CynaraKrewe/Cynara/Software/flow_tests/pinmux/summary.csv

Pin# | PORT IO | Function | Directions
33 | PA0 | U0RX
34 | PA1 | U0TX
