CynaraKrewe/Cynara/(threads)

Thread 3 (2016-05-07):

Create and connect all power planes and rails.

CynaraKrewe, 2016-05-07:

m-spiessens, 2016-05-25:
Includes +1.2V plane for FPGA.

m-spiessens, 2016-05-25:
Make the +5V selectable from either USB or the Power Petal.

Closed 2016-06-01.

Thread 6 (2016-05-10):

Shield & mounting holes

CynaraKrewe, 2016-05-10:

m-spiessens, 2016-06-29:
Fixed.

Closed 2016-06-29.

Thread 9 (2016-05-11):

documenting layer stack and trace impedance

CynaraKrewe, 2016-05-11:
documenting PCB propperties in latex

m-spiessens, 2016-05-27:
Updated documentation with the correct trace impedance.

Closed 2016-06-01.

Thread 11 (2016-05-18):

Replace USB type C connector with USB type B connector.

m-spiessens, 2016-05-18:
The first version of the Cynara carrier board shouldn't be too fancypants.

Closed 2016-05-25.

Thread 16 (2016-06-15):

Put jumpers to disconnect power planes for prototype.

m-spiessens, 2016-06-15:

m-spiessens, 2016-06-29:
Fixed.

Closed 2016-06-29.

Thread 20 (2016-10-04):

Fix text on silkscreen.

m-spiessens, 2016-10-04:

Thread 21 (2016-10-04):

Put vias to prevent antennas.

m-spiessens, 2016-10-04:
