CynaraKrewe/Cynara/Hardware/Cynara Viride.brd

## EAGLE design Hardware/Cynara Viride.brd (2016-10-19)

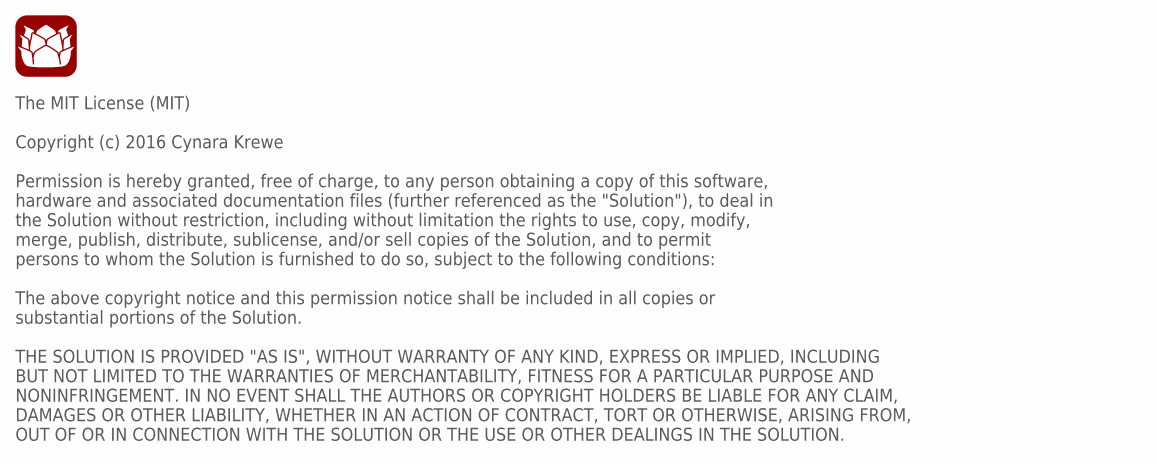
[picture p1: schematic Cynara Viride.sch, sheet 1, License]

Parts:
U$21: CYNARA_FRONT; CYNARA_BELOW_W15MM

Notes on the sheet:
The MIT License (MIT) Copyright (c) 2016 Cynara Krewe Permission is hereby granted, free of charge, to any person obtaining a copy of this software, hardware and associated documentation files (further referenced as the "Solution"), to deal in the Solution without restriction, including without lim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

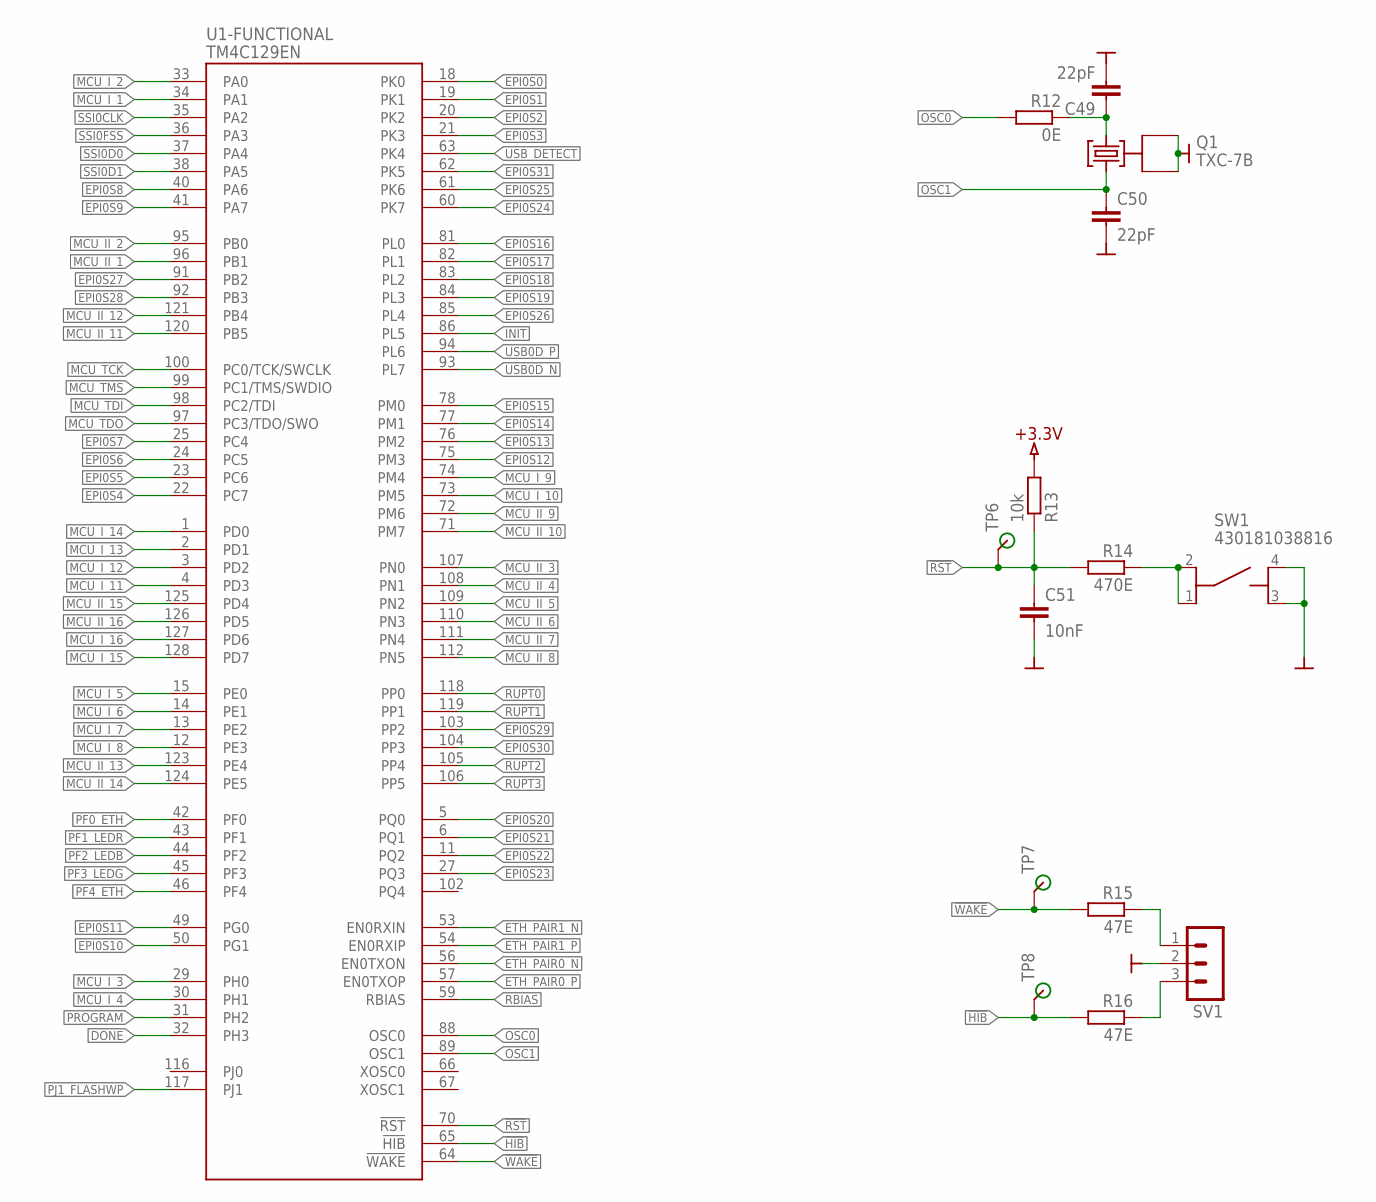
[picture p2: schematic Cynara Viride.sch, sheet 2, MCU: IO pins]

Parts:
C49, C50: 22pF; C0603
C51: 10nF; C0603
Q1: TXC-7B
R12: 0E; R0603
R13: 10k; R0603
R14: 470E; R0603
R15, R16: 47E; R0603
SV1: MA03-1
SW1: 430181038816
TP6, TP7, TP8: TP-SMD
U1: TM4C129EN; S-PQFP-G128

Connections:
!HIB: R16.2, TP8.1, U1.65 (!HIB)
!RST: C51.1, R13.1, R14.2, TP6.1, U1.70 (!RST); also elsewhere on the board
!WAKE: R15.2, TP7.1, U1.64 (!WAKE)
+3.3V: R13.2; also elsewhere on the board
DONE: U1.32 (PH3); also elsewhere on the board
EPI0S0: U1.18 (PK0); also elsewhere on the board
EPI0S1: U1.19 (PK1); also elsewhere on the board
EPI0S2: U1.20 (PK2); also elsewhere on the board
EPI0S3: U1.21 (PK3); also elsewhere on the board
EPI0S4: U1.22 (PC7); also elsewhere on the board
EPI0S5: U1.23 (PC6); also elsewhere on the board
EPI0S6: U1.24 (PC5); also elsewhere on the board
EPI0S7: U1.25 (PC4); also elsewhere on the board
EPI0S8: U1.40 (PA6); also elsewhere on the board
EPI0S9: U1.41 (PA7); also elsewhere on the board
EPI0S10: U1.50 (PG1); also elsewhere on the board
EPI0S11: U1.49 (PG0); also elsewhere on the board
EPI0S12: U1.75 (PM3); also elsewhere on the board
EPI0S13: U1.76 (PM2); also elsewhere on the board
EPI0S14: U1.77 (PM1); also elsewhere on the board
EPI0S15: U1.78 (PM0); also elsewhere on the board
EPI0S16: U1.81 (PL0); also elsewhere on the board
EPI0S17: U1.82 (PL1); also elsewhere on the board
EPI0S18: U1.83 (PL2); also elsewhere on the board
EPI0S19: U1.84 (PL3); also elsewhere on the board
EPI0S20: U1.5 (PQ0); also elsewhere on the board
EPI0S21: U1.6 (PQ1); also elsewhere on the board
EPI0S22: U1.11 (PQ2); also elsewhere on the board
EPI0S23: U1.27 (PQ3); also elsewhere on the board
EPI0S24: U1.60 (PK7); also elsewhere on the board
EPI0S25: U1.61 (PK6); also elsewhere on the board
EPI0S26: U1.85 (PL4); also elsewhere on the board
EPI0S27: U1.91 (PB2); also elsewhere on the board
EPI0S28: U1.92 (PB3); also elsewhere on the board
EPI0S29: U1.103 (PP2); also elsewhere on the board
EPI0S30: U1.104 (PP3); also elsewhere on the board
EPI0S31: U1.62 (PK5); also elsewhere on the board
ETH_PAIR0_N: U1.56 (EN0TXON); also elsewhere on the board
ETH_PAIR0_P: U1.57 (EN0TXOP); also elsewhere on the board
ETH_PAIR1_N: U1.53 (EN0RXIN); also elsewhere on the board
ETH_PAIR1_P: U1.54 (EN0RXIP); also elsewhere on the board
GND: C49.2, C50.2, C51.2, Q1.2 (GND), Q1.4 (GND), SV1.2, SW1.3, SW1.4; also elsewhere on the board
INIT: U1.86 (PL5); also elsewhere on the board
MCU_II_1: U1.96 (PB1); also elsewhere on the board
MCU_II_2: U1.95 (PB0); also elsewhere on the board
MCU_II_3: U1.107 (PN0); also elsewhere on the board
MCU_II_4: U1.108 (PN1); also elsewhere on the board
MCU_II_5: U1.109 (PN2); also elsewhere on the board
MCU_II_6: U1.110 (PN3); also elsewhere on the board
MCU_II_7: U1.111 (PN4); also elsewhere on the board
MCU_II_8: U1.112 (PN5); also elsewhere on the board
MCU_II_9: U1.72 (PM6); also elsewhere on the board
MCU_II_10: U1.71 (PM7); also elsewhere on the board
MCU_II_11: U1.120 (PB5); also elsewhere on the board
MCU_II_12: U1.121 (PB4); also elsewhere on the board
MCU_II_13: U1.123 (PE4); also elsewhere on the board
MCU_II_14: U1.124 (PE5); also elsewhere on the board
MCU_II_15: U1.125 (PD4); also elsewhere on the board
MCU_II_16: U1.126 (PD5); also elsewhere on the board
MCU_I_1: U1.34 (PA1); also elsewhere on the board
MCU_I_2: U1.33 (PA0); also elsewhere on the board
MCU_I_3: U1.29 (PH0); also elsewhere on the board
MCU_I_4: U1.30 (PH1); also elsewhere on the board
MCU_I_5: U1.15 (PE0); also elsewhere on the board
MCU_I_6: U1.14 (PE1); also elsewhere on the board
MCU_I_7: U1.13 (PE2); also elsewhere on the board
MCU_I_8: U1.12 (PE3); also elsewhere on the board
MCU_I_9: U1.74 (PM4); also elsewhere on the board
MCU_I_10: U1.73 (PM5); also elsewhere on the board
MCU_I_11: U1.4 (PD3); also elsewhere on the board
MCU_I_12: U1.3 (PD2); also elsewhere on the board
MCU_I_13: U1.2 (PD1); also elsewhere on the board
MCU_I_14: U1.1 (PD0); also elsewhere on the board
MCU_I_15: U1.128 (PD7); also elsewhere on the board
MCU_I_16: U1.127 (PD6); also elsewhere on the board
MCU_TCK: U1.100 (PC0/TCK/SWCLK); also elsewhere on the board
MCU_TDI: U1.98 (PC2/TDI); also elsewhere on the board
MCU_TDO: U1.97 (PC3/TDO/SWO); also elsewhere on the board
MCU_TMS: U1.99 (PC1/TMS/SWDIO); also elsewhere on the board
unnamed: R15.1, SV1.1
unnamed: C49.1, Q1.1 (XTALA), R12.1
unnamed: R14.1, SW1.1, SW1.2
unnamed: R16.1, SV1.3
OSC0: R12.2, U1.88 (OSC0)
OSC1: C50.1, Q1.3 (XTALB), U1.89 (OSC1)
PF0_ETH: U1.42 (PF0); also elsewhere on the board
PF1_LEDR: U1.43 (PF1); also elsewhere on the board
PF2_LEDB: U1.44 (PF2); also elsewhere on the board
PF3_LEDG: U1.45 (PF3); also elsewhere on the board
PF4_ETH: U1.46 (PF4); also elsewhere on the board
PJ1_FLASHWP: U1.117 (PJ1); also elsewhere on the board
PROGRAM: U1.31 (PH2); also elsewhere on the board
RBIAS: U1.59 (RBIAS); also elsewhere on the board
RUPT0: U1.118 (PP0); also elsewhere on the board
RUPT1: U1.119 (PP1); also elsewhere on the board
RUPT2: U1.105 (PP4); also elsewhere on the board
RUPT3: U1.106 (PP5); also elsewhere on the board
SSI0CLK: U1.35 (PA2); also elsewhere on the board
SSI0D0: U1.37 (PA4); also elsewhere on the board
SSI0D1: U1.38 (PA5); also elsewhere on the board
SSI0FSS: U1.36 (PA3); also elsewhere on the board
USB0D_N: U1.93 (PL7); also elsewhere on the board
USB0D_P: U1.94 (PL6); also elsewhere on the board
USB_DETECT: U1.63 (PK4); also elsewhere on the board

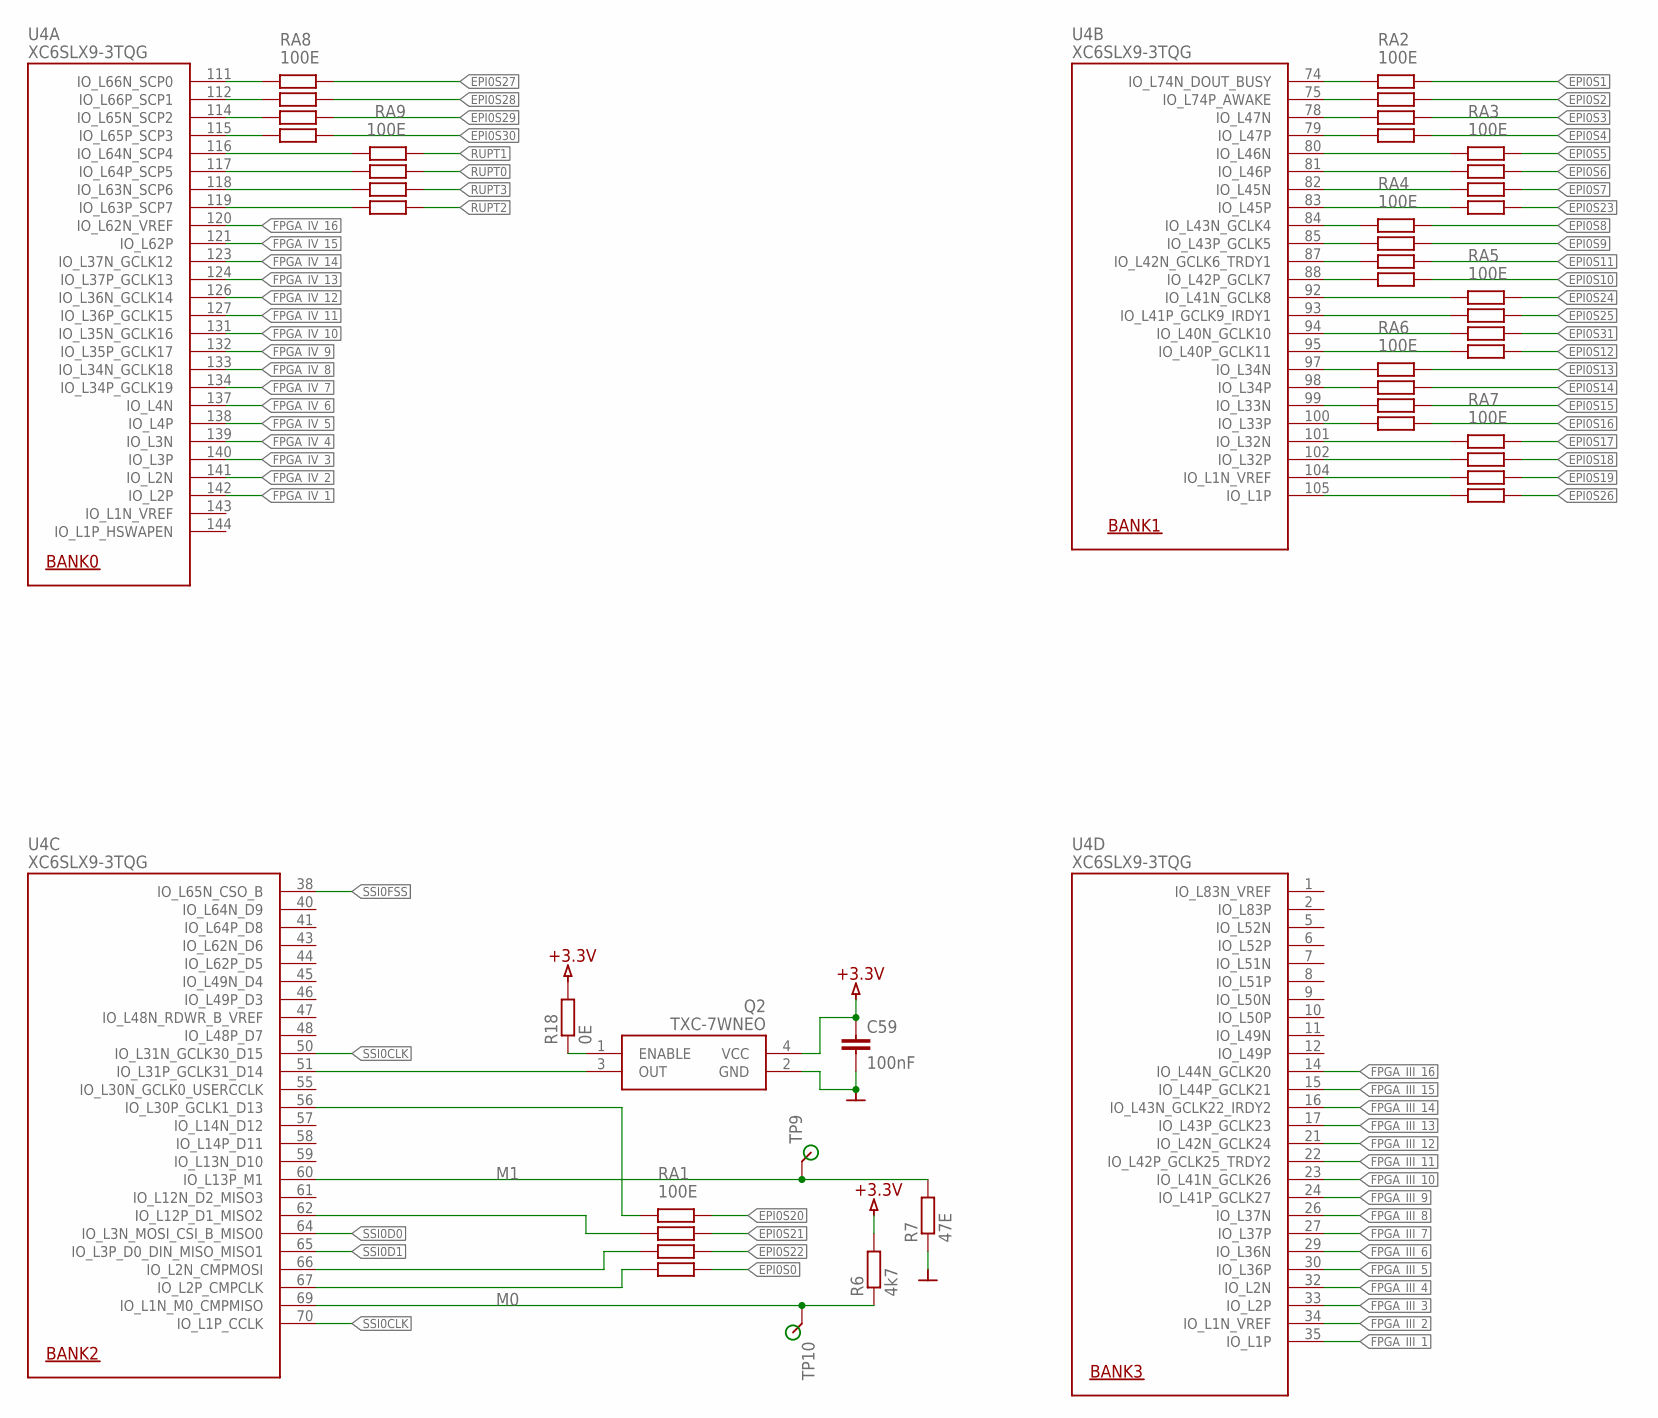
[picture p3: schematic Cynara Viride.sch, sheet 3, FPGA IO pins]

Parts:
C59: 100nF; C0603
Q2: TXC-7WNEO; TXC-7W
R6: 4k7; R0603
R7: 47E; R0603
R18: 0E; R0603
RA1, RA2, RA3, RA4, RA5, RA6, RA7, RA8, RA9: 100E; CRA06S
TP9, TP10: TP-SMD
U4: XC6SLX9-3TQG; TQG144

Connections:
+3.3V: C59.1, Q2.4 (VCC), R6.2, R18.2; also elsewhere on the board
EPI0S0: RA1.4B; also elsewhere on the board
EPI0S1: RA2.1B; also elsewhere on the board
EPI0S2: RA2.2B; also elsewhere on the board
EPI0S3: RA2.3B; also elsewhere on the board
EPI0S4: RA2.4B; also elsewhere on the board
EPI0S5: RA3.1B; also elsewhere on the board
EPI0S6: RA3.2B; also elsewhere on the board
EPI0S7: RA3.3B; also elsewhere on the board
EPI0S8: RA4.1B; also elsewhere on the board
EPI0S9: RA4.2B; also elsewhere on the board
EPI0S10: RA4.4B; also elsewhere on the board
EPI0S11: RA4.3B; also elsewhere on the board
EPI0S12: RA5.4B; also elsewhere on the board
EPI0S13: RA6.1B; also elsewhere on the board
EPI0S14: RA6.2B; also elsewhere on the board
EPI0S15: RA6.3B; also elsewhere on the board
EPI0S16: RA6.4B; also elsewhere on the board
EPI0S17: RA7.1B; also elsewhere on the board
EPI0S18: RA7.2B; also elsewhere on the board
EPI0S19: RA7.3B; also elsewhere on the board
EPI0S20: RA1.1B; also elsewhere on the board
EPI0S21: RA1.2B; also elsewhere on the board
EPI0S22: RA1.3B; also elsewhere on the board
EPI0S23: RA3.4B; also elsewhere on the board
EPI0S24: RA5.1B; also elsewhere on the board
EPI0S25: RA5.2B; also elsewhere on the board
EPI0S26: RA7.4B; also elsewhere on the board
EPI0S27: RA8.1B; also elsewhere on the board
EPI0S28: RA8.2B; also elsewhere on the board
EPI0S29: RA8.3B; also elsewhere on the board
EPI0S30: RA8.4B; also elsewhere on the board
EPI0S31: RA5.3B; also elsewhere on the board
FPGA_EPI0S0: RA1.4A, U4.67 (IO_L2P_CMPCLK)
FPGA_EPI0S1: RA2.1A, U4.74 (IO_L74N_DOUT_BUSY)
FPGA_EPI0S2: RA2.2A, U4.75 (IO_L74P_AWAKE)
FPGA_EPI0S3: RA2.3A, U4.78 (IO_L47N)
FPGA_EPI0S4: RA2.4A, U4.79 (IO_L47P)
FPGA_EPI0S5: RA3.1A, U4.80 (IO_L46N)
FPGA_EPI0S6: RA3.2A, U4.81 (IO_L46P)
FPGA_EPI0S7: RA3.3A, U4.82 (IO_L45N)
FPGA_EPI0S8: RA4.1A, U4.84 (IO_L43N_GCLK4)
FPGA_EPI0S9: RA4.2A, U4.85 (IO_L43P_GCLK5)
FPGA_EPI0S10: RA4.4A, U4.88 (IO_L42P_GCLK7)
FPGA_EPI0S11: RA4.3A, U4.87 (IO_L42N_GCLK6_TRDY1)
FPGA_EPI0S12: RA5.4A, U4.95 (IO_L40P_GCLK11)
FPGA_EPI0S13: RA6.1A, U4.97 (IO_L34N)
FPGA_EPI0S14: RA6.2A, U4.98 (IO_L34P)
FPGA_EPI0S15: RA6.3A, U4.99 (IO_L33N)
FPGA_EPI0S16: RA6.4A, U4.100 (IO_L33P)
FPGA_EPI0S17: RA7.1A, U4.101 (IO_L32N)
FPGA_EPI0S18: RA7.2A, U4.102 (IO_L32P)
FPGA_EPI0S19: RA7.3A, U4.104 (IO_L1N_VREF)
FPGA_EPI0S20: RA1.1A, U4.56 (IO_L30P_GCLK1_D13)
FPGA_EPI0S21: RA1.2A, U4.62 (IO_L12P_D1_MISO2)
FPGA_EPI0S22: RA1.3A, U4.66 (IO_L2N_CMPMOSI)
FPGA_EPI0S23: RA3.4A, U4.83 (IO_L45P)
FPGA_EPI0S24: RA5.1A, U4.92 (IO_L41N_GCLK8)
FPGA_EPI0S25: RA5.2A, U4.93 (IO_L41P_GCLK9_IRDY1)
FPGA_EPI0S26: RA7.4A, U4.105 (IO_L1P)
FPGA_EPI0S27: RA8.1A, U4.111 (IO_L66N_SCP0)
FPGA_EPI0S28: RA8.2A, U4.112 (IO_L66P_SCP1)
FPGA_EPI0S29: RA8.3A, U4.114 (IO_L65N_SCP2)
FPGA_EPI0S30: RA8.4A, U4.115 (IO_L65P_SCP3)
FPGA_EPI0S31: RA5.3A, U4.94 (IO_L40N_GCLK10)
FPGA_III_1: U4.35 (IO_L1P); also elsewhere on the board
FPGA_III_2: U4.34 (IO_L1N_VREF); also elsewhere on the board
FPGA_III_3: U4.33 (IO_L2P); also elsewhere on the board
FPGA_III_4: U4.32 (IO_L2N); also elsewhere on the board
FPGA_III_5: U4.30 (IO_L36P); also elsewhere on the board
FPGA_III_6: U4.29 (IO_L36N); also elsewhere on the board
FPGA_III_7: U4.27 (IO_L37P); also elsewhere on the board
FPGA_III_8: U4.26 (IO_L37N); also elsewhere on the board
FPGA_III_9: U4.24 (IO_L41P_GCLK27); also elsewhere on the board
FPGA_III_10: U4.23 (IO_L41N_GCLK26); also elsewhere on the board
FPGA_III_11: U4.22 (IO_L42P_GCLK25_TRDY2); also elsewhere on the board
FPGA_III_12: U4.21 (IO_L42N_GCLK24); also elsewhere on the board
FPGA_III_13: U4.17 (IO_L43P_GCLK23); also elsewhere on the board
FPGA_III_14: U4.16 (IO_L43N_GCLK22_IRDY2); also elsewhere on the board
FPGA_III_15: U4.15 (IO_L44P_GCLK21); also elsewhere on the board
FPGA_III_16: U4.14 (IO_L44N_GCLK20); also elsewhere on the board
FPGA_IV_1: U4.142 (IO_L2P); also elsewhere on the board
FPGA_IV_2: U4.141 (IO_L2N); also elsewhere on the board
FPGA_IV_3: U4.140 (IO_L3P); also elsewhere on the board
FPGA_IV_4: U4.139 (IO_L3N); also elsewhere on the board
FPGA_IV_5: U4.138 (IO_L4P); also elsewhere on the board
FPGA_IV_6: U4.137 (IO_L4N); also elsewhere on the board
FPGA_IV_7: U4.134 (IO_L34P_GCLK19); also elsewhere on the board
FPGA_IV_8: U4.133 (IO_L34N_GCLK18); also elsewhere on the board
FPGA_IV_9: U4.132 (IO_L35P_GCLK17); also elsewhere on the board
FPGA_IV_10: U4.131 (IO_L35N_GCLK16); also elsewhere on the board
FPGA_IV_11: U4.127 (IO_L36P_GCLK15); also elsewhere on the board
FPGA_IV_12: U4.126 (IO_L36N_GCLK14); also elsewhere on the board
FPGA_IV_13: U4.124 (IO_L37P_GCLK13); also elsewhere on the board
FPGA_IV_14: U4.123 (IO_L37N_GCLK12); also elsewhere on the board
FPGA_IV_15: U4.121 (IO_L62P); also elsewhere on the board
FPGA_IV_16: U4.120 (IO_L62N_VREF); also elsewhere on the board
FPGA_OSC: Q2.3 (OUT), U4.51 (IO_L31P_GCLK31_D14)
FPGA_RUPT0: RA9.2B, U4.117 (IO_L64P_SCP5)
FPGA_RUPT1: RA9.1B, U4.116 (IO_L64N_SCP4)
FPGA_RUPT2: RA9.4B, U4.119 (IO_L63P_SCP7)
FPGA_RUPT3: RA9.3B, U4.118 (IO_L63N_SCP6)
GND: C59.2, Q2.2 (GND), R7.1; also elsewhere on the board
M0: R6.1, TP10.1, U4.69 (IO_L1N_M0_CMPMISO)
M1: R7.2, TP9.1, U4.60 (IO_L13P_M1)
unnamed: Q2.1 (ENABLE), R18.1
RUPT0: RA9.2A; also elsewhere on the board
RUPT1: RA9.1A; also elsewhere on the board
RUPT2: RA9.4A; also elsewhere on the board
RUPT3: RA9.3A; also elsewhere on the board
SSI0CLK: U4.50 (IO_L31N_GCLK30_D15), U4.70 (IO_L1P_CCLK); also elsewhere on the board
SSI0D0: U4.64 (IO_L3N_MOSI_CSI_B_MISO0); also elsewhere on the board
SSI0D1: U4.65 (IO_L3P_D0_DIN_MISO_MISO1); also elsewhere on the board
SSI0FSS: U4.38 (IO_L65N_CSO_B); also elsewhere on the board

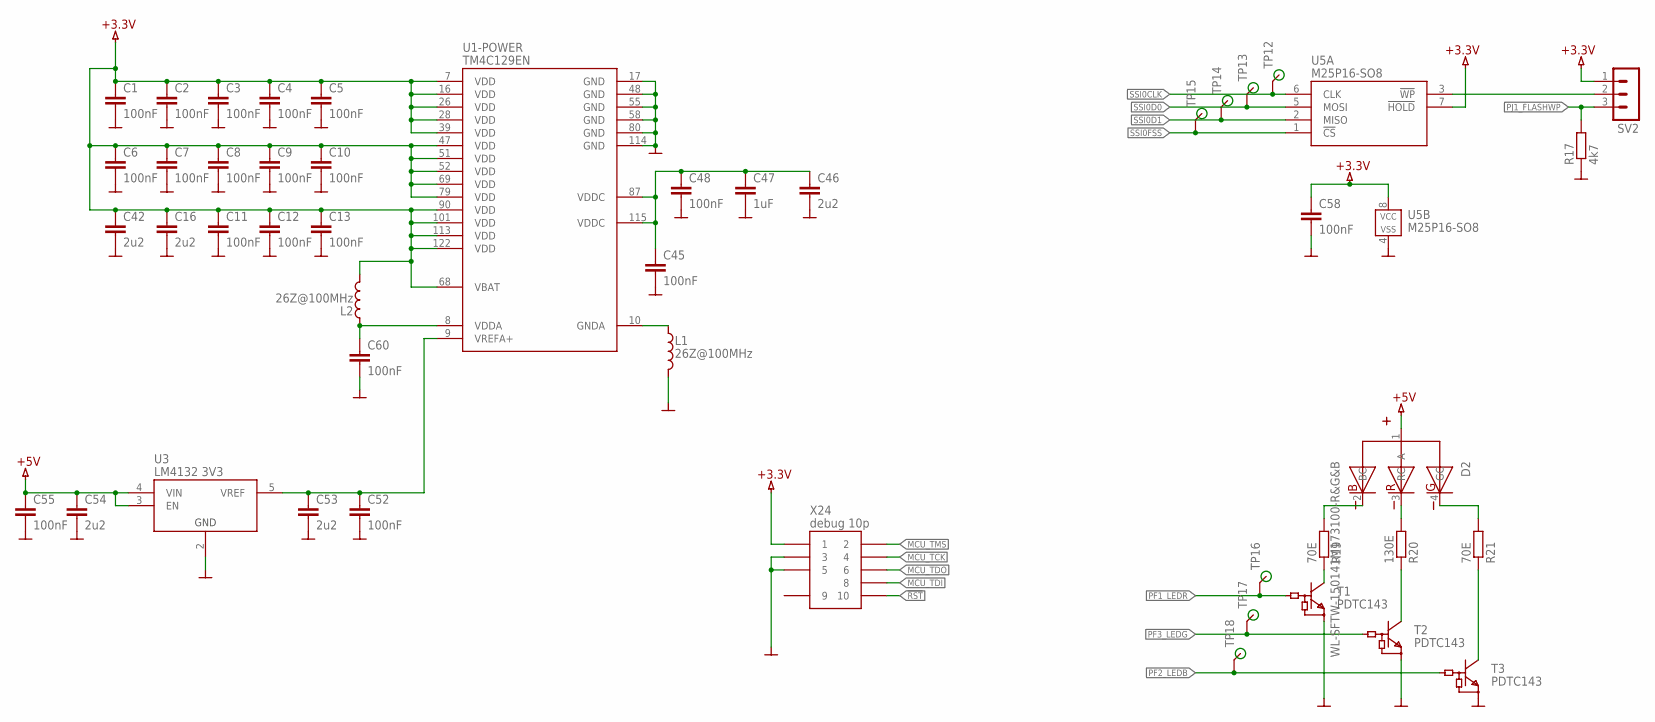
[picture p4: schematic Cynara Viride.sch, sheet 4, MCU: Programming and power]

Parts:
C1, C2, C3, C4, C5, C6, C7, C8, C9, C10, C11, C12, C13, C45, C48, C52, C55, C58, C60: 100nF; C0603
C16, C42, C46, C53, C54: 2u2; C0603
C47: 1uF; C0603
D2: WL-SFTW-150141M173100-R&G&B; 3528-COMMON-ANODE
L1, L2: 26Z@100MHz; L1608
R17: 4k7; R0603
R19, R21: 70E; R0603
R20: 130E; R0603
SV2: MA03-1
T1, T2, T3: PDTC143; SOT23-3
TP12, TP13, TP14, TP15, TP16, TP17, TP18: TP-SMD
U1: TM4C129EN; S-PQFP-G128
U3: LM4132 3V3; DBV(R-PDSO-G5)
U5: M25P16-SO8; SOIC127P600X120-8N
X24: debug 10p; DEBUG-CORTEXM10

Connections:
!RST: X24.10; also elsewhere on the board
+3.3V: C1.1, C2.1, C3.1, C4.1, C5.1, C6.1, C7.1, C8.1, C9.1, C10.1, C11.1, C12.1, C13.1, C16.1, C42.1, C58.1, L2.2 (F), SV2.1, U1.7 (VDD), U1.16 (VDD), U1.26 (VDD), U1.28 (VDD), U1.39 (VDD), U1.47 (VDD), U1.51 (VDD), U1.52 (VDD), U1.68 (VBAT), U1.69 (VDD), U1.79 (VDD), U1.90 (VDD), U1.101 (VDD), U1.113 (VDD), U1.122 (VDD), U5.7 (!HOLD), U5.8 (VCC), X24.1; also elsewhere on the board
+5V: C54.1, C55.1, D2.1 (A), U3.3 (EN), U3.4 (VIN); also elsewhere on the board
GND: C1.2, C2.2, C3.2, C4.2, C5.2, C6.2, C7.2, C8.2, C9.2, C10.2, C11.2, C12.2, C13.2, C16.2, C42.2, C45.2, C46.2, C47.2, C48.2, C52.2, C53.2, C54.2, C55.2, C58.2, C60.2, L1.2 (F), R17.1, T1.2 (E), T2.2 (E), T3.2 (E), U1.17 (GND), U1.48 (GND), U1.55 (GND), U1.58 (GND), U1.80 (GND), U1.114 (GND), U3.2 (GND), U5.4 (VSS), X24.3, X24.5; also elsewhere on the board
GNDA: L1.1 (E), U1.10 (GNDA)
MCU_TCK: X24.4; also elsewhere on the board
MCU_TDI: X24.8; also elsewhere on the board
MCU_TDO: X24.6; also elsewhere on the board
MCU_TMS: X24.2; also elsewhere on the board
unnamed: D2.2 (BC), R19.2
unnamed: D2.3 (RC), R20.2
unnamed: D2.4 (GC), R21.2
unnamed: R19.1, T1.3 (C)
unnamed: R20.1, T2.3 (C)
unnamed: R21.1, T3.3 (C)
PF1_LEDR: T1.1 (B), TP16.1; also elsewhere on the board
PF2_LEDB: T3.1 (B), TP18.1; also elsewhere on the board
PF3_LEDG: T2.1 (B), TP17.1; also elsewhere on the board
PJ1X: SV2.2, U5.3 (!WP)
PJ1_FLASHWP: R17.2, SV2.3; also elsewhere on the board
SSI0CLK: TP12.1, U5.6 (CLK); also elsewhere on the board
SSI0D0: TP13.1, U5.5 (MOSI); also elsewhere on the board
SSI0D1: TP14.1, U5.2 (MISO); also elsewhere on the board
SSI0FSS: TP15.1, U5.1 (!CS); also elsewhere on the board
VDDA: C60.1, L2.1 (E), U1.8 (VDDA)
VDDC: C45.1, C46.1, C47.1, C48.1, U1.87 (VDDC), U1.115 (VDDC)
VREFA+: C52.1, C53.1, U1.9 (VREFA+), U3.5 (VREF)

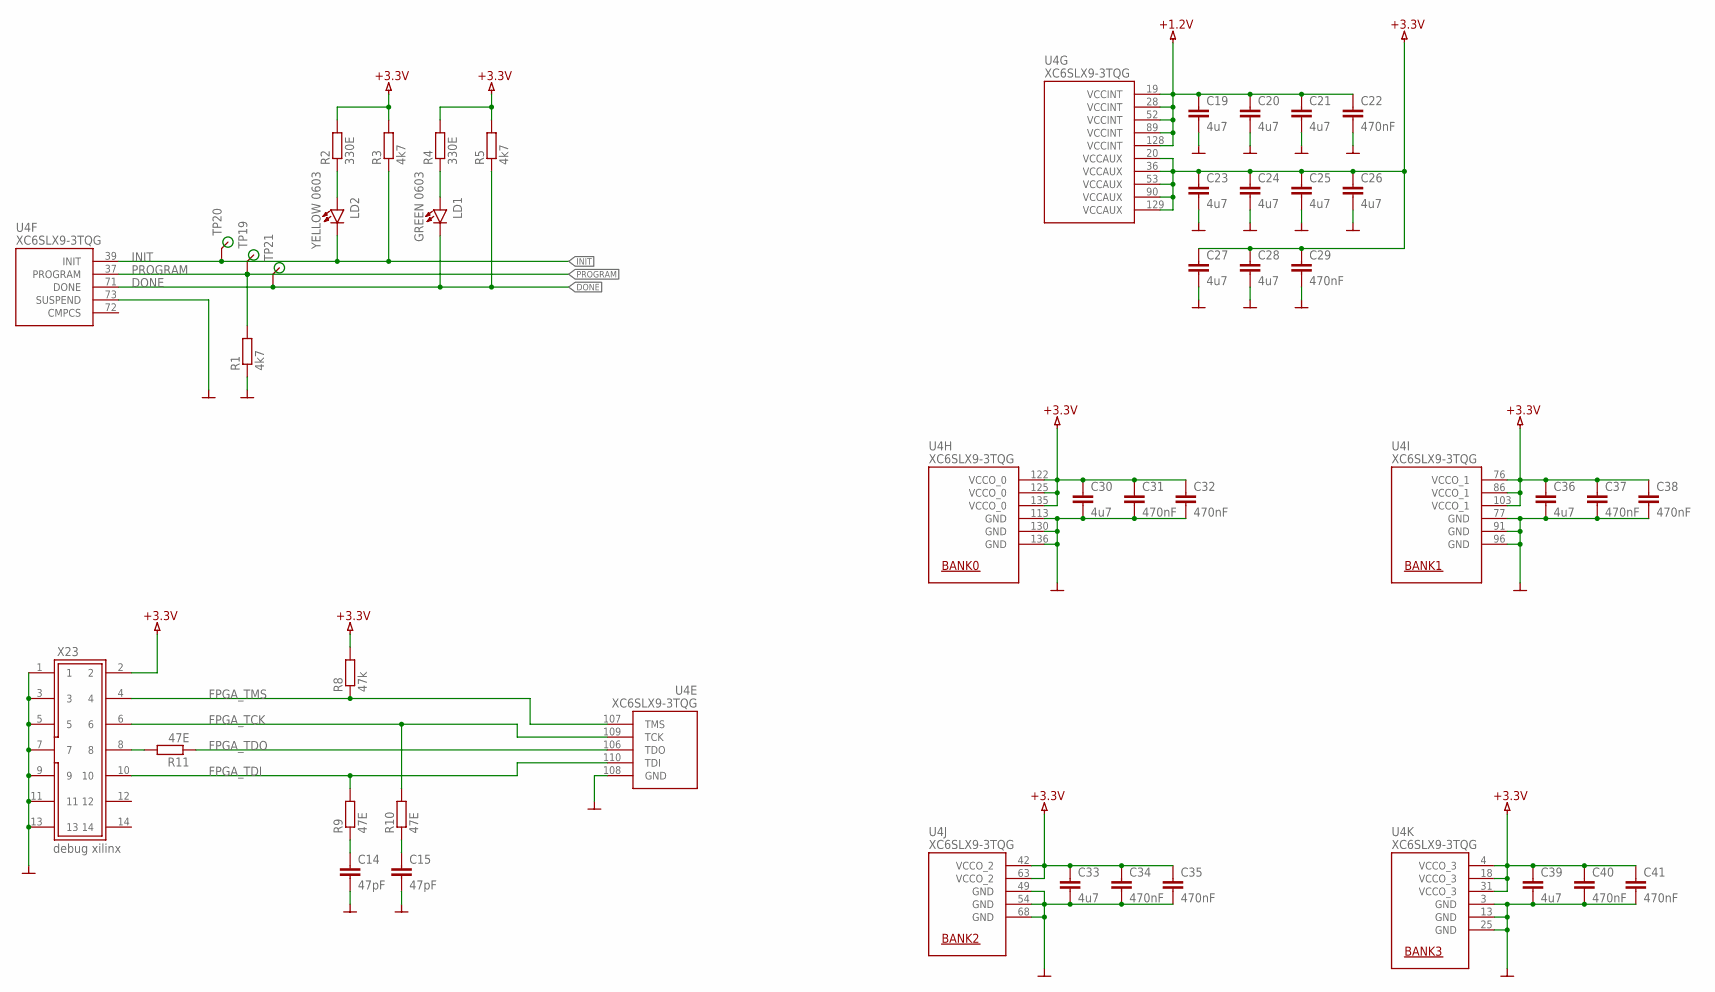
[picture p5: schematic Cynara Viride.sch, sheet 5, FPGA: Programming and power]

Parts:
C14, C15: 47pF; C0603
C19, C20, C21, C23, C24, C25, C26, C27, C28, C30, C33, C36, C39: 4u7; C0603
C22, C29, C31, C32, C34, C35, C37, C38, C40, C41: 470nF; C0603
LD1: GREEN 0603; LED_1608
LD2: YELLOW 0603; LED_1608
R1, R3, R5: 4k7; R0603
R2, R4: 330E; R0603
R8: 47k; R0603
R9, R10, R11: 47E; R0603
TP19, TP20, TP21: TP-SMD
U4: XC6SLX9-3TQG; TQG144
X23: debug xilinx; 87832-1420

Connections:
+1.2V: C19.1, C20.1, C21.1, C22.1, U4.19 (VCCINT), U4.28 (VCCINT), U4.52 (VCCINT), U4.89 (VCCINT), U4.128 (VCCINT); also elsewhere on the board
+3.3V: C23.1, C24.1, C25.1, C26.1, C27.1, C28.1, C29.1, C30.1, C31.1, C32.1, C33.1, C34.1, C35.1, C36.1, C37.1, C38.1, C39.1, C40.1, C41.1, R2.2, R3.2, R4.2, R5.2, R8.2, U4.4 (VCCO_3), U4.18 (VCCO_3), U4.20 (VCCAUX), U4.31 (VCCO_3), U4.36 (VCCAUX), U4.42 (VCCO_2), U4.53 (VCCAUX), U4.63 (VCCO_2), U4.76 (VCCO_1), U4.86 (VCCO_1), U4.90 (VCCAUX), U4.103 (VCCO_1), U4.122 (VCCO_0), U4.125 (VCCO_0), U4.129 (VCCAUX), U4.135 (VCCO_0), X23.2; also elsewhere on the board
DONE: LD1.C (K), R5.1, TP21.1, U4.71 (DONE); also elsewhere on the board
FPGA_TCK: R10.2, U4.109 (TCK), X23.6
FPGA_TDI: R9.2, U4.110 (TDI), X23.10
FPGA_TDO: R11.1, U4.106 (TDO)
FPGA_TMS: R8.1, U4.107 (TMS), X23.4
GND: C14.2, C15.2, C19.2, C20.2, C21.2, C22.2, C23.2, C24.2, C25.2, C26.2, C27.2, C28.2, C29.2, C30.2, C31.2, C32.2, C33.2, C34.2, C35.2, C36.2, C37.2, C38.2, C39.2, C40.2, C41.2, R1.1, U4.3 (GND), U4.13 (GND), U4.25 (GND), U4.49 (GND), U4.54 (GND), U4.68 (GND), U4.73 (SUSPEND), U4.77 (GND), U4.91 (GND), U4.96 (GND), U4.108 (GND), U4.113 (GND), U4.130 (GND), U4.136 (GND), X23.1, X23.3, X23.5, X23.7, X23.9, X23.11, X23.13; also elsewhere on the board
INIT: LD2.C (K), R3.1, TP20.1, U4.39 (INIT); also elsewhere on the board
unnamed: LD2.A, R2.1
unnamed: LD1.A, R4.1
unnamed: C14.1, R9.1
unnamed: C15.1, R10.1
unnamed: R11.2, X23.8
PROGRAM: R1.2, TP19.1, U4.37 (PROGRAM); also elsewhere on the board

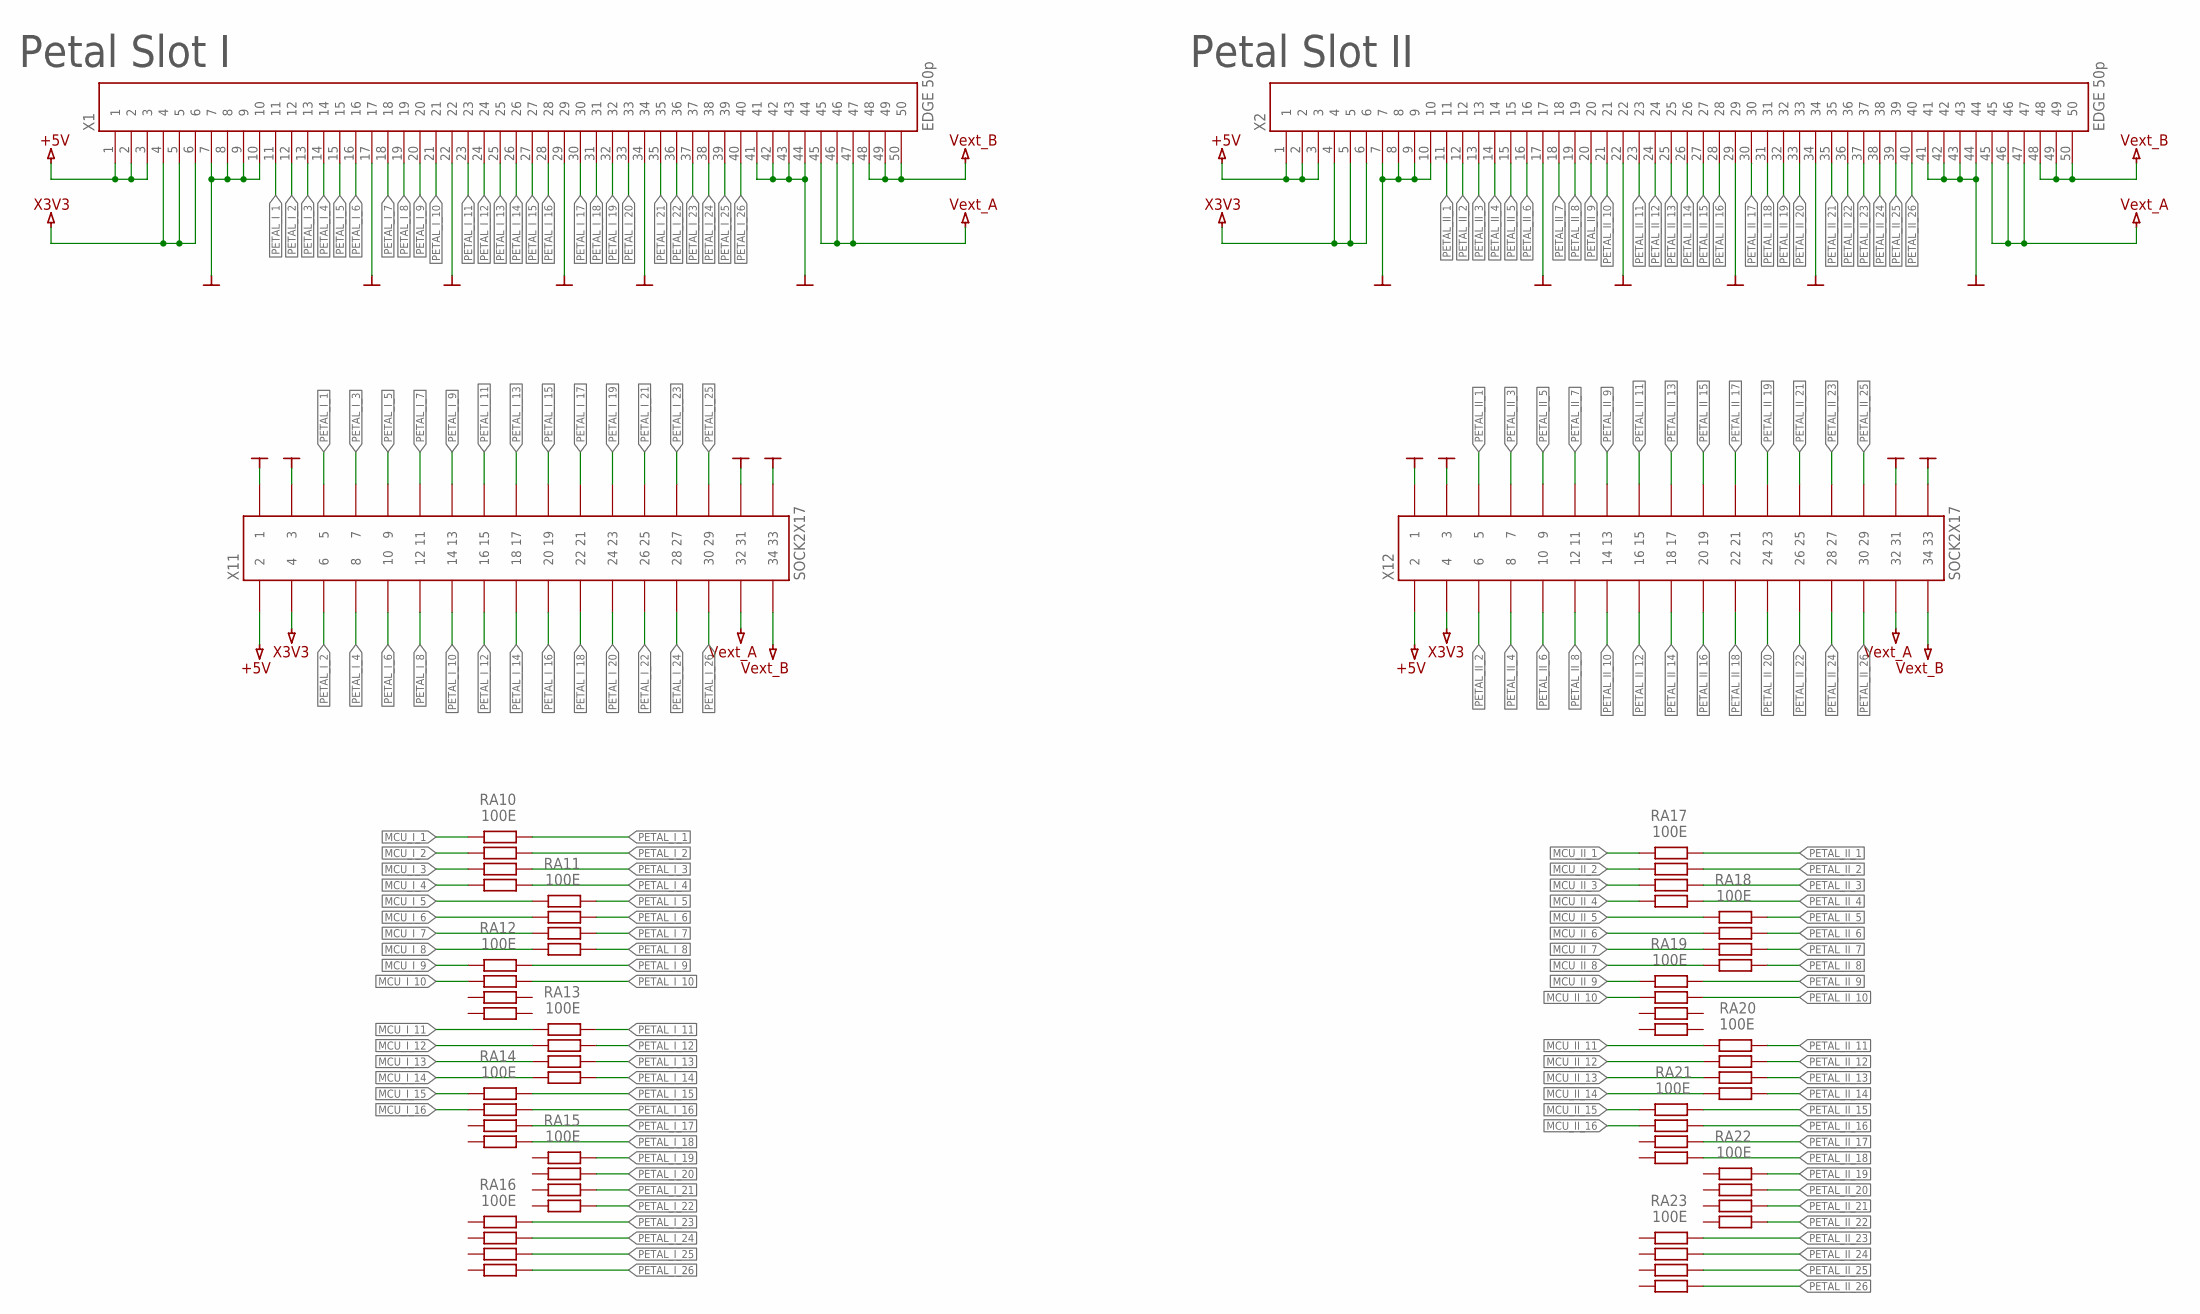
[picture p6: schematic Cynara Viride.sch, sheet 6, Petal I II]

Parts:
RA10, RA11, RA12, RA13, RA14, RA15, RA16, RA17, RA18, RA19, RA20, RA21, RA22, RA23: 100E; CRA06S
X1, X2: EDGE 50p; MB1-150-01-XX-S-XX-SL
X11, X12: SOCK2X17; 2X17P-FEMALE

Connections:
+5V: X1.1, X1.2, X1.3, X2.1, X2.2, X2.3, X11.2, X12.2; also elsewhere on the board
GND: X1.7, X1.8, X1.9, X1.10, X1.17, X1.22, X1.29, X1.34, X1.41, X1.42, X1.43, X1.44, X2.7, X2.8, X2.9, X2.10, X2.17, X2.22, X2.29, X2.34, X2.41, X2.42, X2.43, X2.44, X11.1, X11.3, X11.31, X11.33, X12.1, X12.3, X12.31, X12.33; also elsewhere on the board
MCU_II_1: RA17.1B; also elsewhere on the board
MCU_II_2: RA17.2B; also elsewhere on the board
MCU_II_3: RA17.3B; also elsewhere on the board
MCU_II_4: RA17.4B; also elsewhere on the board
MCU_II_5: RA18.1B; also elsewhere on the board
MCU_II_6: RA18.2B; also elsewhere on the board
MCU_II_7: RA18.3B; also elsewhere on the board
MCU_II_8: RA18.4B; also elsewhere on the board
MCU_II_9: RA19.1B; also elsewhere on the board
MCU_II_10: RA19.2B; also elsewhere on the board
MCU_II_11: RA20.1A; also elsewhere on the board
MCU_II_12: RA20.2A; also elsewhere on the board
MCU_II_13: RA20.3A; also elsewhere on the board
MCU_II_14: RA20.4A; also elsewhere on the board
MCU_II_15: RA21.1A; also elsewhere on the board
MCU_II_16: RA21.2A; also elsewhere on the board
MCU_I_1: RA10.1B; also elsewhere on the board
MCU_I_2: RA10.2B; also elsewhere on the board
MCU_I_3: RA10.3B; also elsewhere on the board
MCU_I_4: RA10.4B; also elsewhere on the board
MCU_I_5: RA11.1B; also elsewhere on the board
MCU_I_6: RA11.2B; also elsewhere on the board
MCU_I_7: RA11.3B; also elsewhere on the board
MCU_I_8: RA11.4B; also elsewhere on the board
MCU_I_9: RA12.1B; also elsewhere on the board
MCU_I_10: RA12.2B; also elsewhere on the board
MCU_I_11: RA13.1B; also elsewhere on the board
MCU_I_12: RA13.2B; also elsewhere on the board
MCU_I_13: RA13.3B; also elsewhere on the board
MCU_I_14: RA13.4B; also elsewhere on the board
MCU_I_15: RA14.1B; also elsewhere on the board
MCU_I_16: RA14.2B; also elsewhere on the board
PETAL_II_1: RA17.1A, X2.11, X12.5
PETAL_II_2: RA17.2A, X2.12, X12.6
PETAL_II_3: RA17.3A, X2.13, X12.7
PETAL_II_4: RA17.4A, X2.14, X12.8
PETAL_II_5: RA18.1A, X2.15, X12.9
PETAL_II_6: RA18.2A, X2.16, X12.10
PETAL_II_7: RA18.3A, X2.18, X12.11
PETAL_II_8: RA18.4A, X2.19, X12.12
PETAL_II_9: RA19.1A, X2.20, X12.13
PETAL_II_10: RA19.2A, X2.21, X12.14
PETAL_II_11: RA20.1B, X2.23, X12.15
PETAL_II_12: RA20.2B, X2.24, X12.16
PETAL_II_13: RA20.3B, X2.25, X12.17
PETAL_II_14: RA20.4B, X2.26, X12.18
PETAL_II_15: RA21.1B, X2.27, X12.19
PETAL_II_16: RA21.2B, X2.28, X12.20
PETAL_II_17: RA21.3B, X2.30, X12.21
PETAL_II_18: RA21.4B, X2.31, X12.22
PETAL_II_19: RA22.1A, X2.32, X12.23
PETAL_II_20: RA22.2A, X2.33, X12.24
PETAL_II_21: RA22.3A, X2.35, X12.25
PETAL_II_22: RA22.4A, X2.36, X12.26
PETAL_II_23: RA23.1A, X2.37, X12.27
PETAL_II_24: RA23.2A, X2.38, X12.28
PETAL_II_25: RA23.3A, X2.39, X12.29
PETAL_II_26: RA23.4A, X2.40, X12.30
PETAL_I_1: RA10.1A, X1.11, X11.5
PETAL_I_2: RA10.2A, X1.12, X11.6
PETAL_I_3: RA10.3A, X1.13, X11.7
PETAL_I_4: RA10.4A, X1.14, X11.8
PETAL_I_5: RA11.1A, X1.15, X11.9
PETAL_I_6: RA11.2A, X1.16, X11.10
PETAL_I_7: RA11.3A, X1.18, X11.11
PETAL_I_8: RA11.4A, X1.19, X11.12
PETAL_I_9: RA12.1A, X1.20, X11.13
PETAL_I_10: RA12.2A, X1.21, X11.14
PETAL_I_11: RA13.1A, X1.23, X11.15
PETAL_I_12: RA13.2A, X1.24, X11.16
PETAL_I_13: RA13.3A, X1.25, X11.17
PETAL_I_14: RA13.4A, X1.26, X11.18
PETAL_I_15: RA14.1A, X1.27, X11.19
PETAL_I_16: RA14.2A, X1.28, X11.20
PETAL_I_17: RA14.3A, X1.30, X11.21
PETAL_I_18: RA14.4A, X1.31, X11.22
PETAL_I_19: RA15.1A, X1.32, X11.23
PETAL_I_20: RA15.2A, X1.33, X11.24
PETAL_I_21: RA15.3A, X1.35, X11.25
PETAL_I_22: RA15.4A, X1.36, X11.26
PETAL_I_23: RA16.1A, X1.37, X11.27
PETAL_I_24: RA16.2A, X1.38, X11.28
PETAL_I_25: RA16.3A, X1.39, X11.29
PETAL_I_26: RA16.4A, X1.40, X11.30
VEXT_A: X1.45, X1.46, X1.47, X2.45, X2.46, X2.47, X11.32, X12.32; also elsewhere on the board
VEXT_B: X1.48, X1.49, X1.50, X2.48, X2.49, X2.50, X11.34, X12.34; also elsewhere on the board
X3V3: X1.4, X1.5, X1.6, X2.4, X2.5, X2.6, X11.4, X12.4; also elsewhere on the board

Notes on the sheet:
Petal Slot I
Petal Slot II
