CynaraKrewe/Cynara/Hardware/Cynara Viride.brd

## EAGLE design Hardware/Cynara Viride.brd (continued)

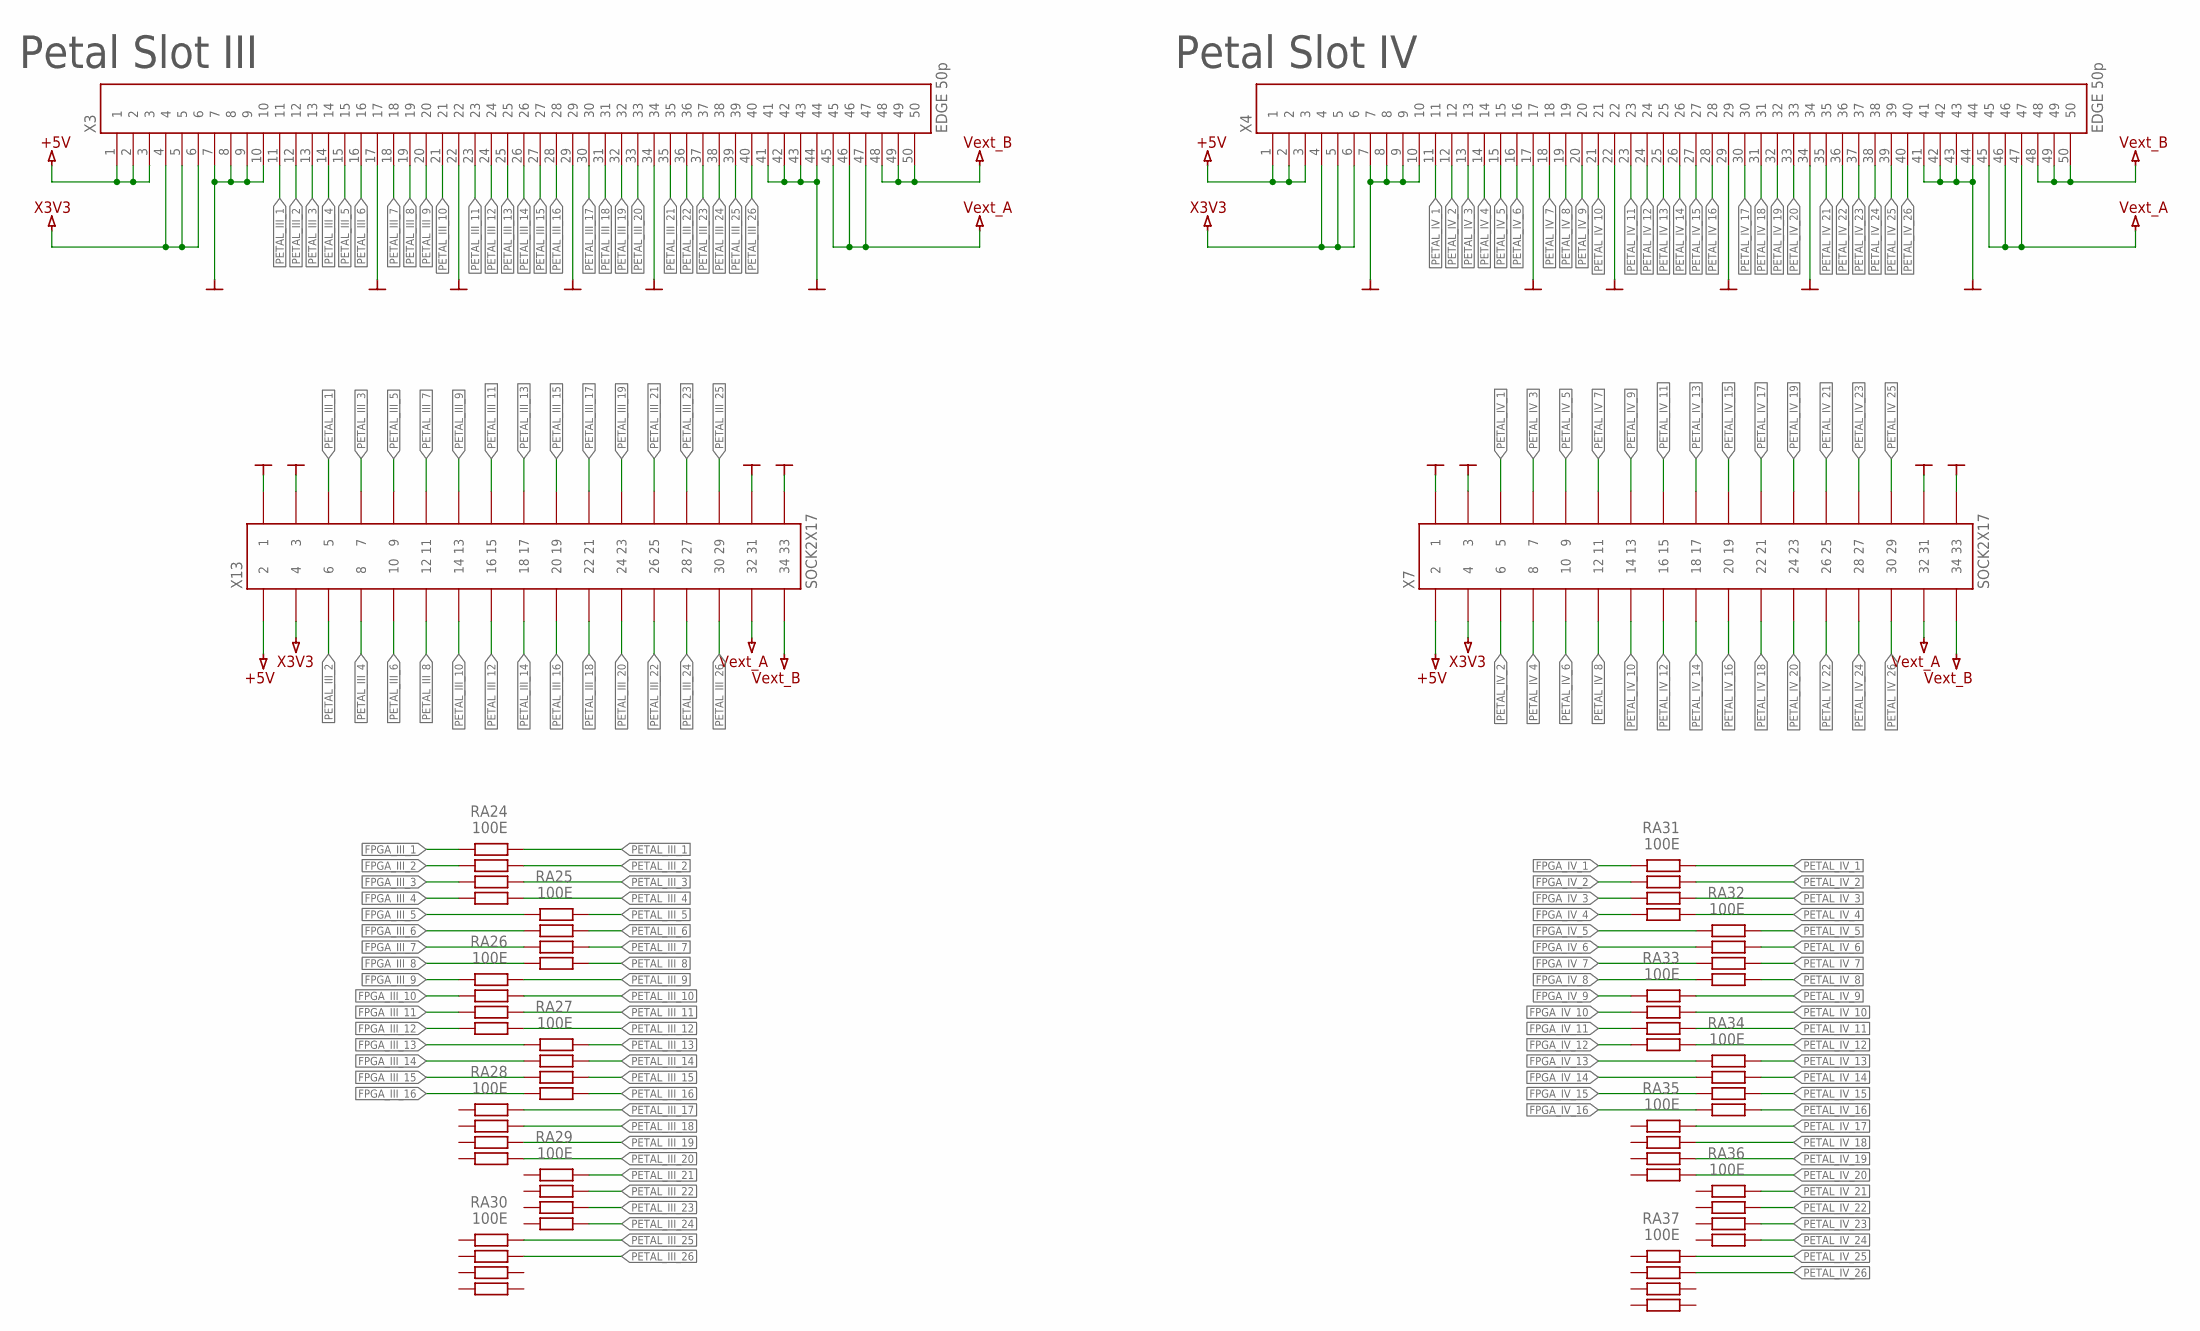
[picture p7: schematic Cynara Viride.sch, sheet 7, Petal III IV]

Parts:
RA24, RA25, RA26, RA27, RA28, RA29, RA30, RA31, RA32, RA33, RA34, RA35, RA36, RA37: 100E; CRA06S
X3, X4: EDGE 50p; MB1-150-01-XX-S-XX-SL
X7, X13: SOCK2X17; 2X17P-FEMALE

Connections:
+5V: X3.1, X3.2, X3.3, X4.1, X4.2, X4.3, X7.2, X13.2; also elsewhere on the board
FPGA_III_1: RA24.1B; also elsewhere on the board
FPGA_III_2: RA24.2B; also elsewhere on the board
FPGA_III_3: RA24.3B; also elsewhere on the board
FPGA_III_4: RA24.4B; also elsewhere on the board
FPGA_III_5: RA25.1B; also elsewhere on the board
FPGA_III_6: RA25.2B; also elsewhere on the board
FPGA_III_7: RA25.3B; also elsewhere on the board
FPGA_III_8: RA25.4B; also elsewhere on the board
FPGA_III_9: RA26.1B; also elsewhere on the board
FPGA_III_10: RA26.2B; also elsewhere on the board
FPGA_III_11: RA26.3B; also elsewhere on the board
FPGA_III_12: RA26.4B; also elsewhere on the board
FPGA_III_13: RA27.1B; also elsewhere on the board
FPGA_III_14: RA27.2B; also elsewhere on the board
FPGA_III_15: RA27.3B; also elsewhere on the board
FPGA_III_16: RA27.4B; also elsewhere on the board
FPGA_IV_1: RA31.1B; also elsewhere on the board
FPGA_IV_2: RA31.2B; also elsewhere on the board
FPGA_IV_3: RA31.3B; also elsewhere on the board
FPGA_IV_4: RA31.4B; also elsewhere on the board
FPGA_IV_5: RA32.1B; also elsewhere on the board
FPGA_IV_6: RA32.2B; also elsewhere on the board
FPGA_IV_7: RA32.3B; also elsewhere on the board
FPGA_IV_8: RA32.4B; also elsewhere on the board
FPGA_IV_9: RA33.1B; also elsewhere on the board
FPGA_IV_10: RA33.2B; also elsewhere on the board
FPGA_IV_11: RA33.3B; also elsewhere on the board
FPGA_IV_12: RA33.4B; also elsewhere on the board
FPGA_IV_13: RA34.1B; also elsewhere on the board
FPGA_IV_14: RA34.2B; also elsewhere on the board
FPGA_IV_15: RA34.3B; also elsewhere on the board
FPGA_IV_16: RA34.4B; also elsewhere on the board
GND: X3.7, X3.8, X3.9, X3.10, X3.17, X3.22, X3.29, X3.34, X3.41, X3.42, X3.43, X3.44, X4.7, X4.8, X4.9, X4.10, X4.17, X4.22, X4.29, X4.34, X4.41, X4.42, X4.43, X4.44, X7.1, X7.3, X7.31, X7.33, X13.1, X13.3, X13.31, X13.33; also elsewhere on the board
PETAL_III_1: RA24.1A, X3.11, X13.5
PETAL_III_2: RA24.2A, X3.12, X13.6
PETAL_III_3: RA24.3A, X3.13, X13.7
PETAL_III_4: RA24.4A, X3.14, X13.8
PETAL_III_5: RA25.1A, X3.15, X13.9
PETAL_III_6: RA25.2A, X3.16, X13.10
PETAL_III_7: RA25.3A, X3.18, X13.11
PETAL_III_8: RA25.4A, X3.19, X13.12
PETAL_III_9: RA26.1A, X3.20, X13.13
PETAL_III_10: RA26.2A, X3.21, X13.14
PETAL_III_11: RA26.3A, X3.23, X13.15
PETAL_III_12: RA26.4A, X3.24, X13.16
PETAL_III_13: RA27.1A, X3.25, X13.17
PETAL_III_14: RA27.2A, X3.26, X13.18
PETAL_III_15: RA27.3A, X3.27, X13.19
PETAL_III_16: RA27.4A, X3.28, X13.20
PETAL_III_17: RA28.1A, X3.30, X13.21
PETAL_III_18: RA28.2A, X3.31, X13.22
PETAL_III_19: RA28.3A, X3.32, X13.23
PETAL_III_20: RA28.4A, X3.33, X13.24
PETAL_III_21: RA29.1A, X3.35, X13.25
PETAL_III_22: RA29.2A, X3.36, X13.26
PETAL_III_23: RA29.3A, X3.37, X13.27
PETAL_III_24: RA29.4A, X3.38, X13.28
PETAL_III_25: RA30.1A, X3.39, X13.29
PETAL_III_26: RA30.2A, X3.40, X13.30
PETAL_IV_1: RA31.1A, X4.11, X7.5
PETAL_IV_2: RA31.2A, X4.12, X7.6
PETAL_IV_3: RA31.3A, X4.13, X7.7
PETAL_IV_4: RA31.4A, X4.14, X7.8
PETAL_IV_5: RA32.1A, X4.15, X7.9
PETAL_IV_6: RA32.2A, X4.16, X7.10
PETAL_IV_7: RA32.3A, X4.18, X7.11
PETAL_IV_8: RA32.4A, X4.19, X7.12
PETAL_IV_9: RA33.1A, X4.20, X7.13
PETAL_IV_10: RA33.2A, X4.21, X7.14
PETAL_IV_11: RA33.3A, X4.23, X7.15
PETAL_IV_12: RA33.4A, X4.24, X7.16
PETAL_IV_13: RA34.1A, X4.25, X7.17
PETAL_IV_14: RA34.2A, X4.26, X7.18
PETAL_IV_15: RA34.3A, X4.27, X7.19
PETAL_IV_16: RA34.4A, X4.28, X7.20
PETAL_IV_17: RA35.1A, X4.30, X7.21
PETAL_IV_18: RA35.2A, X4.31, X7.22
PETAL_IV_19: RA35.3A, X4.32, X7.23
PETAL_IV_20: RA35.4A, X4.33, X7.24
PETAL_IV_21: RA36.1A, X4.35, X7.25
PETAL_IV_22: RA36.2A, X4.36, X7.26
PETAL_IV_23: RA36.3A, X4.37, X7.27
PETAL_IV_24: RA36.4A, X4.38, X7.28
PETAL_IV_25: RA37.1A, X4.39, X7.29
PETAL_IV_26: RA37.2A, X4.40, X7.30
VEXT_A: X3.45, X3.46, X3.47, X4.45, X4.46, X4.47, X7.32, X13.32; also elsewhere on the board
VEXT_B: X3.48, X3.49, X3.50, X4.48, X4.49, X4.50, X7.34, X13.34; also elsewhere on the board
X3V3: X3.4, X3.5, X3.6, X4.4, X4.5, X4.6, X7.4, X13.4; also elsewhere on the board

Notes on the sheet:
Petal Slot IV
Petal Slot III

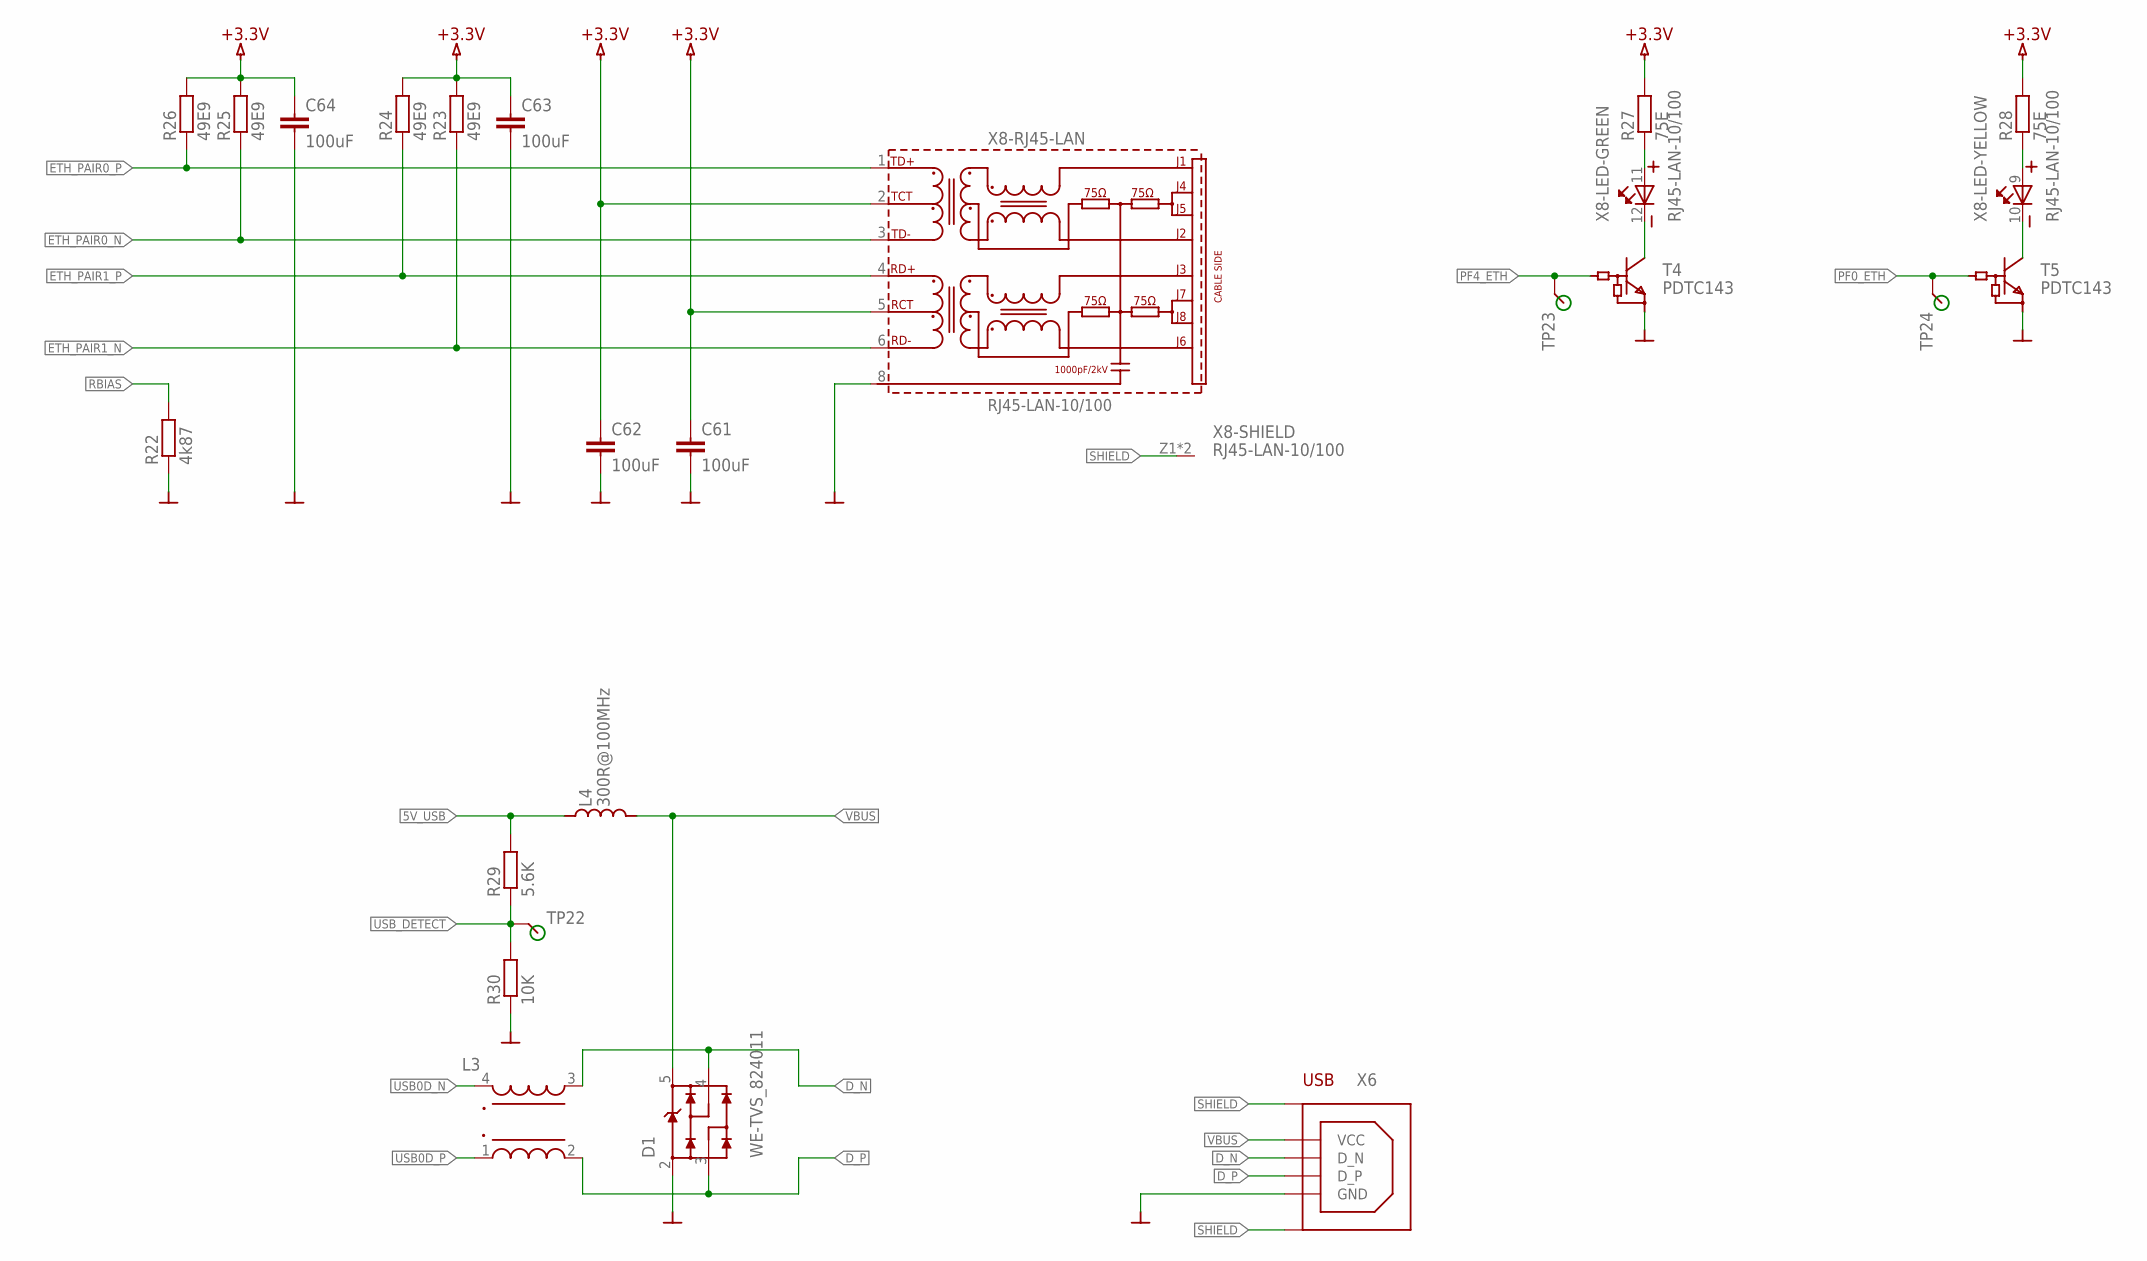
[picture p8: schematic Cynara Viride.sch, sheet 8, Communications]

Parts:
C61, C62, C63, C64: 100uF; C0603
D1: WE-TVS_824011; WE-TVS_SOT23-5L
L3: WE-CNSW_1206
L4: 300R@100MHz; L1608
R22: 4k87; R0603
R23, R24, R25, R26: 49E9; R0603
R27, R28: 75E; R0603
R29: 5.6K; R0603
R30: 10K; R0603
T4, T5: PDTC143; SOT23-3
TP22, TP23, TP24: TP-SMD
X6: 61400416121
X8: RJ45-LAN-10/100; 74990-WITH-LED-TYPE1

Connections:
5V_USB: L4.1 (E), R29.2; also elsewhere on the board
+3.3V: C61.1, C62.1, C63.1, C64.1, R23.2, R24.2, R25.2, R26.2, R27.2, R28.2, X8.2 (TCT), X8.5 (RCT); also elsewhere on the board
D_N: D1.4 (2), L3.3 (2), X6.2 (D_N)
D_P: D1.3 (1), L3.2 (3), X6.3 (D_P)
ETH_PAIR0_N: R25.1, X8.3 (TD-); also elsewhere on the board
ETH_PAIR0_P: R26.1, X8.1 (TD+); also elsewhere on the board
ETH_PAIR1_N: R23.1, X8.6 (RD-); also elsewhere on the board
ETH_PAIR1_P: R24.1, X8.4 (RD+); also elsewhere on the board
GND: C61.2, C62.2, C63.2, C64.2, D1.2 (GND), R22.1, R30.1, T4.2 (E), T5.2 (E), X6.4 (GND), X8.8 (SH); also elsewhere on the board
unnamed: R27.1, X8.11 (A)
unnamed: T4.3 (C), X8.12 (K)
unnamed: R28.1, X8.9 (A)
unnamed: T5.3 (C), X8.10 (K)
PF0_ETH: T5.1 (B), TP24.1; also elsewhere on the board
PF4_ETH: T4.1 (B), TP23.1; also elsewhere on the board
RBIAS: R22.2; also elsewhere on the board
SHIELD: X6.Z1 (GND), X6.Z2 (GND), X8.Z1, X8.Z2; also elsewhere on the board
USB0D_N: L3.4 (1); also elsewhere on the board
USB0D_P: L3.1 (4); also elsewhere on the board
USB_DETECT: R29.1, R30.2, TP22.1; also elsewhere on the board
VBUS: D1.5 (VDD), L4.2 (F), X6.1 (VCC)

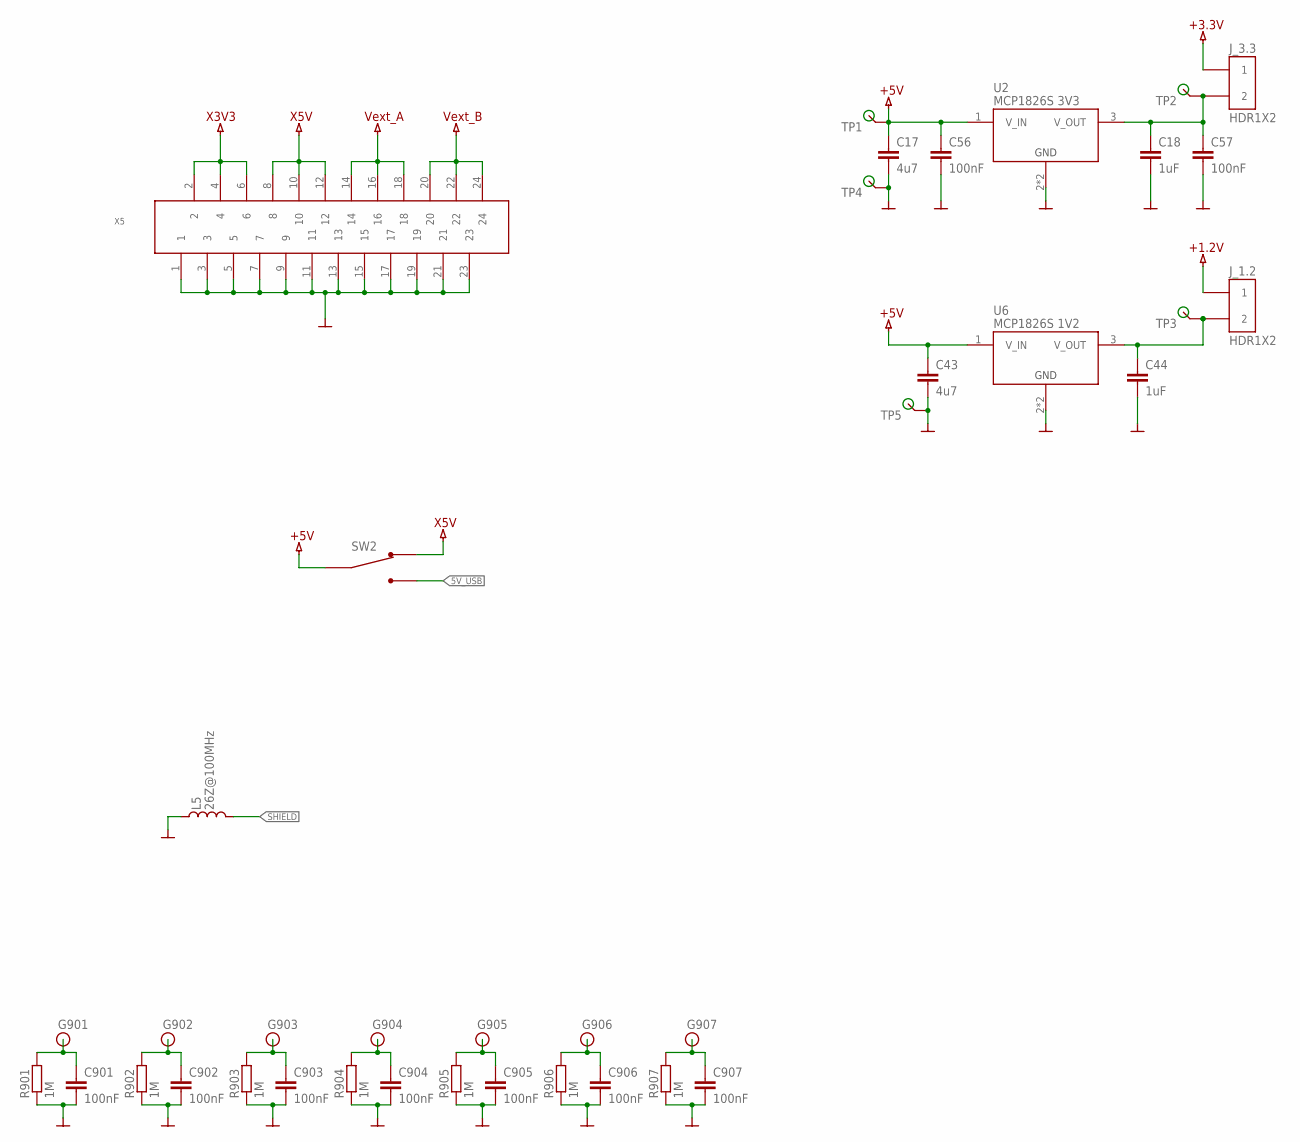
[picture p9: schematic Cynara Viride.sch, sheet 9, Power]

Parts:
C17, C43: 4u7; C0603
C18, C44: 1uF; C0603
C56, C57, C901, C902, C903, C904, C905, C906, C907: 100nF; C0603
G901, G902, G903, G904, G905, G906, G907: HOLE-3,5/6,6
J_1.2, J_3.3: HDR1X2; 1X2
L5: 26Z@100MHz; L1608
R901, R902, R903, R904, R905, R906, R907: 1M; R0603
SW2: 1XXX-MX-XX-C
TP1, TP2, TP3, TP4, TP5: TP-SMD
U2: MCP1826S 3V3; SOT-223
U6: MCP1826S 1V2; SOT-223
X5: MicroMatch 24; MICROMATCH-24-MALE

Connections:
5V_USB: SW2.1; also elsewhere on the board
+1.2V: J_1.2.1; also elsewhere on the board
+3.3V: J_3.3.1; also elsewhere on the board
+5V: C17.1, C43.1, C56.1, SW2.2, TP1.1, U2.1 (V_IN), U6.1 (V_IN); also elsewhere on the board
G901: C901.1, G901.1, R901.2
G902: C902.1, G902.1, R902.2
G903: C903.1, G903.1, R903.2
G904: C904.1, G904.1, R904.2
G905: C905.1, G905.1, R905.2
G906: C906.1, G906.1, R906.2
G907: C907.1, G907.1, R907.2
GND: C17.2, C18.2, C43.2, C44.2, C56.2, C57.2, C901.2, C902.2, C903.2, C904.2, C905.2, C906.2, C907.2, L5.1 (E), R901.1, R902.1, R903.1, R904.1, R905.1, R906.1, R907.1, TP4.1, TP5.1, U2.2 (GND), U2.4 (GND), U6.2 (GND), U6.4 (GND), X5.1, X5.3, X5.5, X5.7, X5.9, X5.11, X5.13, X5.15, X5.17, X5.19, X5.21, X5.23; also elsewhere on the board
unnamed: C18.1, C57.1, J_3.3.2, TP2.1, U2.3 (V_OUT)
unnamed: C44.1, J_1.2.2, TP3.1, U6.3 (V_OUT)
SHIELD: L5.2 (F); also elsewhere on the board
VEXT_A: X5.14, X5.16, X5.18; also elsewhere on the board
VEXT_B: X5.20, X5.22, X5.24; also elsewhere on the board
X3V3: X5.2, X5.4, X5.6; also elsewhere on the board
X5V: SW2.3, X5.8, X5.10, X5.12

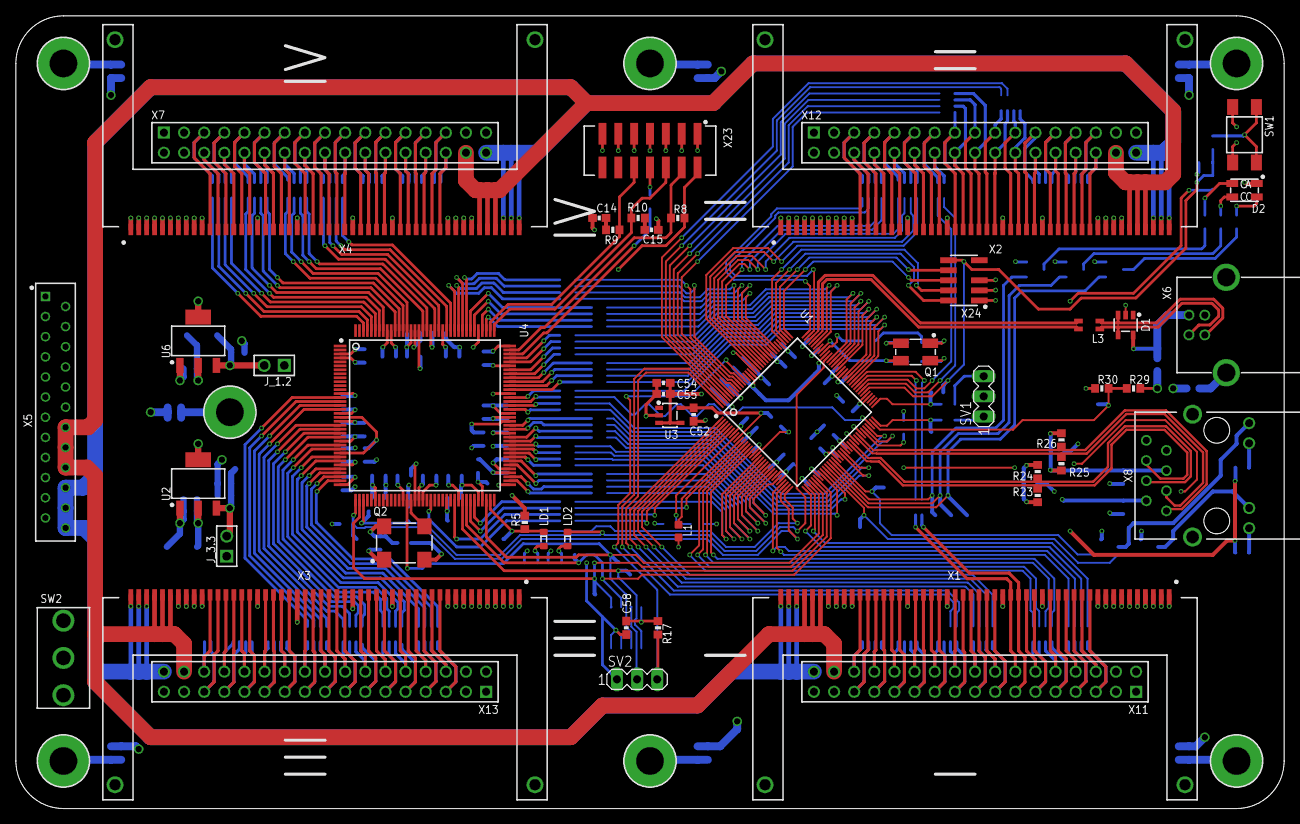
[picture p10: board Cynara Viride.brd from above]

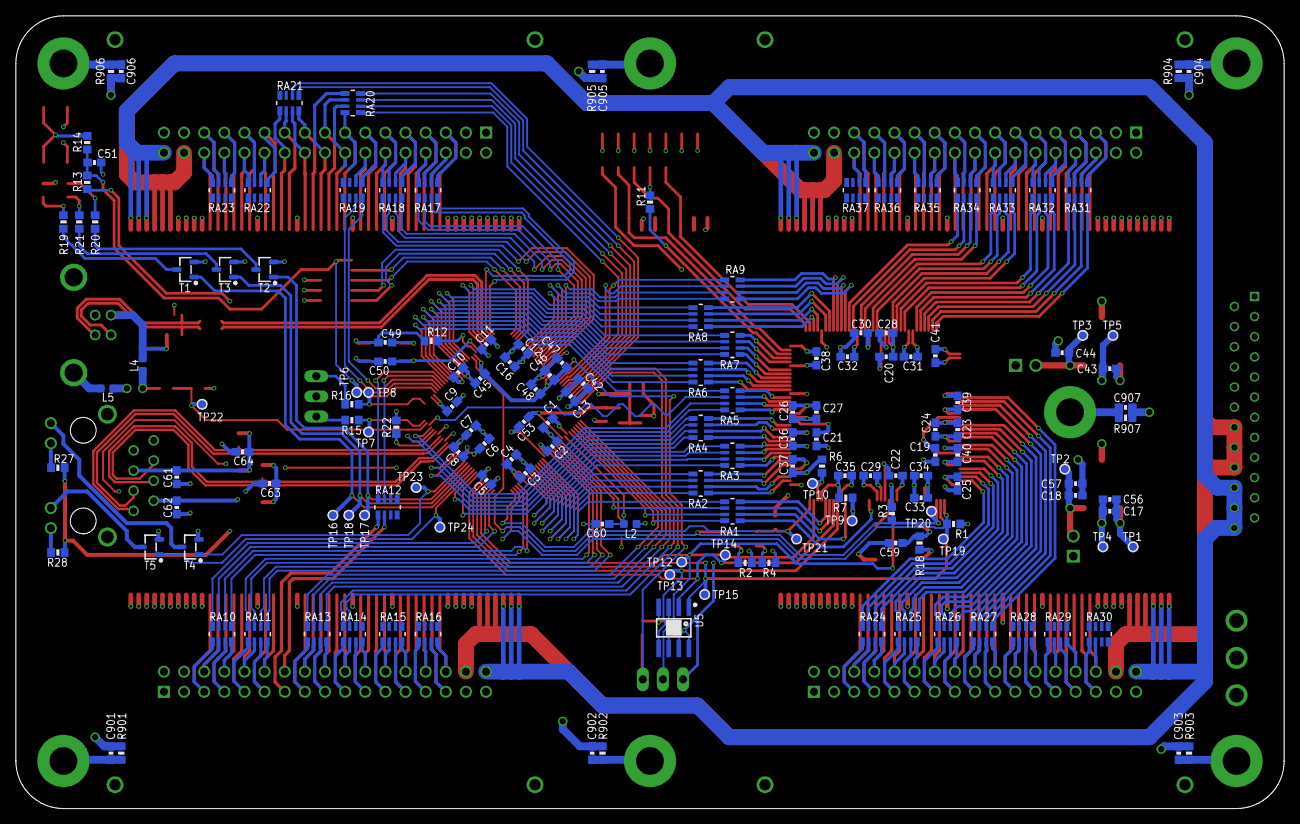
[picture p11: board Cynara Viride.brd from below]

Board: 4 copper layers, 160.0 x 100.0 mm, 217 parts (160 on the bottom side), 324 nets.
