CynaraKrewe/Cynara/Software/tivaware/usblib/host/usbhostenum.c

//*****************************************************************************
//
// usbhostenum.c - Device enumeration code for the USB host library.
//
// Copyright (c) 2008-2015 Texas Instruments Incorporated.  All rights reserved.
// Software License Agreement
// 
// Texas Instruments (TI) is supplying this software for use solely and
// exclusively on TI's microcontroller products. The software is owned by
// TI and/or its suppliers, and is protected under applicable copyright
// laws. You may not combine this software with "viral" open-source
// software in order to form a larger program.
// 
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
// This is part of revision 2.1.2.111 of the Tiva USB Library.
//
//*****************************************************************************

#include <stdbool.h>
#include <stdint.h>
#include "inc/hw_ints.h"
#include "inc/hw_memmap.h"
#include "inc/hw_sysctl.h"
#include "inc/hw_types.h"
#include "driverlib/rom.h"
#include "driverlib/rom_map.h"
#include "driverlib/debug.h"
#include "driverlib/interrupt.h"
#include "driverlib/sysctl.h"
#include "driverlib/usb.h"
#include "driverlib/rtos_bindings.h"
#include "usblib/usblib.h"
#include "usblib/usblibpriv.h"
#include "usblib/usbulpi.h"
#include "usblib/host/usbhost.h"
#include "usblib/host/usbhostpriv.h"
#include "usblib/host/usbhhub.h"

#ifdef INCLUDE_DEBUG_OUTPUT
#include "utils/uartstdio.h"
#define DEBUG_OUTPUT UARTprintf
#else
#define DEBUG_OUTPUT while(0)((int32_t (*)(char *, ...))0)
#endif

//*****************************************************************************
//
//! \addtogroup usblib_hcd
//! @{
//
//*****************************************************************************

//*****************************************************************************
//
// External prototypes.
//
//*****************************************************************************
extern tUSBMode g_iUSBMode;

extern void OTGDeviceDisconnect(uint32_t ui32Index);

//*****************************************************************************
//
// Internal function prototypes.
//
//*****************************************************************************
static void USBHCDEP0StateTx(void);
static void USBHCDEnumHandler(void);
static void USBHCDClearFeature(uint32_t ui32DevAddress, uint32_t ui32Endpoint,
                               uint32_t ui32Feature);

//*****************************************************************************
//
// Automatic power enable.
//
//*****************************************************************************
#define USB_HOST_PWREN_AUTO     0x00000002

//*****************************************************************************
//
// Flags used to signal between the interrupt handler and USBHCDMain().
//
//*****************************************************************************
#define INT_EVENT_VBUS_ERR      0x01
#define INT_EVENT_CONNECT       0x02
#define INT_EVENT_DISCONNECT    0x04
#define INT_EVENT_POWER_FAULT   0x08
#define INT_EVENT_SOF           0x10
#define INT_EVENT_ENUM          0x20
#define INT_EVENT_LPM_PEND      0x40
#define INT_EVENT_LPM           0x80

//*****************************************************************************
//
// Flags used with the tUSBHostDevice.ui32Flags structure member.
//
//*****************************************************************************
#define USBHDEV_FLAG_NOTIFYINT  0x00000001
#define USBHDEV_FLAG_LPMPEND    0x00000002
#define USBHDEV_FLAG_LPMERROR   0x00000004
#define USBHDEV_FLAG_ALLOCATED  0x80000000

//*****************************************************************************
//
// This holds the current power configuration that is used when USBHCDInit()
// is called.
//
//*****************************************************************************
static uint32_t g_ui32PowerConfig = USBHCD_VBUS_AUTO_HIGH;

//*****************************************************************************
//
// The states for endpoint 0 during enumeration.
//
//*****************************************************************************
typedef enum
{
    //
    // The USB device is waiting on a request from the host controller on
    // endpoint 0.
    //
    eEP0StateIdle,

    //
    // Setup packet is expecting data IN.
    //
    eEP0StateSetupIN,

    //
    // Setup packet is sending data OUT.
    //
    eEP0StateSetupOUT,

    //
    // The USB device is receiving data from the device due to an SETUP IN
    // request.
    //
    eEP0StateRx,

    //
    // The USB device has completed the IN or OUT request and is now waiting
    // for the host to acknowledge the end of the IN/OUT transaction.  This
    // is the status phase for a USB control transaction.
    //
    eEP0StateStatus,

    //
    // This state is for when a response only has a status phase and no
    // data phase.
    //
    eEP0StateStatusIN,

    //
    // This endpoint has signaled a stall condition and is waiting for the
    // stall to be acknowledged by the host controller.
    //
    eEP0StateStall,

    //
    // An error has occurred on endpoint 0.
    //
    eEP0StateError
}
tEP0State;

//*****************************************************************************
//
// This structure holds the full state for the device enumeration.
//
//*****************************************************************************
typedef struct
{
    //
    // This is the pointer to the current data being sent out or received
    // on endpoint 0.
    //
    uint8_t *pui8Data;

    //
    // This is the number of bytes that remain to be sent from or received
    // into the g_DeviceState.pEP0Data data buffer.
    //
    volatile uint32_t ui32BytesRemaining;

    //
    // The amount of data being sent/received due to a request.
    //
    uint32_t ui32DataSize;

    //
    // This is the current device address in use by endpoint 0.
    //
    uint32_t ui32DevAddress;

    //
    // The maximum packet size for the device responding to the setup packet.
    //
    uint32_t ui32MaxPacketSize;

    //
    // The host controller's state.
    //
    tEP0State iState;
}
tHostState;

//*****************************************************************************
//
// This variable holds the current state of endpoint 0.
//
//*****************************************************************************
static volatile tHostState g_sUSBHEP0State =
{
    0,                          // pui8Data
    0,                          // ui32BytesRemaining
    0,                          // ui32DataSize
    0,                          // ui32DevAddress
    0,                          // ui32MaxPacketSize
    eEP0StateIdle               // iState
};

//*****************************************************************************
//
// The global delay time for use by SysCtlDelay() function.  This is
// initialized to an appropriate value for a 50MHz clock.  The correct value
// will be set in USBHCDInit().
//
//*****************************************************************************
static uint32_t g_ui32Tickms = 0;
static volatile uint32_t g_ui32CurrentTick = 0;

//*****************************************************************************
//
// This is 480000000/60000000 or a PLL Divide of 8.
//
//*****************************************************************************
static uint32_t g_ui32PLLDiv = 8;

//*****************************************************************************
//
// Holds the ULPI configuration.
//
//*****************************************************************************
static uint32_t g_ui32ULPISupport;

//*****************************************************************************
//
// The current active drivers.
//
//*****************************************************************************
static int32_t g_pi32USBHActiveDriver[MAX_USB_DEVICES + 1];
static void *g_ppvDriverInstance[MAX_USB_DEVICES + 1];

//*****************************************************************************
//
// This is the structure used to hold the information for a given USB pipe
// that is attached to a device.
//
//*****************************************************************************
typedef struct
{
    //
    // The current address for this pipe.
    //
    tUSBHostDevice *psDevice;

    //
    // The current address for this pipe.
    //
    uint8_t ui8EPNumber;

    //
    // The DMA channel assigned to this endpoint.
    //
    uint8_t ui8DMAChannel;

    //
    // The current type for this pipe.
    //
    uint32_t ui32Type;

    //
    // The millisecond interval for this pipe.
    //
    uint32_t ui32Interval;

    //
    // The next tick value to trigger and event on this pipe.
    //
    uint32_t ui32NextEventTick;

    //
    // The current call back for this pipe.
    //
    tHCDPipeCallback pfnCallback;

    //
    // The pointer to which IN data must be copied.
    //
    uint8_t *pui8ReadPtr;

    //
    // The size of the buffer pointed to by pui8ReadPtr.
    //
    uint32_t ui32ReadSize;

    //
    // The number of bytes read, which can be less than ui32ReadSize.
    //
    uint32_t ui32DataRead;

    //
    // The state of a given USB pipe.
    //
    volatile enum
    {
        ePipeReading,
        ePipeReadDMA,
        ePipeReadDMAWait,
        ePipeReadSingle,
        ePipeDataReady,
        ePipeDataSent,
        ePipeWriting,
        ePipeWriteDMA,
        ePipeWriteDMASend,
        ePipeWriteDMAWait,
        ePipeWriteSingle,
        ePipeStalled,
        ePipeError,
        ePipeIdle,
        ePipeDisabled
    }
    iState;

    //
    // The actual FIFO offset allocated to this endpoint.
    //
    uint16_t ui16FIFOAddr;

    //
    // The size of the FIFO entry based on the size parameter.  These are
    // equivalent to the USB_FIFO_SZ_* values in usb.h.
    //
    uint8_t ui8FIFOSize;

    //
    // The bit offset in the allocation structure.
    //
    uint8_t ui8FIFOBitOffset;
}
tUSBHCDPipe;

//*****************************************************************************
//
// The internal state of the device.
//
//*****************************************************************************
typedef enum
{
    eHCDDevDisconnected,
    eHCDDevConnected,
    eHCDDevConnectedHub,
    eHCDDevRequest,
    eHCDDevReset,
    eHCDDevAddressed,
    eHCDDevConfigured,
    eHCDDevGetStrings,
    eHCDDevError,
    eHCDVBUSError,
    eHCDPowerFault,
    eHCDIdle
}
tUSBHDeviceState;

static void ProcessUSBDeviceStateMachine(tUSBHDeviceState iOldState,
                                         uint32_t ui32DevIndex);

//*****************************************************************************
//
// This is a fixed number as it relates to the maximum number of USB pipes
// available on any USB controller.  The actual number on a given device may
// be less than this number.
//
//*****************************************************************************
#define MAX_NUM_PIPES           15

//*****************************************************************************
//
// This is a fixed number as it relates to the number of USB pipes available
// in the USB controller.
//
//*****************************************************************************
#define MAX_NUM_DMA_CHANNELS    6

//*****************************************************************************
//
// Marker for an unused DMA channel slot.
//
//*****************************************************************************
#define USBHCD_DMA_UNUSED       0xff

//*****************************************************************************
//
// These definitions are used to manipulate the values returned as allocated
// USB pipes.
//
//*****************************************************************************
#define EP_PIPE_TYPE_LOW_SPEED  0x02000000
#define EP_PIPE_USE_UDMA        0x01000000
#define EP_PIPE_TYPE_ISOC       0x00800000
#define EP_PIPE_TYPE_INTR       0x00400000
#define EP_PIPE_TYPE_BULK       0x00200000
#define EP_PIPE_TYPE_CONTROL    0x00100000
#define EP_PIPE_TYPE_IN         0x00020000
#define EP_PIPE_TYPE_OUT        0x00010000
#define EP_PIPE_IDX_M           0x0000ffff

//*****************************************************************************
//
// This creates a USB pipe handle from an index.
//
//*****************************************************************************
#define OUT_PIPE_HANDLE(ui32Idx)                                              \
                                (g_sUSBHCD.psUSBOUTPipes[ui32Idx].ui32Type |  \
                                 ui32Idx)
#define IN_PIPE_HANDLE(ui32Idx) (g_sUSBHCD.psUSBINPipes[ui32Idx].ui32Type |   \
                                 ui32Idx)

//*****************************************************************************
//
// Converts from an endpoint specifier to the offset of the endpoint's
// control/status registers.
//
//*****************************************************************************
#define EP_OFFSET(Endpoint)     (Endpoint - 0x10)

//*****************************************************************************
//
// This structure holds the state information for a given host controller.
//
//*****************************************************************************
typedef struct
{
    uint32_t ui32USBBase;

    tUSBHCDPipe sUSBControlPipe;
    tUSBHCDPipe psUSBOUTPipes[MAX_NUM_PIPES];
    tUSBHCDPipe psUSBINPipes[MAX_NUM_PIPES];

    //
    // Each devices state.  We support a total of (MAX_USB_DEVICES + 1) devices
    // to allow for the use if MAX_USB_DEVICES through a single hub (which is
    // itself a device).
    //
    tUSBHostDevice psUSBDevice[MAX_USB_DEVICES + 1];

    //
    // Holds the current state of the device.
    //
    volatile tUSBHDeviceState piDeviceState[MAX_USB_DEVICES + 1];

    //
    // Pointer to the memory pool for this controller.
    //
    void *pvPool;

    //
    // The pool size for this controller.
    //
    uint32_t ui32PoolSize;

    //
    // The number of endpoint pairs supported by the controller.
    //
    uint32_t ui32NumEndpoints;

    //
    // The class drivers for this controller.
    //
    const tUSBHostClassDriver * const *ppsClassDrivers;

    //
    // The number of class drivers.
    //
    uint32_t ui32NumClassDrivers;

    //
    // This is the index in the driver list of the event driver.
    //
    int32_t i32EventDriver;

    //
    // These are the generic event information used by the event driver.
    //
    uint32_t ui32EventEnables;

    uint32_t ui32Class;

    //
    // The DMA instance information for this class.
    //
    tUSBDMAInstance *psDMAInstance;

    //
    // The interrupt number for this instance.
    //
    uint32_t ui32IntNum;

    //
    // The pending interrupt events that are processed in USBHCDMain().
    //
    uint32_t ui32IntEvents;

    //
    // Features.
    //
    uint32_t ui32Features;

    //
    // The host initiated resume duration in us.
    //
    uint32_t ui32LPMHIRD;
}
tUSBHCD;

//*****************************************************************************
//
// The global to hold all of the state information for a given host controller.
//
//*****************************************************************************
static tUSBHCD g_sUSBHCD;

//*****************************************************************************
//
// Allocates the memory needed to support configuration descriptors for
// devices.
//
//*****************************************************************************
uint32_t
ConfigDescAlloc(tUSBHostDevice *psDevice, uint32_t ui32Size)
{
    uint32_t ui32Idx, ui32BlockSize, ui32PoolSize;
    uint8_t *pui8Pool;

    if(g_sUSBHCD.psUSBDevice[0].psConfigDescriptor == 0)
    {
        //
        // 32 bit align the allocation.
        //
        ui32Size = (ui32Size + 3) & ~3;

        if(g_sUSBHCD.ui32PoolSize < ui32Size)
        {
            return(0);
        }

        //
        // Allocate the root connection to the device.
        //
        g_sUSBHCD.psUSBDevice[0].psConfigDescriptor = g_sUSBHCD.pvPool;
        g_sUSBHCD.psUSBDevice[0].ui32ConfigDescriptorSize = ui32Size;

        //
        // Allocate the hub memory pools (these can end up null).
        //
        pui8Pool = (uint8_t *)g_sUSBHCD.pvPool + ui32Size;
        ui32PoolSize = g_sUSBHCD.ui32PoolSize - ui32Size;

        //
        // Divide the pool up into blocks, one for each supported port.  We make
        // sure that each block is a multiple of 4 bytes.
        //
        ui32BlockSize = (ui32PoolSize / MAX_USB_DEVICES) & ~3;
        for(ui32Idx = 1; ui32Idx < MAX_USB_DEVICES; ui32Idx++)
        {
            g_sUSBHCD.psUSBDevice[ui32Idx].psConfigDescriptor =
                        (tConfigDescriptor *)(pui8Pool +
                                              (ui32Idx * ui32BlockSize));
            g_sUSBHCD.psUSBDevice[ui32Idx].ui32ConfigDescriptorSize =
                            ui32BlockSize;
        }
    }
    return(ui32Size);
}

//*****************************************************************************
//
// Frees the memory needed to support configuration descriptors for
// devices.
//
//*****************************************************************************
void
ConfigDescFree(tUSBHostDevice *psDevice)
{
    uint32_t ui32Idx;

    //
    // If this is the root device then deallocate.
    //
    if(&g_sUSBHCD.psUSBDevice[0] == psDevice)
    {
        for(ui32Idx = 0; ui32Idx < MAX_USB_DEVICES; ui32Idx++)
        {
            g_sUSBHCD.psUSBDevice[ui32Idx].ui32Flags &=
                                                    ~USBHDEV_FLAG_ALLOCATED;
            g_sUSBHCD.psUSBDevice[ui32Idx].psConfigDescriptor = 0;
            g_sUSBHCD.psUSBDevice[ui32Idx].ui32ConfigDescriptorSize = 0;
        }
    }
}

//*****************************************************************************
//
// Return the device index from a ui32Instance value passed from an external
// source.
//
//*****************************************************************************
static uint8_t
HCDInstanceToDevIndex(uint32_t ui32Instance)
{
    uint32_t ui32DevIndex;

    //
    // Get the device instance from the instance value.
    //
    ui32DevIndex = (ui32Instance & 0xff);

    //
    // If the above math went negative or is too large just return 0xff.
    //
    if(ui32DevIndex > MAX_USB_DEVICES)
    {
        ui32DevIndex = 0xff;
    }

    return(ui32DevIndex);
}

//=============================================================================
//
// This is the internal function that will map an event to a valid event flag.
//
// \param ui32Event specifies which event flag to retrieve.
//
// \return The event flag or 0 if there is no support event flag for the
// event specified by the \e ui32Event parameter.
//
//=============================================================================
static uint32_t
GetEventFlag(uint32_t ui32Event)
{
    uint32_t ui32EventFlag;

    ui32EventFlag = 0;

    //
    // Search for a valid event flag for the requested event.
    //
    switch(ui32Event)
    {
        case USB_EVENT_SOF:
        {
            ui32EventFlag |= USBHCD_EVFLAG_SOF;
            break;
        }
        case USB_EVENT_CONNECTED:
        {
            ui32EventFlag |= USBHCD_EVFLAG_CONNECT;
            break;
        }
        case USB_EVENT_DISCONNECTED:
        {
            ui32EventFlag |= USBHCD_EVFLAG_DISCNCT;
            break;
        }
        case USB_EVENT_UNKNOWN_CONNECTED:
        {
            ui32EventFlag |= USBHCD_EVFLAG_UNKCNCT;
            break;
        }
        case USB_EVENT_POWER_FAULT:
        {
            ui32EventFlag |= USBHCD_EVFLAG_PWRFAULT;
            break;
        }
        case USB_EVENT_POWER_DISABLE:
        {
            ui32EventFlag |= USBHCD_EVFLAG_PWRDIS;
            break;
        }
        case USB_EVENT_POWER_ENABLE:
        {
            ui32EventFlag |= USBHCD_EVFLAG_PWREN;
            break;
        }
        default:
        {
            break;
        }
    }
    return(ui32EventFlag);
}

//=============================================================================
//
//! This function is called to enable a specific USB HCD event notification.
//!
//! \param ui32Index specifies which USB controller to use.
//! \param pvEventDriver is the event driver structure that was passed into
//! the USBHCDRegisterDrivers() function as part of the array of
//! tUSBHostClassDriver structures.
//! \param ui32Event is the event to enable.
//!
//! This function is called to enable event callbacks for a specific USB HCD
//! event.  The requested event is passed in the \e ui32Event parameter.  Not
//! all events can be enables so the function will return zero if the event
//! provided cannot be enabled.  The \e pvEventDriver is a pointer to the
//! event driver structure that the caller passed into the
//! USBHCDRegisterDrivers() function.  This structure is typically declared
//! with the DECLARE_EVENT_DRIVER() macro and included as part of the array
//! of pointers to tUSBHostClassDriver structures that is passed to the
//! USBHCDRegisterDrivers() function.
//!
//! \return This function returns a non-zero number if the event was
//! successfully enabled and returns zero if the event cannot be enabled.
//
//=============================================================================
int32_t
USBHCDEventEnable(uint32_t ui32Index, void *pvEventDriver, uint32_t ui32Event)
{
    int32_t i32Ret;
    uint32_t ui32EventFlag;

    ASSERT(ui32Index == 0);

    //
    // Default the return to fail the call unless a valid event is found.
    //
    i32Ret = 0;

    //
    // Get the event flag for this event.
    //
    ui32EventFlag = GetEventFlag(ui32Event);

    //
    // Check if there was an event flag for the corresponding event.
    //
    if(ui32EventFlag)
    {
        //
        // Set the enable for this event.
        //
        g_sUSBHCD.ui32EventEnables |= ui32EventFlag;

        //
        // Indicate that the event was valid and is now enabled.
        //
        i32Ret = 1;
    }

    return(i32Ret);
}

//=============================================================================
//
//! This function is called to disable a specific USB HCD event notification.
//!
//! \param ui32Index specifies which USB controller to use.
//! \param pvEventDriver is the event driver structure that was passed into
//! the USBHCDRegisterDrivers() function as part of the array of
//! tUSBHostClassDriver structures.
//! \param ui32Event is the event to disable.
//!
//! This function is called to disable event callbacks for a specific USB HCD
//! event.  The requested event is passed in the \e ui32Event parameter.  Not
//! all events can be enables so the function will return zero if the event
//! provided cannot be enabled.  The \e pvEventDriver is a pointer to the
//! event driver structure that the caller passed into the
//! USBHCDRegisterDrivers() function.  This structure is typically declared
//! with the DECLARE_EVENT_DRIVER() macro and included as part of the array
//! of pointers to tUSBHostClassDriver structures that is passed to the
//! USBHCDRegisterDrivers() function.
//!
//! \return This function returns a non-zero number if the event was
//! successfully disabled and returns zero if the event cannot be disabled.
//
//=============================================================================
int32_t
USBHCDEventDisable(uint32_t ui32Index, void *pvEventDriver, uint32_t ui32Event)
{
    int32_t i32Ret;
    uint32_t ui32EventFlag;

    ASSERT(ui32Index == 0);

    //
    // Default the return to fail the call unless a valid event is found.
    //
    i32Ret = 0;

    //
    // Get the event flag for this event.
    //
    ui32EventFlag = GetEventFlag(ui32Event);

    //
    // Check if there was an event flag for the corresponding event.
    //
    if(ui32EventFlag)
    {
        //
        // Clear the enable for this event.
        //
        g_sUSBHCD.ui32EventEnables &= ~ui32EventFlag;

        //
        // Indicate that the event was valid and is now disabled.
        //
        i32Ret = 1;
    }

    return(i32Ret);
}

//*****************************************************************************
//
// If there is an event driver this function will send out a generic connection
// event USB_EVENT_UNKNOWN_CONNECTED indicating that an unknown connection
// event has occurred.
//
//*****************************************************************************
static void
SendUnknownConnect(uint32_t ui32Index, uint32_t ui32Class)
{
    tEventInfo sEvent;

    //
    // If there is an event driver registered and it has a event handler and
    // the USBHCD_EVFLAG_UNKCNCT is enabled then call the function.
    //
    sEvent.ui32Event = USB_EVENT_UNKNOWN_CONNECTED;
    sEvent.ui32Instance = ui32Class;
    InternalUSBHCDSendEvent(0, &sEvent, USBHCD_EVFLAG_UNKCNCT);
}

//*****************************************************************************
//
// Internal memory allocation space is two 32-bit values where each
// bit represents a 64 byte block in the FIFO.  This requires 64 bits for
// the 4096 bytes of FIFO available.
//
//*****************************************************************************
static uint32_t g_pui32Alloc[2];

//*****************************************************************************
//
// This function handles freeing FIFO memory that has been allocated using the
// FIFOAlloc() function.
//
//*****************************************************************************
static void
FIFOFree(tUSBHCDPipe *psUSBPipe)
{
    uint32_t ui32Mask;

    //
    // Calculate the mask value to use to clear off the allocated blocks used
    // by the USB pipe specified by psUSBPipe.
    //
    ui32Mask = (1 << (psUSBPipe->ui8FIFOSize - 2)) - 1;
    ui32Mask = ui32Mask << psUSBPipe->ui8FIFOBitOffset;

    //
    // Determine which 32 bit word to access based on the size.
    //
    if(psUSBPipe->ui8FIFOSize > USB_FIFO_SZ_64)
    {
        //
        // If the FIFO size is greater than 64 then use the upper 32 bits.
        //
        g_pui32Alloc[1] &= ~ui32Mask;
    }
    else
    {
        //
        // If the FIFO size is less than or equal to 64 then use the lower
        // 32 bits.
        //
        g_pui32Alloc[0] &= ~ui32Mask;
    }
}

//*****************************************************************************
//
// This function is used to allocate FIFO memory to a given USB pipe.
//
// \param psUSBPipe is the USB pipe that needs FIFO memory allocated.
// \param ui32Size is the minimum size in bytes of the FIFO to allocate.
//
// This function will allocate \e ui32Size bytes to the USB pipe in the
// \e psUSBPipe parameter.  The function will fill the psUSBPipe structure
// members ui8FIFOSize and ui8FIFOAddr with values that can be used with the
// USBFIFOConfigSet() API.  This allocation uses a first fit algorithm.
//
// \return This function returns the size of the block allocated.
//
//*****************************************************************************
static uint32_t
FIFOAlloc(tUSBHCDPipe *psUSBPipe, uint32_t ui32Size)
{
    uint32_t ui32Blocks, ui32Start, ui32BlockSize, ui32Temp, ui32Index;
    uint16_t ui16FIFOAddr;

    //
    // Save which 32 bit value to access, the upper is for blocks greater
    // than 64 and the lower is for block 64 or less.
    //
    if(ui32Size > 64)
    {
        ui32Index = 1;
    }
    else
    {
        ui32Index = 0;
    }

    //
    // Initial FIFO address is 0.
    //
    ui16FIFOAddr = 0;

    //
    // Initialize the bit pattern and bit location.
    //
    ui32Blocks = 1;
    ui32Start = 0;

    //
    // The initial block size is always the minimum size of 64 bytes.
    //
    ui32BlockSize = 64;

    //
    // The initial size and offset are 64 and 0.
    //
    psUSBPipe->ui8FIFOBitOffset = 0;
    psUSBPipe->ui8FIFOSize = 3;

    //
    // Scan through 32 bits looking for a memory block large enough to fill
    // the request.
    //
    while(ui16FIFOAddr <= 32)
    {
        //
        // If the pattern is zero then it is a possible match.
        //
        if((g_pui32Alloc[ui32Index] & ui32Blocks) == 0)
        {
            //
            // If the size is large enough then save it and break out of the
            // loop.
            //
            if(ui32BlockSize >= ui32Size)
            {
                //
                // Mark the memory as allocated.
                //
                g_pui32Alloc[ui32Index] |= ui32Blocks;

                break;
            }

            //
            // Increment the size of the FIFO block.
            //
            psUSBPipe->ui8FIFOSize++;

            //
            // Add in a new bit to the size of the allocation.
            //
            ui32Blocks = ui32Blocks | (ui32Blocks << 1) ;

            //
            // Double the current size.
            //
            ui32BlockSize <<= 1;

        }
        else
        {
            //
            // Need to start over looking because the last allocation match
            // failed, so reset the bit offset to the current location and the
            // size to 64 bytes.
            //
            psUSBPipe->ui8FIFOBitOffset = ui16FIFOAddr;
            psUSBPipe->ui8FIFOSize = 3;

            //
            // Reset the block size to the minimum (64 bytes).
            //
            ui32BlockSize = 64;

            //
            // Store the current starting bit location and set the block mask
            // to this value.
            //
            ui32Start = 1 << ui16FIFOAddr;
            ui32Blocks = ui32Start;
        }

        //
        // Increase the address of the FIFO offset.
        //
        ui16FIFOAddr++;
    }

    //
    // If there was no block large enough then fail this call.
    //
    if(ui16FIFOAddr > 32)
    {
        ui32BlockSize = 0;
        psUSBPipe->ui16FIFOAddr = 0;
        psUSBPipe->ui8FIFOBitOffset = 0;
        psUSBPipe->ui8FIFOSize = 0;
    }
    else
    {
        //
        // Calculate the offset in the FIFO.
        //
        ui32Temp = psUSBPipe->ui8FIFOBitOffset * 64;

        //
        // Sizes greater than 64 are allocated in the second half of the FIFO
        // memory space.
        //
        if(ui32Size > 64)
        {
            ui32Temp += 2048;
        }

        //
        // Convert this to the value that can be set in the USB controller.
        //
        psUSBPipe->ui16FIFOAddr = (uint16_t)ui32Temp;
    }
    return(ui32BlockSize);
}

//*****************************************************************************
//
//! This function returns the current byte count of a USB HCD pipe.
//!
//! \param ui32Pipe is the allocated endpoint to modify.
//!
//! This call returns the current or last byte count for a transfer using the
//! pipe specified by the \e ui32Pipe parameter.  This is typically used to
//! determine the actual byte count received when a \b USB_EVENT_RX_AVAILABLE
//! occurs.
//!
//! \return If the call was successful, this function returns the number of
//! bytes transfered by the USB pipe.
//
//*****************************************************************************
uint32_t
USBHCDPipeTransferSizeGet(uint32_t ui32Pipe)
{
    uint32_t ui32Index;

    //
    // Get the index number from the allocated pipe.
    //
    ui32Index = (ui32Pipe & EP_PIPE_IDX_M);

    return(g_sUSBHCD.psUSBINPipes[ui32Index].ui32DataRead);
}

//*****************************************************************************
//
//! This function is used to allocate a USB HCD pipe.
//!
//! \param ui32Index specifies which USB controller to use.
//! \param ui32EndpointType is the type of endpoint that this pipe will be
//! communicating with.
//! \param psDevice is the device instance associated with this endpoint.
//! \param ui32Size is the size of the FIFO in bytes.
//! \param pfnCallback is the function that will be called when events occur on
//! this USB Pipe.
//!
//! Since there are a limited number of USB HCD pipes that can be used in the
//! host controller, this function is used to temporarily or permanently
//! acquire one of the endpoints.  Unlike the USBHCDPipeAlloc() function this
//! function allows the caller to specify the size of the FIFO allocated to
//! this endpoint in the \e ui32Size parameter.  This function also provides a
//! method to register a callback for status changes on this endpoint.  If no
//! callbacks are desired then the \e pfnCallback function should be set to 0.
//! The callback should be used when using the USBHCDPipeSchedule() function
//! so that the caller is notified when the action is complete.
//!
//! \return This function returns a value indicating which pipe was reserved.
//! If the value is 0 then there were no pipes currently available.  This value
//! should be passed to any USBHCDPipe APIs to indicate which pipe is being
//! accessed.
//
//*****************************************************************************
uint32_t
USBHCDPipeAllocSize(uint32_t ui32Index, uint32_t ui32EndpointType,
                    tUSBHostDevice *psDevice, uint32_t ui32Size,
                    tHCDPipeCallback pfnCallback)
{
    int32_t i32Idx;

    uint32_t ui32HubAddr;

    ASSERT(ui32Index == 0);

    //
    // Find a USB pipe that is free.
    //
    for(i32Idx = 0; i32Idx < MAX_NUM_PIPES; i32Idx++)
    {
        //
        // Handle OUT Pipes.
        //
        if(ui32EndpointType & EP_PIPE_TYPE_OUT)
        {
            //
            // A zero address indicates free.
            //
            if(g_sUSBHCD.psUSBOUTPipes[i32Idx].psDevice == 0)
            {
                //
                // Set up uDMA for the pipe.
                //
                if(ui32EndpointType & EP_PIPE_USE_UDMA)
                {
                    //
                    // Allocate a DMA channel to the endpoint.
                    //
                    g_sUSBHCD.psUSBOUTPipes[i32Idx].ui8DMAChannel =
                        USBLibDMAChannelAllocate(g_sUSBHCD.psDMAInstance,
                                                 IndexToUSBEP(i32Idx + 1),
                                                 ui32Size,
                                                 USB_DMA_EP_TX |
                                                 USB_DMA_EP_HOST);

                    //
                    // If no DMA channel was available then just disable DMA
                    // on this pipe.
                    //
                    if(g_sUSBHCD.psUSBOUTPipes[i32Idx].ui8DMAChannel == 0)
                    {
                        ui32EndpointType &= ~EP_PIPE_USE_UDMA;
                    }
                }

                //
                // Save the endpoint type and device address and callback
                // function.
                //
                g_sUSBHCD.psUSBOUTPipes[i32Idx].ui32Type = ui32EndpointType;
                g_sUSBHCD.psUSBOUTPipes[i32Idx].psDevice = psDevice;
                g_sUSBHCD.psUSBOUTPipes[i32Idx].pfnCallback = pfnCallback;

                //
                // Clear out any pending status on this endpoint in case it
                // was in use before a allowing a new device class to use it.
                //
                MAP_USBHostEndpointStatusClear(USB0_BASE,
                                               IndexToUSBEP(i32Idx + 1),
                                               USB_HOST_OUT_STATUS);

                //
                // Make sure to reset the data toggle.
                //
                USBEndpointDataToggleClear(USB0_BASE, IndexToUSBEP(i32Idx + 1),
                                           USB_EP_HOST_OUT);

                //
                // Initialize the endpoint as idle.
                //
                g_sUSBHCD.psUSBOUTPipes[i32Idx].iState = ePipeIdle;

                //
                // Allocate space in the FIFO for this endpoint.
                //
                if(FIFOAlloc(&g_sUSBHCD.psUSBOUTPipes[i32Idx], ui32Size) != 0)
                {
                    //
                    // Configure the FIFO.
                    //
                    MAP_USBFIFOConfigSet(USB0_BASE,
                                IndexToUSBEP(i32Idx + 1),
                                g_sUSBHCD.psUSBOUTPipes[i32Idx].ui16FIFOAddr,
                                g_sUSBHCD.psUSBOUTPipes[i32Idx].ui8FIFOSize,
                                USB_EP_HOST_OUT);
                }

                //
                // Set the function address for this endpoint.
                //
                MAP_USBHostAddrSet(USB0_BASE, IndexToUSBEP(i32Idx + 1),
                                   psDevice->ui32Address, USB_EP_HOST_OUT);

                //
                // Set the hub and port address for the endpoint.
                //
                ui32HubAddr = psDevice->ui8Hub | (psDevice->ui8HubPort << 8);
                USBHostHubAddrSet(USB0_BASE, IndexToUSBEP(i32Idx + 1),
                                  ui32HubAddr, (USB_EP_HOST_OUT |
                                                psDevice->ui32Speed));
                break;
            }
        }
        //
        // Handle IN Pipes.
        //
        else if(ui32EndpointType & EP_PIPE_TYPE_IN)
        {
            //
            // A zero address indicates free.
            //
            if(g_sUSBHCD.psUSBINPipes[i32Idx].psDevice == 0)
            {
                //
                // Set up uDMA for the pipe.
                //
                if(ui32EndpointType & EP_PIPE_USE_UDMA)
                {
                    //
                    // Allocate a DMA channel to the endpoint.
                    //
                    g_sUSBHCD.psUSBINPipes[i32Idx].ui8DMAChannel =
                            USBLibDMAChannelAllocate(g_sUSBHCD.psDMAInstance,
                                                     IndexToUSBEP(i32Idx + 1),
                                                     ui32Size,
                                                     USB_DMA_EP_RX |
                                                     USB_DMA_EP_HOST);

                    //
                    // If no DMA channel was available then just disable DMA
                    // on this pipe.
                    //
                    if(g_sUSBHCD.psUSBINPipes[i32Idx].ui8DMAChannel == 0)
                    {
                        ui32EndpointType &= ~EP_PIPE_USE_UDMA;
                    }
                }

                //
                // Save the endpoint type and device address and callback
                // function.
                //
                g_sUSBHCD.psUSBINPipes[i32Idx].ui32Type = ui32EndpointType;
                g_sUSBHCD.psUSBINPipes[i32Idx].psDevice = psDevice;
                g_sUSBHCD.psUSBINPipes[i32Idx].pfnCallback = pfnCallback;

                //
                // Clear out any pending status on this endpoint in case it
                // was in use before a allowing a new device class to use it.
                //
                MAP_USBHostEndpointStatusClear(USB0_BASE,
                                               IndexToUSBEP(i32Idx + 1),
                                               USB_HOST_IN_STATUS);

                //
                // Make sure to reset the data toggle.
                //
                USBEndpointDataToggleClear(USB0_BASE, IndexToUSBEP(i32Idx + 1),
                                           USB_EP_HOST_IN);

                //
                // Allocate space in the FIFO for this endpoint.
                //
                if(FIFOAlloc(&g_sUSBHCD.psUSBINPipes[i32Idx], ui32Size) != 0)
                {
                    //
                    // Configure the FIFO.
                    //
                    MAP_USBFIFOConfigSet(USB0_BASE,
                                IndexToUSBEP(i32Idx + 1),
                                g_sUSBHCD.psUSBINPipes[i32Idx].ui16FIFOAddr,
                                g_sUSBHCD.psUSBINPipes[i32Idx].ui8FIFOSize,
                                USB_EP_HOST_IN);
                }

                //
                // Set the function address for this endpoint.
                //
                MAP_USBHostAddrSet(USB0_BASE, IndexToUSBEP(i32Idx + 1),
                                   psDevice->ui32Address, USB_EP_HOST_IN);

                //
                // Set the hub and port address for the endpoint.
                //
                ui32HubAddr = psDevice->ui8Hub | (psDevice->ui8HubPort << 8);
                USBHostHubAddrSet(USB0_BASE, IndexToUSBEP(i32Idx + 1),
                                  ui32HubAddr, (USB_EP_HOST_IN |
                                                psDevice->ui32Speed));

                //
                // Reset the state of the pipe to idle.
                //
                g_sUSBHCD.psUSBINPipes[i32Idx].iState = ePipeIdle;

                break;
            }
        }
    }

    //
    // Did not find a free pipe.
    //
    if(i32Idx == MAX_NUM_PIPES)
    {
        return(0);
    }

    //
    // Return the pipe index and type that was allocated.
    //
    return(ui32EndpointType | i32Idx);
}

//*****************************************************************************
//
//! This function is used to allocate a USB HCD pipe.
//!
//! \param ui32Index specifies which USB controller to use.
//! \param ui32EndpointType is the type of endpoint that this pipe will be
//! communicating with.
//! \param psDevice is the device instance associated with this endpoint.
//! \param pfnCallback is the function that will be called when events occur on
//! this USB Pipe.
//!
//! Since there are a limited number of USB HCD pipes that can be used in the
//! host controller, this function is used to temporarily or permanently
//! acquire one of the endpoints.  It also provides a method to register a
//! callback for status changes on this endpoint.  If no callbacks are desired
//! then the \e pfnCallback function should be set to 0.  The callback should
//! be used when using the USBHCDPipeSchedule() function so that the caller is
//! notified when the action is complete.
//!
//! \return This function returns a value indicating which pipe was reserved.
//! If the value is 0 then there were no pipes currently available.  This value
//! should be passed to any USBHCDPipe APIs to indicate which pipe is being
//! accessed.
//
//*****************************************************************************
uint32_t
USBHCDPipeAlloc(uint32_t ui32Index, uint32_t ui32EndpointType,
                tUSBHostDevice *psDevice, tHCDPipeCallback pfnCallback)
{
    //
    // The old API allocated only 64 bytes to each endpoint.
    //
    return(USBHCDPipeAllocSize(ui32Index, ui32EndpointType, psDevice, 64,
                               pfnCallback));
}

//*****************************************************************************
//
//! This function is used to configure a USB HCD pipe.
//!
//! This should be called after allocating a USB pipe with a call to
//! USBHCDPipeAlloc().  It is used to set the configuration associated with an
//! endpoint like the max payload and target endpoint.  The \e ui32MaxPayload
//! parameter is typically read directly from the devices endpoint descriptor
//! and is expressed in bytes.
//!
//! Setting the \e ui32Interval parameter depends on the type of endpoint being
//! configured.  For endpoints that do not need to use the \e ui32Interval
//! parameter \e ui32Interval should be set to 0.  For Bulk \e ui32Interval is
//! a value from 2-16 and will set the NAK timeout value as
//! 2^(\e ui32Interval-1) frames.  For interrupt endpoints \e ui32Interval is a
//! value from 1-255 and is the count in frames between polling the endpoint.
//! For isochronous endpoints \e ui32Interval ranges from 1-16 and is the
//! polling interval in frames represented as 2^(\e ui32Interval-1) frames.
//!
//! \param ui32Pipe is the allocated endpoint to modify.
//! \param ui32MaxPayload is maximum data that can be handled per transaction.
//! \param ui32Interval is the polling interval for data transfers expressed in
//! frames.
//! \param ui32TargetEndpoint is the target endpoint on the device to
//! communicate with.
//!
//! \return If the call was successful, this function returns zero any other
//! value indicates an error.
//
//*****************************************************************************
uint32_t
USBHCDPipeConfig(uint32_t ui32Pipe, uint32_t ui32MaxPayload,
                 uint32_t ui32Interval, uint32_t ui32TargetEndpoint)
{
    uint32_t ui32Flags;
    uint32_t ui32Index;

    //
    // Get the index number from the allocated pipe.
    //
    ui32Index = (ui32Pipe & EP_PIPE_IDX_M);

    //
    // Set the direction.
    //
    if(ui32Pipe & EP_PIPE_TYPE_OUT)
    {
        //
        // Set the mode for this endpoint.
        //
        if(g_sUSBHCD.psUSBOUTPipes[ui32Index].ui32Type & EP_PIPE_TYPE_BULK)
        {
            ui32Flags = USB_EP_MODE_BULK;
        }
        else if(g_sUSBHCD.psUSBOUTPipes[ui32Index].ui32Type &
                EP_PIPE_TYPE_INTR)
        {
            ui32Flags = USB_EP_MODE_INT;
        }
        else if(g_sUSBHCD.psUSBOUTPipes[ui32Index].ui32Type &
                EP_PIPE_TYPE_ISOC)
        {
            ui32Flags = USB_EP_MODE_ISOC;
        }
        else
        {
            ui32Flags = USB_EP_MODE_CTRL;
        }

        ui32Flags |= USB_EP_HOST_OUT;

        g_sUSBHCD.psUSBOUTPipes[ui32Index].ui8EPNumber =
                                                (uint8_t)ui32TargetEndpoint;

        //
        // Save the interval and the next tick to trigger a scheduler event.
        //
        g_sUSBHCD.psUSBOUTPipes[ui32Index].ui32Interval = ui32Interval;
        g_sUSBHCD.psUSBOUTPipes[ui32Index].ui32NextEventTick =
                                            ui32Interval + g_ui32CurrentTick;

        //
        // Set the device speed.
        //
        ui32Flags |= (g_sUSBHCD.psUSBOUTPipes[ui32Index].psDevice->ui32Speed);

        //
        // Set up the appropriate flags if uDMA is used.
        //
        if(ui32Pipe & EP_PIPE_USE_UDMA)
        {
            ui32Flags |= USB_EP_DMA_MODE_0 | USB_EP_AUTO_SET;
        }
    }
    else
    {
        //
        // Set the mode for this endpoint.
        //
        if(g_sUSBHCD.psUSBINPipes[ui32Index].ui32Type & EP_PIPE_TYPE_BULK)
        {
            ui32Flags = USB_EP_MODE_BULK;
        }
        else if(g_sUSBHCD.psUSBINPipes[ui32Index].ui32Type & EP_PIPE_TYPE_INTR)
        {
            ui32Flags = USB_EP_MODE_INT;
        }
        else if(g_sUSBHCD.psUSBINPipes[ui32Index].ui32Type & EP_PIPE_TYPE_ISOC)
        {
            ui32Flags = USB_EP_MODE_ISOC;
        }
        else
        {
            ui32Flags = USB_EP_MODE_CTRL;
        }
        ui32Flags |= USB_EP_HOST_IN;

        g_sUSBHCD.psUSBINPipes[ui32Index].ui8EPNumber =
                                                (uint8_t)ui32TargetEndpoint;

        //
        // Save the interval and the next tick to trigger a scheduler event.
        //
        g_sUSBHCD.psUSBINPipes[ui32Index].ui32Interval = ui32Interval;
        g_sUSBHCD.psUSBINPipes[ui32Index].ui32NextEventTick =
                                            ui32Interval + g_ui32CurrentTick;

        //
        // Set the device speed.
        //
        ui32Flags |= g_sUSBHCD.psUSBINPipes[ui32Index].psDevice->ui32Speed;
        //
        // Set up the appropriate flags if uDMA is used.
        //
        if(ui32Pipe & EP_PIPE_USE_UDMA)
        {
            ui32Flags |= USB_EP_DMA_MODE_1 | USB_EP_AUTO_CLEAR |
                         USB_EP_AUTO_REQUEST;
        }
    }


    //
    // Configure the endpoint according to the flags determined above.
    //
    USBHostEndpointConfig(USB0_BASE,
                          IndexToUSBEP((ui32Pipe & EP_PIPE_IDX_M) + 1),
                          ui32MaxPayload, ui32Interval, ui32TargetEndpoint,
                          ui32Flags);

    return(0);
}

//*****************************************************************************
//
//! This function is used to return the current status of a USB HCD pipe.
//!
//! This function will return the current status for a given USB pipe.  If
//! there is no status to report this call will simply return
//! \b USBHCD_PIPE_NO_CHANGE.
//!
//! \param ui32Pipe is the USB pipe for this status request.
//!
//! \return This function returns the current status for the given endpoint.
//! This will be one of the \b USBHCD_PIPE_* values.
//
//*****************************************************************************
uint32_t
USBHCDPipeStatus(uint32_t ui32Pipe)
{
    return(0);
}

//*****************************************************************************
//
//! This function is used to write data to a USB HCD pipe.
//!
//! \param ui32Pipe is the USB pipe to put data into.
//! \param pui8Data is a pointer to the data to send.
//! \param ui32Size is the amount of data to send.
//!
//! This function will block until it has sent as much data as was
//! requested using the USB pipe's FIFO.  The caller should have registered a
//! callback with the USBHCDPipeAlloc() call in order to be informed when the
//! data has been transmitted.  The value returned by this function can be less
//! than the \e ui32Size requested if the USB pipe has less space available
//! than this request is making.
//!
//! \return This function returns the number of bytes that were scheduled to
//! be sent on the given USB pipe.
//
//*****************************************************************************
uint32_t
USBHCDPipeWrite(uint32_t ui32Pipe, uint8_t *pui8Data, uint32_t ui32Size)
{
    uint32_t ui32Endpoint, ui32RemainingBytes, ui32ByteToSend, ui32PipeIdx;
    bool bUseDMA;

    //
    // Determine which endpoint interface that this pipe is using.
    //
    ui32Endpoint = IndexToUSBEP((EP_PIPE_IDX_M & ui32Pipe) + 1);

    //
    // Get index used for looking up pipe data
    //
    ui32PipeIdx = ui32Pipe & EP_PIPE_IDX_M;

    //
    // Set the total number of bytes to send out.
    //
    ui32RemainingBytes = ui32Size;

    //
    // Default to using DMA.
    //
    bUseDMA = false;

    //
    // Initialize the bytes to send to all of the remaining bytes.
    //
    ui32ByteToSend = ui32RemainingBytes;

    //
    // Send all of the requested data.
    //
    while(ui32RemainingBytes != 0)
    {
        //
        // If uDMA is not enabled for this pipe, or if the uDMA workaround
        // is applied, then don't use uDMA for this transfer.
        //
        if(ui32Pipe & EP_PIPE_USE_UDMA)
        {
            //
            // Disable the USB interrupt.
            //
            OS_INT_DISABLE(g_sUSBHCD.ui32IntNum);

            //
            // Start the DMA transfer.
            //
            if(USBLibDMATransfer(g_sUSBHCD.psDMAInstance,
                            g_sUSBHCD.psUSBOUTPipes[ui32PipeIdx].ui8DMAChannel,
                            pui8Data, ui32RemainingBytes) != 0)
            {
                if(ui32RemainingBytes < 64)
                {
                    g_sUSBHCD.psUSBOUTPipes[ui32PipeIdx].iState =
                                                            ePipeWriteDMASend;
                }
                else if((ui32RemainingBytes % 64) == 0)
                {
                    g_sUSBHCD.psUSBOUTPipes[ui32PipeIdx].iState =
                                                                ePipeWriteDMA;
                }
                else
                {
                    g_sUSBHCD.psUSBOUTPipes[ui32PipeIdx].iState =
                                                        ePipeWriteDMASend;
                }

                bUseDMA = true;
            }

            //
            // Enable the USB interrupt.
            //
            OS_INT_ENABLE(g_sUSBHCD.ui32IntNum);
        }

        if(bUseDMA == false)
        {
            //
            // Only send 64 bytes at a time if not using DMA.
            //
            if(ui32ByteToSend > 64)
            {
                ui32ByteToSend = 64;
            }
            else
            {
                //
                // Send the requested number of bytes.
                //
                ui32ByteToSend = ui32RemainingBytes;
            }

            //
            // Start a write request.
            //
            g_sUSBHCD.psUSBOUTPipes[ui32PipeIdx].iState = ePipeWriting;

            //
            // Disable uDMA on the USB endpoint
            //
            MAP_USBEndpointDMADisable(USB0_BASE, ui32Endpoint,
                                      USB_EP_HOST_OUT);

            //
            // Put the data in the buffer.
            //
            MAP_USBEndpointDataPut(USB0_BASE, ui32Endpoint, pui8Data,
                                   ui32ByteToSend);

            //
            // Schedule the data to be sent.
            //
            MAP_USBEndpointDataSend(USB0_BASE, ui32Endpoint, USB_TRANS_OUT);
        }

        //
        // Wait for a status change.
        //
        while(1)
        {
            //
            // If an error event occurs then exit out of the loop.
            //
            if(g_sUSBHCD.ui32IntEvents & (INT_EVENT_DISCONNECT |
                                          INT_EVENT_VBUS_ERR |
                                          INT_EVENT_POWER_FAULT))
            {
                //
                // Set the pipe state to error.
                //
                g_sUSBHCD.psUSBOUTPipes[ui32PipeIdx].iState = ePipeError;

                //
                // Needs to be set to exit out of large while loop.
                //
                ui32RemainingBytes = 0;

                break;
            }
            //
            // If the data was successfully sent then decrement the count and
            // continue.
            //
            else if(g_sUSBHCD.psUSBOUTPipes[ui32PipeIdx].iState ==
                    ePipeDataSent)
            {
                //
                // Decrement the remaining data and advance the pointer.
                //
                ui32RemainingBytes -= ui32ByteToSend;
                pui8Data += ui32ByteToSend;

                //
                // If there are less than 64 bytes to send then this is the
                // last of the data to go out.
                //
                if(ui32RemainingBytes < 64)
                {
                    ui32ByteToSend = ui32RemainingBytes;
                }
                break;
            }
            else if(g_sUSBHCD.psUSBOUTPipes[ui32PipeIdx].iState ==
                    ePipeStalled)
            {
                //
                // Zero out the size so that the caller knows that no data was
                // written.
                //
                ui32Size = 0;

                //
                // Needs to be set to exit out of large while loop.
                //
                ui32RemainingBytes = 0;

                //
                // If DMA is being used, then disable the channel.
                //
                if(bUseDMA == true)
                {
                    //
                    // Disable the DMA channel.
                    //
                    USBLibDMAChannelDisable(g_sUSBHCD.psDMAInstance,
                        g_sUSBHCD.psUSBOUTPipes[ui32PipeIdx].ui8DMAChannel);
                }

                //
                // This is the actual endpoint number.
                //
                USBHCDClearFeature(
                    g_sUSBHCD.psUSBOUTPipes[ui32PipeIdx].psDevice->ui32Address,
                    ui32Pipe, USB_FEATURE_EP_HALT);

                //
                // If there was a stall, then no more data is coming so break
                // out.
                //
                break;
            }
            else if(g_sUSBHCD.psUSBOUTPipes[ui32PipeIdx].iState == ePipeError)
            {
                //
                // An error occurred so stop this transaction and set the
                // number of bytes to zero.
                //
                ui32Size = 0;

                //
                // Needs to be set to exit out of large while loop.
                //
                ui32RemainingBytes = 0;

                break;
            }
        }
    }

    //
    // Go Idle once this state has been reached.
    //
    g_sUSBHCD.psUSBOUTPipes[ui32PipeIdx].iState = ePipeIdle;

    return(ui32Size);
}

//*****************************************************************************
//
//! This function is used to schedule and IN transaction on a USB HCD pipe.
//!
//! \param ui32Pipe is the USB pipe to read data from.
//! \param pui8Data is a pointer to store the data that is received.
//! \param ui32Size is the size in bytes of the buffer pointed to by
//! \e pui8Data.
//!
//! This function will not block depending on the type of pipe passed in will
//! schedule either a send of data to the device or a read of data from the
//! device.  In either case the amount of data will be limited to what will
//! fit in the FIFO for a given endpoint.
//!
//! \return This function returns the number of bytes that were sent in the
//! case of a transfer of data or it will return 0 for a request on a USB IN
//! pipe.
//
//*****************************************************************************
uint32_t
USBHCDPipeSchedule(uint32_t ui32Pipe, uint8_t *pui8Data, uint32_t ui32Size)
{
    uint32_t ui32Endpoint, ui32PipeIdx;

    //
    // Get index used for looking up pipe data
    //
    ui32PipeIdx = ui32Pipe & EP_PIPE_IDX_M;

    //
    // Determine which endpoint interface that this pipe is using.
    //
    ui32Endpoint = IndexToUSBEP((EP_PIPE_IDX_M & ui32Pipe) + 1);

    if(ui32Pipe & EP_PIPE_TYPE_OUT)
    {
        //
        // Check if uDMA is enabled on this pipe.
        //
        if(ui32Pipe & EP_PIPE_USE_UDMA)
        {
            //
            // Start a write request.
            //
            g_sUSBHCD.psUSBOUTPipes[EP_PIPE_IDX_M & ui32Pipe].iState =
                                                            ePipeWriteDMASend;

            USBLibDMATransfer(g_sUSBHCD.psDMAInstance,
                            g_sUSBHCD.psUSBOUTPipes[ui32PipeIdx].ui8DMAChannel,
                            pui8Data, ui32Size);
        }
        else
        {
            //
            // Start a write request.
            //
            g_sUSBHCD.psUSBOUTPipes[EP_PIPE_IDX_M & ui32Pipe].iState =
                                                                ePipeWriting;

            //
            // Put the data in the buffer.
            //
            MAP_USBEndpointDataPut(USB0_BASE, ui32Endpoint, pui8Data,
                                   ui32Size);

            //
            // Schedule the data to be sent.
            //
            MAP_USBEndpointDataSend(USB0_BASE, ui32Endpoint, USB_TRANS_OUT);
        }
    }
    else
    {
        //
        // If uDMA is not enabled for this pipe, or if the uDMA workaround
        // is applied, then do not use uDMA for this transfer.
        //
        if((ui32Pipe & EP_PIPE_USE_UDMA) == 0)
        {
            //
            // Start a read request.
            //
            g_sUSBHCD.psUSBINPipes[EP_PIPE_IDX_M & ui32Pipe].iState =
                                                                ePipeReading;

            //
            // Disable uDMA on the endpoint
            //
            MAP_USBEndpointDMADisable(USB0_BASE, ui32Endpoint, USB_EP_HOST_IN);
        }
        //
        // Otherwise, uDMA should be used for this transfer, so set up
        // the uDMA channel in advance of triggering the IN request.
        //
        else
        {
            g_sUSBHCD.psUSBINPipes[EP_PIPE_IDX_M & ui32Pipe].iState =
                                                                ePipeReadDMA;

            USBLibDMATransfer(g_sUSBHCD.psDMAInstance,
                            g_sUSBHCD.psUSBINPipes[ui32PipeIdx].ui8DMAChannel,
                            pui8Data, ui32Size);
        }

        //
        // Remember details of the buffer into which the data will be read.
        //
        g_sUSBHCD.psUSBINPipes[ui32PipeIdx].pui8ReadPtr = pui8Data;
        g_sUSBHCD.psUSBINPipes[ui32PipeIdx].ui32ReadSize = ui32Size;

        //
        // Trigger a request for data from the device.
        //
        MAP_USBHostRequestIN(USB0_BASE, ui32Endpoint);

        //
        // No data was put into or read from the buffer.
        //
        ui32Size = 0;
    }
    return(ui32Size);
}

//*****************************************************************************
//
//! This function is used to read data from a USB HCD pipe.
//!
//! \param ui32Pipe is the USB pipe to read data from.
//! \param pui8Data is a pointer to store the data that is received.
//! \param ui32Size is the size in bytes of the buffer pointed to by
//! \e pui8Data.
//!
//! This function will not block and will only read as much data as requested
//! or as much data is currently available from the USB pipe.  The caller
//! should have registered a callback with the USBHCDPipeAlloc() call in order
//! to be informed when the data has been received.  The value returned by this
//! function can be less than the \e ui32Size requested if the USB pipe has
//! less data available than was requested.
//!
//! \return This function returns the number of bytes that were returned in the
//! \e pui8Data buffer.
//
//*****************************************************************************
uint32_t
USBHCDPipeReadNonBlocking(uint32_t ui32Pipe, uint8_t *pui8Data,
                          uint32_t ui32Size)
{
    uint32_t ui32Endpoint;

    //
    // Determine which endpoint interface that this pipe is using.
    //
    ui32Endpoint = IndexToUSBEP((EP_PIPE_IDX_M & ui32Pipe) + 1);

    //
    // Read the data out of the USB endpoint interface.
    //
    MAP_USBEndpointDataGet(USB0_BASE, ui32Endpoint, pui8Data, &ui32Size);

    //
    // Acknowledge that the data was read from the endpoint.
    //
    MAP_USBHostEndpointDataAck(USB0_BASE, ui32Endpoint);

    //
    // Go Idle once this state has been reached.
    //
    g_sUSBHCD.psUSBINPipes[EP_PIPE_IDX_M & ui32Pipe].iState = ePipeIdle;

    return(ui32Size);
}

//*****************************************************************************
//
//! This function acknowledges data received via an interrupt IN pipe.
//!
//! \param ui32Pipe is the USB INT pipe whose last packet is to be
//! acknowledged.
//!
//! This function is used to acknowledge reception of data on an interrupt IN
//! pipe.  A transfer on an interrupt IN endpoint is scheduled via a call to
//! USBHCDPipeSchedule() and the application is notified when data is received
//! using a \b USB_EVENT_RX_AVAILABLE event.  In the handler for this event,
//! the application must call USBHCDPipeDataAck() to have the USB controller
//! ACK the data from the device and complete the transaction.
//!
//! \return None.
//
//*****************************************************************************
void
USBHCDPipeDataAck(uint32_t ui32Pipe)
{
    uint32_t ui32Endpoint;

    //
    // Determine which endpoint interface that this pipe is using.
    //
    ui32Endpoint = IndexToUSBEP((EP_PIPE_IDX_M & ui32Pipe) + 1);

    //
    // Acknowledge that the data was read from the endpoint.
    //
    USBHostEndpointDataAck(USB0_BASE, ui32Endpoint);

    //
    // Go Idle once this state has been reached.
    //
    g_sUSBHCD.psUSBINPipes[EP_PIPE_IDX_M & ui32Pipe].iState = ePipeIdle;
}

//*****************************************************************************
//
//! This function is used to read data from a USB HCD pipe.
//!
//! \param ui32Pipe is the USB pipe to read data from.
//! \param pui8Data is a pointer to store the data that is received.
//! \param ui32Size is the size in bytes of the buffer pointed to by
//! \e pui8Data.
//!
//! This function will block and will only return when it has read as much data
//! as requested from the USB pipe.  The caller must register a callback with
//! the USBHCDPipeAlloc() call in order to be informed when the data has been
//! received.  If the caller provides a non-zero pointer in the \e pui8Data
//! parameter then the data is copied into the buffer before the callback
//! occurs.  If the caller provides a zero in \e pui8Data parameter
//! then the caller is responsible for reading the data out of the FIFO when
//! the \b USB_EVENT_RX_AVAILABLE callback event occurs.   The value returned
//! by this function can be less than the \e ui32Size requested if the USB pipe
//! has less data available than was requested.
//!
//! \return This function returns the number of bytes that were returned in the
//! \e pui8Data buffer.
//
//*****************************************************************************
uint32_t
USBHCDPipeRead(uint32_t ui32Pipe, uint8_t *pui8Data, uint32_t ui32Size)
{
    uint32_t ui32Endpoint, ui32RemainingBytes, ui32BytesRead, ui32PipeIdx;
    bool bUseDMA;

    //
    // Get index used for looking up pipe data
    //
    ui32PipeIdx = ui32Pipe & EP_PIPE_IDX_M;

    //
    // Initialized the number of bytes read.
    //
    ui32BytesRead = 0;

    //
    // Determine which endpoint interface that this pipe is using.
    //
    ui32Endpoint = IndexToUSBEP(ui32PipeIdx + 1);

    //
    // Set the remaining bytes to received.
    //
    ui32RemainingBytes = ui32Size;

    //
    // Default to using DMA.
    //
    bUseDMA = true;

    //
    // Continue until all data requested has been received.
    //
    while(ui32RemainingBytes != 0)
    {
        //
        // Start a read request.
        //
        g_sUSBHCD.psUSBINPipes[ui32PipeIdx].iState = ePipeReading;

        //
        // Try the DMA transfer should be used for this transfer, so set up
        // the uDMA channel in advance of triggering the IN request.
        //
        if(ui32Pipe & EP_PIPE_USE_UDMA)
        {
            //
            // Disable the USB interrupt.
            //
            OS_INT_DISABLE(g_sUSBHCD.ui32IntNum);

            if(USBLibDMATransfer(g_sUSBHCD.psDMAInstance,
                            g_sUSBHCD.psUSBINPipes[ui32PipeIdx].ui8DMAChannel,
                            pui8Data, ui32Size) != 0)
            {
                g_sUSBHCD.psUSBINPipes[ui32PipeIdx].iState = ePipeReadDMA;

                ui32BytesRead = ui32Size;
            }
            else
            {
                bUseDMA = false;
            }

            //
            // Disable the USB interrupt.
            //
            OS_INT_ENABLE(g_sUSBHCD.ui32IntNum);
        }

        //
        // If unable to use DMA then get ready to transfer without DMA.
        //
        if(bUseDMA == false)
        {
            //
            // Disable uDMA on the endpoint
            //
            MAP_USBEndpointDMADisable(USB0_BASE, ui32Endpoint, USB_EP_HOST_IN);

            //
            // Set up for the next transaction.
            //
            g_sUSBHCD.psUSBINPipes[ui32PipeIdx].pui8ReadPtr = pui8Data;
            g_sUSBHCD.psUSBINPipes[ui32PipeIdx].ui32ReadSize =
                        (ui32RemainingBytes < 64) ? ui32RemainingBytes : 64;
        }

        //
        // Trigger a request for data from the device.
        //
        MAP_USBHostRequestIN(USB0_BASE, ui32Endpoint);

        //
        // Wait for a status change.
        //
        while(1)
        {
            //
            // Check if the device stalled the request.
            //
            if(g_sUSBHCD.psUSBINPipes[ui32PipeIdx].iState == ePipeStalled)
            {
                //
                // Zero out the size so that the caller knows that no data was
                // read.
                //
                ui32Size = 0;

                //
                // There are also no remaining bytes to read.
                //
                ui32RemainingBytes = 0;

                //
                // If DMA is being used, then disable the channel.
                //
                if(bUseDMA == true)
                {
                    USBLibDMAChannelDisable(
                            g_sUSBHCD.psDMAInstance,
                            g_sUSBHCD.psUSBINPipes[ui32PipeIdx].ui8DMAChannel);
                }

                //
                // This is the actual endpoint number.
                //
                USBHCDClearFeature(
                    g_sUSBHCD.psUSBINPipes[ui32PipeIdx].psDevice->ui32Address,
                    ui32Pipe, USB_FEATURE_EP_HALT);

                //
                // If there was a stall, then no more data is coming so break
                // out.
                //
                break;
            }

            //
            // If any error event occurs then exit out of the loop.
            //
            if(g_sUSBHCD.ui32IntEvents & (INT_EVENT_DISCONNECT |
                                          INT_EVENT_VBUS_ERR |
                                          INT_EVENT_POWER_FAULT))
            {
                //
                // Set the pipe state to error.
                //
                g_sUSBHCD.psUSBINPipes[ui32PipeIdx].iState = ePipeError;
				
                //
                // Needs to be set to exit out of large while loop.
                //
                ui32RemainingBytes = 0;

                break;
            }

            //
            // If data is ready then return it.
            //
            if(g_sUSBHCD.psUSBINPipes[ui32PipeIdx].iState == ePipeDataReady)
            {
                //
                // If not using DMA then read the data from the USB.  Otherwise
                // the data will already be in the buffer.
                //
                if(bUseDMA == false)
                {
                    //
                    // Compute bytes to transfer and set up transfer
                    //
                    ui32BytesRead =
                            ui32RemainingBytes > 64 ? 64 : ui32RemainingBytes;

                    //
                    // Acknowledge that the data was read from the endpoint.
                    //
                    MAP_USBHostEndpointDataAck(USB0_BASE, ui32Endpoint);
                }

                //
                // Subtract the number of bytes read from the bytes remaining.
                //
                ui32RemainingBytes -= ui32BytesRead;

                //
                // If there were less than 64 bytes read, then this was a short
                // packet and no more data will be returned.
                //
                if(ui32BytesRead < 64)
                {
                    //
                    // Subtract off the bytes that were not received and exit
                    // the loop.
                    //
                    ui32Size = ui32Size - ui32RemainingBytes;
                    break;
                }
                else
                {
                    //
                    // Move the buffer ahead to receive more data into the
                    // buffer.
                    //
                    pui8Data += 64;
                }
                break;
            }
            else if(g_sUSBHCD.psUSBINPipes[ui32PipeIdx].iState == ePipeError)
            {
                //
                // An error occurred so stop this transaction and set the
                // number of bytes to zero.
                //
                ui32Size = 0;
                ui32RemainingBytes = 0;

                break;
            }
            else if((g_sUSBHCD.psUSBINPipes[ui32PipeIdx].iState ==
                     ePipeReadDMAWait) &&
                    (USBLibDMAChannelStatus(g_sUSBHCD.psDMAInstance,
                        g_sUSBHCD.psUSBINPipes[ui32PipeIdx].ui8DMAChannel) &
                     USBLIBSTATUS_DMA_COMPLETE))
            {
                break;
            }
        }
    }

    //
    // Go Idle once this state has been reached.
    //
    g_sUSBHCD.psUSBINPipes[ui32PipeIdx].iState = ePipeIdle;

    return(ui32Size);
}

//*****************************************************************************
//
//! This function is used to release a USB pipe.
//!
//! \param ui32Pipe is the allocated USB pipe to release.
//!
//! This function is used to release a USB pipe that was allocated by a call to
//! USBHCDPipeAlloc() for use by some other device endpoint in the system.
//! Freeing an unallocated or invalid pipe will not generate an error and will
//! instead simply return.
//!
//! \return None.
//
//*****************************************************************************
void
USBHCDPipeFree(uint32_t ui32Pipe)
{
    uint32_t ui32Index;

    //
    // Get the index number from the allocated pipe.
    //
    ui32Index = (ui32Pipe & EP_PIPE_IDX_M);

    if(ui32Pipe & EP_PIPE_TYPE_OUT)
    {
        //
        // Clear the address and type for this endpoint to free it up.
        //
        g_sUSBHCD.psUSBOUTPipes[ui32Index].psDevice = 0;
        g_sUSBHCD.psUSBOUTPipes[ui32Index].ui32Type = 0;
        g_sUSBHCD.psUSBOUTPipes[ui32Index].pfnCallback = 0;

        //
        // Check if this pipe has allocated a DMA channel.
        //
        if(g_sUSBHCD.psUSBOUTPipes[ui32Index].ui8DMAChannel !=
           USBHCD_DMA_UNUSED)
        {
            //
            // Release the DMA channel associated with this endpoint.
            //
            USBLibDMAChannelRelease(g_sUSBHCD.psDMAInstance,
                    g_sUSBHCD.psUSBOUTPipes[ui32Index].ui8DMAChannel);

            //
            // Clear out the current channel in use by this pipe.
            //
            g_sUSBHCD.psUSBOUTPipes[ui32Index].ui8DMAChannel =
                                                            USBHCD_DMA_UNUSED;
        }

        //
        // Free up the FIFO memory used by this endpoint.
        //
        if(g_sUSBHCD.psUSBOUTPipes[ui32Index].ui8FIFOSize)
        {
            FIFOFree(&g_sUSBHCD.psUSBOUTPipes[ui32Index]);
        }

        //
        // Set the function address for this endpoint back to zero.
        //
        USBHostAddrSet(USB0_BASE, IndexToUSBEP(ui32Index + 1),
                       0, USB_EP_HOST_OUT);

        //
        // Set the hub and port address for the endpoint back to zero and the
        // speed back to LOW.
        //
        USBHostHubAddrSet(USB0_BASE, IndexToUSBEP(ui32Index + 1),
                          0, (USB_EP_HOST_OUT | USB_EP_SPEED_LOW));
    }
    else if(ui32Pipe & EP_PIPE_TYPE_IN)
    {
        //
        // Clear the address and type for this endpoint to free it up.
        //
        g_sUSBHCD.psUSBINPipes[ui32Index].psDevice = 0;
        g_sUSBHCD.psUSBINPipes[ui32Index].ui32Type = 0;
        g_sUSBHCD.psUSBINPipes[ui32Index].pfnCallback = 0;

        //
        // Check if this pipe has allocated a DMA channel.
        //
        if(g_sUSBHCD.psUSBINPipes[ui32Index].ui8DMAChannel !=
           USBHCD_DMA_UNUSED)
        {
            //
            // Release the DMA channel associated with this endpoint.
            //
            USBLibDMAChannelRelease(g_sUSBHCD.psDMAInstance,
                    g_sUSBHCD.psUSBINPipes[ui32Index].ui8DMAChannel);

            //
            // Clear out the current channel in use by this pipe.
            //
            g_sUSBHCD.psUSBINPipes[ui32Index].ui8DMAChannel =
                                                            USBHCD_DMA_UNUSED;
        }

        //
        // Free up the FIFO memory used by this endpoint.
        //
        if(g_sUSBHCD.psUSBINPipes[ui32Pipe & EP_PIPE_IDX_M].ui8FIFOSize)
        {
            FIFOFree(&g_sUSBHCD.psUSBINPipes[ui32Pipe & EP_PIPE_IDX_M]);
        }

        //
        // Set the function address for this endpoint back to zero.
        //
        USBHostAddrSet(USB0_BASE, IndexToUSBEP(ui32Index + 1),
                       0, USB_EP_HOST_IN);

        //
        // Set the hub and port address for the endpoint back to zero and the
        // speed back to LOW.
        //
        USBHostHubAddrSet(USB0_BASE, IndexToUSBEP(ui32Index + 1),
                          0, (USB_EP_HOST_IN | USB_EP_SPEED_LOW));

        //
        // Clear any pending IN transactions.
        //
        USBHostRequestINClear(USB0_BASE, IndexToUSBEP(ui32Index + 1));
    }
}

//*****************************************************************************
//
// This internal function initializes the HCD code.
//
// \param ui32Index specifies which USB controller to use.
// \param pvPool is a pointer to the data to use as a memory pool for this
// controller.
// \param ui32PoolSize is the size in bytes of the buffer passed in as pvPool.
//
// This function will perform all the necessary operations to allow the USB
// host controller to begin enumeration and communication with a device.  This
// function should typically be called once at the start of an application
// before any other calls are made to the host controller.
//
// \return None.
//
//*****************************************************************************
static void
USBHCDInitInternal(uint32_t ui32Index, void *pvPool, uint32_t ui32PoolSize)
{
    int32_t i32Idx;

    ASSERT(ui32Index == 0);

    //
    // Get the number of endpoints supported by this device.
    //
    g_sUSBHCD.ui32NumEndpoints = USBNumEndpointsGet(USB0_BASE);

    //
    // The first 64 Bytes are allocated to endpoint 0.
    //
    g_pui32Alloc[0] = 1;
    g_pui32Alloc[1] = 0;

    //
    // Save the base address for this controller.
    //
    g_sUSBHCD.ui32USBBase = USB0_BASE;

    //
    // Save the USB interrupt number.
    //
    g_sUSBHCD.ui32IntNum = INT_USB0_TM4C123;

    //
    // These devices have a different USB interrupt number.
    //
    if(CLASS_IS_TM4C129)
    {
        g_sUSBHCD.ui32IntNum = INT_USB0_TM4C129;
    }

    //
    // All Pipes are unused at start.
    //
    for(i32Idx = 0; i32Idx < MAX_NUM_PIPES; i32Idx++)
    {
        g_sUSBHCD.psUSBINPipes[i32Idx].psDevice = 0;
        g_sUSBHCD.psUSBINPipes[i32Idx].ui32Type = USBHCD_PIPE_UNUSED;
        g_sUSBHCD.psUSBINPipes[i32Idx].ui8DMAChannel = USBHCD_DMA_UNUSED;
        g_sUSBHCD.psUSBOUTPipes[i32Idx].psDevice = 0;
        g_sUSBHCD.psUSBOUTPipes[i32Idx].ui32Type = USBHCD_PIPE_UNUSED;
        g_sUSBHCD.psUSBOUTPipes[i32Idx].ui8DMAChannel = USBHCD_DMA_UNUSED;
    }

    //
    // Make sure that the hub driver is initialized since it is called even
    // if it is not present in the system.
    //
    USBHHubInit();

    //
    // Initialize the DMA interface.
    //
    g_sUSBHCD.psDMAInstance = USBLibDMAInit(g_sUSBHCD.ui32USBBase);

    //
    // Initialized the device structures.
    //
    for(i32Idx = 0; i32Idx <= MAX_USB_DEVICES; i32Idx++)
    {
        //
        // Clear the configuration descriptor and state.
        //
        g_sUSBHCD.piDeviceState[i32Idx] = eHCDIdle;
        g_sUSBHCD.psUSBDevice[i32Idx].psConfigDescriptor = 0;
        g_sUSBHCD.psUSBDevice[i32Idx].bConfigRead = false;

        //
        // Initialize the device descriptor.
        //
        g_sUSBHCD.psUSBDevice[i32Idx].sDeviceDescriptor.bLength = 0;
        g_sUSBHCD.psUSBDevice[i32Idx].sDeviceDescriptor.bMaxPacketSize0 = 0;

        //
        // Initialize the device address.
        //
        g_sUSBHCD.psUSBDevice[i32Idx].ui32Address = 0;

        //
        // Set the current interface to 0.
        //
        g_sUSBHCD.psUSBDevice[i32Idx].ui32Interface = 0;

        //
        // Clear the active driver for the device.
        //
        g_pi32USBHActiveDriver[i32Idx] = -1;

        //
        // Initialize the device flags.
        //
        g_sUSBHCD.psUSBDevice[i32Idx].ui32Flags = 0;
    }

    //
    // Allocate the memory needed for reading descriptors.
    //
    g_sUSBHCD.pvPool = pvPool;
    g_sUSBHCD.ui32PoolSize = ui32PoolSize;

    //
    // Initialize the device class.
    //
    g_sUSBHCD.ui32Class = USB_CLASS_EVENTS;

    //
    // Default enable connect, disconnect, unknown device and power fault
    // event notifications.
    //
    g_sUSBHCD.ui32EventEnables = USBHCD_EVFLAG_CONNECT |
                                 USBHCD_EVFLAG_UNKCNCT |
                                 USBHCD_EVFLAG_DISCNCT |
                                 USBHCD_EVFLAG_PWRFAULT |
                                 USBHCD_EVFLAG_PWREN |
                                 USBHCD_EVFLAG_PWRDIS;

    //
    // Initialize the USB tick module.
    //
    InternalUSBTickInit();

    //
    // Only do hardware update if the stack is in Host mode, do not touch the
    // hardware for OTG mode operation.
    //
    if((g_iUSBMode == eUSBModeHost) || (g_iUSBMode == eUSBModeForceHost))
    {
        //
        // Configure the End point 0.
        //
        USBHostEndpointConfig(USB0_BASE, USB_EP_0, 64, 0, 0,
                              (USB_EP_MODE_CTRL | USB_EP_SPEED_FULL |
                               USB_EP_HOST_OUT));

        //
        // Enable USB Interrupts.
        //
        MAP_USBIntEnableControl(USB0_BASE, USB_INTCTRL_RESET |
                                           USB_INTCTRL_DISCONNECT |
                                           USB_INTCTRL_SOF |
                                           USB_INTCTRL_SESSION |
                                           USB_INTCTRL_BABBLE |
                                           USB_INTCTRL_CONNECT |
                                           USB_INTCTRL_RESUME |
                                           USB_INTCTRL_SUSPEND |
                                           USB_INTCTRL_VBUS_ERR |
                                           USB_INTCTRL_POWER_FAULT);

        MAP_USBIntEnableEndpoint(USB0_BASE, USB_INTEP_ALL);

        //
        // Enable the USB interrupt.
        //
        OS_INT_ENABLE(g_sUSBHCD.ui32IntNum);

        //
        // There is no automatic power in pure host mode.
        //
        USBHCDPowerConfigSet(ui32Index, (g_ui32PowerConfig &
                                         ~USB_HOST_PWREN_AUTO));

        //
        // Force the power on as well as this point.
        //
        MAP_USBHostPwrEnable(USB0_BASE);

        //
        // This is required to get into host mode on some parts.
        //
        USBOTGSessionRequest(USB0_BASE, true);
    }

    //
    // Configure LPM if it is enabled.
    //
    if(g_sUSBHCD.ui32Features & USBLIB_FEATURE_LPM_EN)
    {
        if(g_sUSBHCD.ui32Features & USBLIB_FEATURE_LPM_RMT_WAKE)
        {
            USBHostLPMConfig(USB0_BASE, g_sUSBHCD.ui32LPMHIRD,
                             USB_DEV_LPM_LS_L1 | USB_DEV_LPM_LS_RMTWAKE);
        }
        else
        {
            USBHostLPMConfig(USB0_BASE, g_sUSBHCD.ui32LPMHIRD,
                             USB_DEV_LPM_LS_L1);
        }

        //
        // Enable USB interrupts for LPM mode, these enables have no effect on
        // devices that do not support LPM.
        //
        USBLPMIntEnable(USB0_BASE, USB_INTLPM_ERROR | USB_INTLPM_RESUME |
                                   USB_INTLPM_INCOMPLETE | USB_INTLPM_ACK |
                                   USB_INTLPM_NYET | USB_INTLPM_STALL);
    }
}

//*****************************************************************************
//
//! This function is used to set the power pin and power fault configuration.
//!
//! \param ui32Index specifies which USB controller to use.
//! \param ui32PwrConfig is the power configuration to use for the application.
//!
//! This function must be called before HCDInit() is called so that the power
//! pin configuration can be set before power is enabled.  The \e ui32PwrConfig
//! flags specify the power fault level sensitivity, the power fault action,
//! and the power enable pin level and source.
//!
//! One of the following can be selected as the power fault level sensitivity:
//!
//! - \b USBHCD_FAULT_LOW - An external power fault is indicated by the pin
//!                         being driven low.
//! - \b USBHCD_FAULT_HIGH - An external power fault is indicated by the pin
//!                          being driven high.
//!
//! One of the following can be selected as the power fault action:
//!
//! - \b USBHCD_FAULT_VBUS_NONE - No automatic action when power fault
//!   detected.
//! - \b USBHCD_FAULT_VBUS_TRI - Automatically Tri-state the USBnEPEN pin on a
//!                              power fault.
//! - \b USBHCD_FAULT_VBUS_DIS - Automatically drive the USBnEPEN pin to it's
//!                              inactive state on a power fault.
//!
//! One of the following can be selected as the power enable level and source:
//!
//! - \b USBHCD_VBUS_MANUAL - Power control is completely managed by the
//!                           application, the USB library will provide a
//!                           power callback to request power state changes.
//! - \b USBHCD_VBUS_AUTO_LOW - USBEPEN is driven low by the USB controller
//!                             automatically if USBOTGSessionRequest() has
//!                             enabled a session.
//! - \b USBHCD_VBUS_AUTO_HIGH - USBEPEN is driven high by the USB controller
//!                              automatically if USBOTGSessionRequest() has
//!                              enabled a session.
//!
//! If \b USBHCD_VBUS_MANUAL is used then the application must provide an
//! event driver to receive the \b USB_EVENT_POWER_ENABLE and
//! \b USB_EVENT_POWER_DISABLE events and enable and disable power to VBUS when
//! requested by the USB library.  The application should respond to a power
//! control callback by enabling or disabling VBUS as soon as possible and
//! before returning from the callback function.
//!
//! \note The following values should no longer be used with the USB
//! library: \b USB_HOST_PWRFLT_LOW, \b USB_HOST_PWRFLT_HIGH,
//! \b USB_HOST_PWRFLT_EP_NONE, \b USB_HOST_PWRFLT_EP_TRI,
//! \b USB_HOST_PWRFLT_EP_LOW, \b USB_HOST_PWRFLT_EP_HIGH,
//! \b USB_HOST_PWREN_LOW, \b USB_HOST_PWREN_HIGH, \b USB_HOST_PWREN_VBLOW, and
//! \b USB_HOST_PWREN_VBHIGH.
//!
//! \return None.
//
//*****************************************************************************
void
USBHCDPowerConfigInit(uint32_t ui32Index, uint32_t ui32PwrConfig)
{
    ASSERT(ui32Index == 0);

    //
    // Save the value as it will be used later.
    //
    g_ui32PowerConfig = ui32PwrConfig;
}

//*****************************************************************************
//
//! This function is used to get the power pin and power fault configuration.
//!
//! \param ui32Index specifies which USB controller to use.
//!
//! This function will return the current power control pin configuration as
//! set by the USBHCDPowerConfigInit() function or the defaults if not yet set.
//! See the USBHCDPowerConfigInit() documentation for the meaning of the bits
//! that are returned by this function.
//!
//! \return The configuration of the power control pins.
//!
//*****************************************************************************
uint32_t
USBHCDPowerConfigGet(uint32_t ui32Index)
{
    ASSERT(ui32Index == 0);

    //
    // Save the value as it will be used later.
    //
    return(g_ui32PowerConfig);
}

//*****************************************************************************
//
//! This function is used to set the power pin and power fault configuration.
//!
//! \param ui32Index specifies which USB controller to use.
//! \param ui32Config specifies which USB power configuration to use.
//!
//! This function will set the current power control pin configuration as
//! set by the USBHCDPowerConfigInit() function or the defaults if not yet set.
//! See the USBHCDPowerConfigInit() documentation for the meaning of the bits
//! that are set by this function.
//!
//! \return Returns zero to indicate the power setting is now active.
//!
//*****************************************************************************
uint32_t
USBHCDPowerConfigSet(uint32_t ui32Index, uint32_t ui32Config)
{
    ASSERT(ui32Index == 0);

    //
    // Remember the current setting.
    //
    g_ui32PowerConfig = ui32Config;

    //
    // Clear out the two flag bits.
    //
    ui32Config = g_ui32PowerConfig & ~(USBHCD_VBUS_MANUAL |
                                       USBHCD_FAULT_VBUS_DIS);

    //
    // If there is an automatic disable power action specified then set the
    // polarity of the signal to match EPEN.
    //
    if(g_ui32PowerConfig & USBHCD_FAULT_VBUS_DIS)
    {
        //
        // Insure that the assumption below is true.
        //
        ASSERT((USBHCD_VBUS_AUTO_HIGH & 1) == 1);
        ASSERT((USBHCD_VBUS_AUTO_LOW & 1) == 0);

        //
        // This is taking advantage of the difference between
        // USBHCD_VBUS_AUTO_LOW and USBHCD_VBUS_AUTO_HIGH being that bit
        // one is set when EPEN is active high.
        //
        if(g_ui32PowerConfig & 1)
        {
            g_ui32PowerConfig |= USB_HOST_PWRFLT_EP_LOW;
            ui32Config |= USB_HOST_PWRFLT_EP_LOW;
        }
        else
        {
            g_ui32PowerConfig |= USB_HOST_PWRFLT_EP_HIGH;
            ui32Config |= USB_HOST_PWRFLT_EP_HIGH;
        }
    }

    //
    // Initialize the power configuration.
    //
    MAP_USBHostPwrConfig(USB0_BASE, ui32Config);

    //
    // If not in manual mode then just turn on power.
    //
    if((g_ui32PowerConfig & USBHCD_VBUS_MANUAL) == 0)
    {
        //
        // Power the USB bus.
        //
        MAP_USBHostPwrEnable(USB0_BASE);
    }

    //
    // Return success.
    //
    return(0);
}

//*****************************************************************************
//
//! This function returns if the current power settings will automatically
//! handle enabling and disabling VBUS power.
//!
//! \param ui32Index specifies which USB controller to query.
//!
//! This function returns if the current power control pin configuration will
//! automatically apply power or whether it will be left to the application
//! to turn on power when it is notified.
//!
//! \return A non-zero value indicates that power is automatically applied and
//! a value of zero indicates that the application must manually apply power.
//!
//*****************************************************************************
uint32_t
USBHCDPowerAutomatic(uint32_t ui32Index)
{
    //
    // Check if the controller is automatically applying power or not.
    //
    if(g_ui32PowerConfig & USBHCD_VBUS_MANUAL)
    {
        return(0);
    }
    return(1);
}

//*****************************************************************************
//
//! This function is used to initialize the HCD code.
//!
//! \param ui32Index specifies which USB controller to use.
//! \param pvPool is a pointer to the data to use as a memory pool for this
//! controller.
//! \param ui32PoolSize is the size in bytes of the buffer passed in as
//! \e pvPool.
//!
//! This function will perform all the necessary operations to allow the USB
//! host controller to begin enumeration and communication with devices.  This
//! function should typically be called once at the start of an application
//! once all of the device and class drivers are ready for normal operation.
//! This call will start up the USB host controller and any connected device
//! will immediately start the enumeration sequence.
//!
//! The USBStackModeSet() function can be called with eUSBModeHost in order to
//! cause the USB library to force the USB operating mode to a host controller.
//! This allows the application to used the USBVBUS and USBID pins as GPIOs on
//! devices that support forcing OTG to operate as a host only controller.  By
//! default the USB library will assume that the USBVBUS and USBID pins are
//! configured as USB pins and not GPIOs.
//!
//! The memory pool passed to this function must be at least as large as a
//! typical configuration descriptor for devices that are to be supported.
//! This value is application-dependent however it should never be less than 32
//! bytes and, in most cases, should be at least 64 bytes.  If there is not
//! sufficient memory to load a configuration descriptor from a device, the
//! device will not be recognized by the USB library's host controller driver.
//!
//! \return None.
//
//*****************************************************************************
void
USBHCDInit(uint32_t ui32Index, void *pvPool, uint32_t ui32PoolSize)
{
    int32_t i32Driver;

    //
    // Check the arguments.
    //
    ASSERT(ui32Index == 0);

    //
    // Make sure there is at least enough to read the configuration descriptor.
    //
    ASSERT(ui32PoolSize >= sizeof(tConfigDescriptor));

    //
    // Should not call this if the stack is in device mode.
    //
    ASSERT(g_iUSBMode != eUSBModeDevice);
    ASSERT(g_iUSBMode != eUSBModeForceDevice);

    //
    // If the mode was not set then default to eUSBModeHost.
    //
    if(g_iUSBMode == eUSBModeNone)
    {
        g_iUSBMode = eUSBModeHost;
    }

    //
    // Reset the USB controller.
    //
    MAP_SysCtlPeripheralReset(SYSCTL_PERIPH_USB0);

    //
    // Enable Clocking to the USB controller.
    //
    MAP_SysCtlPeripheralEnable(SYSCTL_PERIPH_USB0);

    //
    // Turn on USB Phy clock.
    //
    MAP_SysCtlUSBPLLEnable();

    //
    // Set the PLL to USB clock divider.
    //
    if(g_ui32PLLDiv == 0)
    {
        USBClockEnable(USB0_BASE, g_ui32PLLDiv, USB_CLOCK_EXTERNAL);
    }
    else
    {
        USBClockEnable(USB0_BASE, g_ui32PLLDiv, USB_CLOCK_INTERNAL);
    }

    //
    // Configure ULPI support.
    //
    if(g_ui32ULPISupport != USBLIB_FEATURE_ULPI_NONE)
    {
        USBULPIEnable(USB0_BASE);

        if(g_ui32ULPISupport & USBLIB_FEATURE_ULPI_HS)
        {
            ULPIConfigSet(USB0_BASE, ULPI_CFG_HS);
        }
        else
        {
            ULPIConfigSet(USB0_BASE, ULPI_CFG_FS);
        }
    }
    else
    {
        USBULPIDisable(USB0_BASE);
    }

    //
    // If the application not requesting OTG mode then set the mode to forced
    // host mode.  If the mode is actually eUSBModeHost, this will be switched
    // off when ID pin detection is complete and the ID is no longer in use.
    //
    if(g_iUSBMode != eUSBModeOTG)
    {
        //
        // Force Host mode on devices that support force host mode.
        //
        MAP_USBHostMode(USB0_BASE);
    }

    //
    // Call our internal function to perform the initialization.
    //
    USBHCDInitInternal(ui32Index, pvPool, ui32PoolSize);

    //
    // No event driver is present by default.
    //
    g_sUSBHCD.i32EventDriver = -1;

    //
    // Search through the Host Class driver list for the devices class.
    //
    for(i32Driver = 0; i32Driver < g_sUSBHCD.ui32NumClassDrivers; i32Driver++)
    {
        if(g_sUSBHCD.ppsClassDrivers[i32Driver]->ui32InterfaceClass ==
           USB_CLASS_EVENTS)
        {
            //
            // Event driver was found so remember it.
            //
            g_sUSBHCD.i32EventDriver = i32Driver;
        }
    }

    //
    // Get the number of ticks per millisecond, this is only used by blocking
    // delays using the SysCtlDelay() function.
    //
    if(g_ui32Tickms == 0)
    {
        if(CLASS_IS_TM4C129)
        {
            g_ui32Tickms = 120000000 / 3000;
        }
        else
        {
            g_ui32Tickms = 80000000 / 3000;
        }
    }
}

//*****************************************************************************
//
//! This function is used to initialize the HCD class driver list.
//!
//! \param ui32Index specifies which USB controller to use.
//! \param ppsHClassDrvs is an array of host class drivers that are
//! supported on this controller.
//! \param ui32NumDrivers is the number of entries in the \e pHostClassDrivers
//! array.
//!
//! This function will set the host classes supported by the host controller
//! specified by the \e ui32Index parameter.  This function should be called
//! before enabling the host controller driver with the USBHCDInit() function.
//!
//! \return None.
//
//*****************************************************************************
void
USBHCDRegisterDrivers(uint32_t ui32Index,
                      const tUSBHostClassDriver * const *ppsHClassDrvs,
                      uint32_t ui32NumDrivers)
{
    ASSERT(ui32Index == 0);

    //
    // Save the class drivers.
    //
    g_sUSBHCD.ppsClassDrivers = ppsHClassDrvs;

    //
    // Save the number of class drivers.
    //
    g_sUSBHCD.ui32NumClassDrivers = ui32NumDrivers;
}

//*****************************************************************************
//
//! This function is used to terminate the HCD code.
//!
//! \param ui32Index specifies which USB controller to release.
//!
//! This function will clean up the USB host controller and disable it in
//! preparation for shutdown or a switch to USB device mode.  Once this call is
//! made, \e USBHCDInit() may be called to reinitialize the controller and
//! prepare for host mode operation.
//!
//! \return None.
//
//*****************************************************************************
void
USBHCDTerm(uint32_t ui32Index)
{
    int32_t i32Idx;

    ASSERT(ui32Index == 0);

    //
    // End the session.
    //
    USBOTGSessionRequest(USB0_BASE, false);

    //
    // Remove power from the USB bus.
    //
    MAP_USBHostPwrDisable(USB0_BASE);

    //
    // Disable USB interrupts.
    //
    OS_INT_DISABLE(g_sUSBHCD.ui32IntNum);

    MAP_USBIntDisableControl(USB0_BASE, USB_INTCTRL_ALL);

    MAP_USBIntDisableEndpoint(USB0_BASE, USB_INTEP_ALL);

    //
    // Set the host controller state back to it's initial values.
    //
    for(i32Idx = 0; i32Idx < MAX_NUM_PIPES; i32Idx++)
    {
        g_sUSBHCD.psUSBINPipes[i32Idx].ui32Type = USBHCD_PIPE_UNUSED;
        g_sUSBHCD.psUSBOUTPipes[i32Idx].ui32Type = USBHCD_PIPE_UNUSED;
    }

    //
    // Free the memory used by the configuration descriptor.
    //
    ConfigDescFree(&g_sUSBHCD.psUSBDevice[0]);

    g_sUSBHCD.piDeviceState[0] = eHCDIdle;
    g_sUSBHCD.psUSBDevice[0].psConfigDescriptor = 0;
    g_sUSBHCD.psUSBDevice[0].bConfigRead = false;
    g_sUSBHCD.psUSBDevice[0].sDeviceDescriptor.bLength = 0;
    g_sUSBHCD.psUSBDevice[0].sDeviceDescriptor.bMaxPacketSize0 = 0;
    g_sUSBHCD.psUSBDevice[0].ui32Address = 0;
    g_sUSBHCD.psUSBDevice[0].ui32Interface = 0;
    g_sUSBHCD.pvPool = 0;
    g_sUSBHCD.ui32PoolSize = 0;
}

//*****************************************************************************
//
//! This function generates reset signaling on the USB bus.
//!
//! \param ui32Index specifies which USB controller to use.
//!
//! This function handles sending out reset signaling on the USB bus.  After
//! returning from this function, any attached device on the USB bus should
//! have returned to it's reset state.
//!
//! \return None.
//
//*****************************************************************************
void
USBHCDReset(uint32_t ui32Index)
{
    ASSERT(ui32Index == 0);

    //
    // Start the reset signaling.
    //
    MAP_USBHostReset(USB0_BASE, 1);

    //
    // Wait 20ms
    //
    OS_DELAY(g_ui32Tickms * 20);

    //
    // End reset signaling on the bus.
    //
    MAP_USBHostReset(USB0_BASE, 0);

    //
    // Need to wait at least 10ms to let the device recover from
    // the reset.  This is the delay specified in the USB 2.0 spec.
    // We will hold the reset for 20ms.
    //
    OS_DELAY(g_ui32Tickms * 20);
}

//*****************************************************************************
//
//! This function will generate suspend signaling on the USB bus.
//!
//! \param ui32Index specifies which USB controller to use.
//!
//! This function is used to generate suspend signaling on the USB bus.  In
//! order to leave the suspended state, the application should call
//! USBHCDResume().
//!
//! \return None.
//
//*****************************************************************************
void
USBHCDSuspend(uint32_t ui32Index)
{
    ASSERT(ui32Index == 0);

    //
    // Start the suspend signaling.
    //
    MAP_USBHostSuspend(USB0_BASE);
}

//*****************************************************************************
//
//! This function will generate resume signaling on the USB bus.
//!
//! \param ui32Index specifies which USB controller to use.
//!
//! This function is used to generate resume signaling on the USB bus in order
//! to cause  USB devices to leave their suspended state.  This call should
//! not be made unless a preceding call to USBHCDSuspend() has been made.
//!
//! \return None.
//
//*****************************************************************************
void
USBHCDResume(uint32_t ui32Index)
{
    ASSERT(ui32Index == 0);

    //
    // Start the resume signaling.
    //
    MAP_USBHostResume(USB0_BASE, 1);

    //
    // Wait 100ms
    //
    OS_DELAY(g_ui32Tickms * 100);

    //
    // End reset signaling on the bus.
    //
    MAP_USBHostResume(USB0_BASE, 0);
}

//*****************************************************************************
//
//! This function issues a request for the current configuration descriptor
//! from a device.
//!
//! \param ui32Index specifies which USB controller to use.
//! \param psDevice is a pointer to the device structure that holds the buffer
//! to store the configuration descriptor.
//!
//! This function will request the configuration descriptor from the device.
//! The \e psDevice->ConfigDescriptor member variable is used to hold the data
//! for this request.  This buffer will be allocated from the pool provided by
//! the HCDInit() function.  \e psDevice->sDeviceDescriptor.bMaxPacketSize0
//! should be valid prior to this call in order to correctly receive the
//! configuration descriptor.  If this variable is not valid then this call
//! will not return accurate data.
//!
//! \return The number of bytes returned due to the request.  This value can be
//! zero if the device did not respond.
//
//*****************************************************************************
static uint32_t
USBHCDGetConfigDescriptor(uint32_t ui32Index, tUSBHostDevice *psDevice)
{
    tUSBRequest sSetupPacket;
    uint32_t ui32Bytes;
    tConfigDescriptor sConfigDescriptor;

    ASSERT(ui32Index == 0);

    ui32Bytes = 0;

    //
    // This is a Standard Device IN request.
    //
    sSetupPacket.bmRequestType =
        USB_RTYPE_DIR_IN | USB_RTYPE_STANDARD | USB_RTYPE_DEVICE;

    //
    // Request a Device Descriptor.
    //
    sSetupPacket.bRequest = USBREQ_GET_DESCRIPTOR;
    sSetupPacket.wValue = USB_DTYPE_CONFIGURATION << 8;

    //
    // Index is always 0 for device configurations requests.
    //
    sSetupPacket.wIndex = 0;

    //
    // Only ask for the configuration header first to see how big the
    // whole thing is.
    //
    if(!psDevice->bConfigRead)
    {
        //
        // Only request the space available.
        //
        sSetupPacket.wLength = sizeof(tConfigDescriptor);

        //
        // Put the setup packet in the buffer.
        //
        ui32Bytes =
            USBHCDControlTransfer(0, &sSetupPacket, psDevice,
                                  (uint8_t *)&sConfigDescriptor,
                                  sizeof(tConfigDescriptor),
                                  psDevice->sDeviceDescriptor.bMaxPacketSize0);
    }

    //
    // If the Configuration header was successfully returned then get the
    // full configuration descriptor.
    //
    if(ui32Bytes == sizeof(tConfigDescriptor))
    {
        //
        // Save the total size and request the full configuration descriptor.
        //
        sSetupPacket.wLength = sConfigDescriptor.wTotalLength;

        //
        // Not enough space to hold this configuration descriptor.
        //
        if(ConfigDescAlloc(psDevice, sConfigDescriptor.wTotalLength) == 0)
        {
            return(0);
        }

        //
        // Don't allow the buffer to be larger than was allocated.
        //
        if(sSetupPacket.wLength > psDevice->ui32ConfigDescriptorSize)
        {
            return(0);
        }

        //
        // Put the setup packet in the buffer.
        //
        ui32Bytes =
            USBHCDControlTransfer(0, &sSetupPacket, psDevice,
                                  (uint8_t *)psDevice->psConfigDescriptor,
                                  sSetupPacket.wLength,
                                  psDevice->sDeviceDescriptor.bMaxPacketSize0);

        //
        // If we read the descriptor, remember the fact.
        //
        if(ui32Bytes)
        {
            psDevice->bConfigRead = true;
        }
    }

    return(ui32Bytes);
}

//*****************************************************************************
//
//! This function issues a request for a device descriptor from a device.
//!
//! \param ui32Index specifies which USB controller to use.
//! \param psDevice is a pointer to the device structure that holds the buffer
//! to store the device descriptor into.
//!
//! This function will request the device descriptor from the device.  The
//! \e psDevice->sDeviceDescriptor descriptor is used to hold the data for this
//! request.  \e psDevice->sDeviceDescriptor.bMaxPacketSize0 should be
//! initialized to zero or to the valid maximum packet size if it is known.  If
//! this variable is not set to zero, then this call will determine the maximum
//! packet size for endpoint 0 and save it in the structure member
//! bMaxPacketSize0.
//!
//! \return The number of bytes returned due to the request.  This value can be
//! zero if the device did not respond.
//
//*****************************************************************************
static uint32_t
USBHCDGetDeviceDescriptor(uint32_t ui32Index, tUSBHostDevice *psDevice)
{
    tUSBRequest sSetupPacket;
    uint32_t ui32Bytes;

    ASSERT(ui32Index == 0);

    //
    // This is a Standard Device IN request.
    //
    sSetupPacket.bmRequestType =
        USB_RTYPE_DIR_IN | USB_RTYPE_STANDARD | USB_RTYPE_DEVICE;

    //
    // Request a Device Descriptor.
    //
    sSetupPacket.bRequest = USBREQ_GET_DESCRIPTOR;
    sSetupPacket.wValue = USB_DTYPE_DEVICE << 8;

    //
    // Index is always 0 for device requests.
    //
    sSetupPacket.wIndex = 0;

    //
    // All devices must have at least an 8 byte max packet size so just ask
    // for 8 bytes to start with.
    //
    sSetupPacket.wLength = sizeof(tDeviceDescriptor);

    ui32Bytes = 0;

    //
    // Discover the max packet size for endpoint 0.
    //
    if(psDevice->sDeviceDescriptor.bMaxPacketSize0 == 0)
    {
        //
        // Put the setup packet in the buffer.
        //
        ui32Bytes =
            USBHCDControlTransfer(ui32Index, &sSetupPacket, psDevice,
                                  (uint8_t *)&(psDevice->sDeviceDescriptor),
                                  sizeof(tDeviceDescriptor), 8);
    }

    //
    // Now get the full descriptor now that the actual maximum packet size
    // is known.
    //
    if(ui32Bytes < sizeof(tDeviceDescriptor))
    {
        sSetupPacket.wLength = (uint16_t)sizeof(tDeviceDescriptor);

        ui32Bytes =
            USBHCDControlTransfer(ui32Index, &sSetupPacket, psDevice,
                                  (uint8_t *)&(psDevice->sDeviceDescriptor),
                                  sizeof(tDeviceDescriptor),
                                  psDevice->sDeviceDescriptor.bMaxPacketSize0);
    }

    return(ui32Bytes);
}

//*****************************************************************************
//
//! This function issues a request for a string descriptor from a device.
//!
//! \param psDevice is the device for this request.
//! \param pui8Buffer is the pointer to the buffer to store the requested
//! string descriptor.
//! \param ui32Size is the size of the buffer passed in the buffer that will
//! be used for this request.
//! \param ui32LangID is the ID of the language for the requested string.
//! \param ui32StringIndex is the index for the request.
//!
//! This function will request a string descriptor from the device of the type
//! specified in the \e ui32DescriptorType parameter.  The \e pui8Descriptor
//! pointer is the location where the request results will be stored.  The
//! \e ui32Size should be passed in to indicate the size of the
//! \e pui8Descriptor buffer.  The \e ui32DevAddress parameter is used to
//! specify the device address to communicate with on the USB bus.  This value
//! should be specified as 0 for any non-configured device on the USB bus and
//! be changed to the address set by a call to USBHCDSetAddress().
//!
//! \return The number of bytes returned in the \e pui8Buffer due to the
//! request.  This value can be zero if the device did not respond.
//
//*****************************************************************************
uint32_t
USBHCDStringDescriptorGet(tUSBHostDevice *psDevice, uint8_t *pui8Buffer,
                          uint32_t ui32Size, uint32_t ui32LangID,
                          uint32_t ui32StringIndex)
{
    uint32_t ui32BytesReturned;
    tUSBRequest sSetupPacket;

    //
    // Default the number of bytes to zero.
    //
    ui32BytesReturned = 0;

    //
    // This is a Standard Device IN request.
    //
    sSetupPacket.bmRequestType =
        USB_RTYPE_DIR_IN | USB_RTYPE_STANDARD | USB_RTYPE_DEVICE;

    //
    // Request a Device Descriptor.
    //
    sSetupPacket.bRequest = USBREQ_GET_DESCRIPTOR;

    //
    // Request for a string descriptor.
    //
    sSetupPacket.wValue = (USB_DTYPE_STRING << 8) |
                         (uint16_t)ui32StringIndex;

    //
    // Set the language ID.
    //
    sSetupPacket.wIndex = ui32LangID;

    //
    // Only request the space available.
    //
    sSetupPacket.wLength = (uint16_t)ui32Size;

    //
    // Put the setup packet in the buffer.
    //
    ui32BytesReturned =
        USBHCDControlTransfer(0, &sSetupPacket, psDevice, pui8Buffer, ui32Size,
                              psDevice->sDeviceDescriptor.bMaxPacketSize0);

    //
    // Return the number of bytes in the string.
    //
    return(ui32BytesReturned);
}

//*****************************************************************************
//
//! This function is used to send the set address command to a device.
//!
//! \param ui32DevIndex is the index of the device whose address is to be
//! set.  This value must be 0 to indicate that the device is connected
//! directly to the host controller.  Higher values indicate devices connected
//!  via a hub.
//! \param ui32DevAddress is the new device address to use for a device.
//!
//! The USBHCDSetAddress() function is used to set the USB device address, once
//! a device has been discovered on the bus.  This call is typically issued
//! following a USB reset triggered by a call the USBHCDReset().  The
//! address passed into this function via the \e ui32DevAddress parameter is
//! used for all further communications with the device after this function
//! returns.
//!
//! \return None.
//
//*****************************************************************************
void
USBHCDSetAddress(uint32_t ui32DevIndex, uint32_t ui32DevAddress)
{
    tUSBRequest sSetupPacket;

    //
    // This is a Standard Device OUT request.
    //
    sSetupPacket.bmRequestType =
        USB_RTYPE_DIR_OUT | USB_RTYPE_STANDARD | USB_RTYPE_DEVICE;

    //
    // Request a Device Descriptor.
    //
    sSetupPacket.bRequest = USBREQ_SET_ADDRESS;
    sSetupPacket.wValue = ui32DevAddress;

    //
    // Index is always 0 for device requests.
    //
    sSetupPacket.wIndex = 0;

    //
    // Only request the space available.
    //
    sSetupPacket.wLength = 0;

    //
    // Put the setup packet in the buffer.
    //
    USBHCDControlTransfer(0, &sSetupPacket,
                          &g_sUSBHCD.psUSBDevice[ui32DevIndex], 0,
                          0, MAX_PACKET_SIZE_EP0);

    //
    // Must delay 2ms after setting the address.
    //
    OS_DELAY(g_ui32Tickms * 2);
}

//*****************************************************************************
//
//! This function is used to send a Clear Feature request to a device.
//!
//! \param ui32DevAddress is the USB bus address of the device that will
//! receive this request.
//! \param ui32Pipe is the pipe that will be used to send the request.
//! \param ui32Feature is one of the USB_FEATURE_* definitions.
//!
//! This function will issue a Clear Feature request to the device indicated
//! by the \e ui32DevAddress parameter.  The \e ui32Pipe parameter is the USB
//! pipe that should be used to send this request.  The \e ui32Feature
//! parameter should be one of the following values:
//!
//! * \b USB_FEATURE_EP_HALT is used to end a HALT condition on a devices
//!   endpoint.
//! * \b USB_FEATURE_REMOTE_WAKE is used to disable a device's remote wake
//!   feature.
//! * \b USB_FEATURE_TEST_MODE is used take the USB device out of test mode.
//!
//! \return None.
//
//*****************************************************************************
void
USBHCDClearFeature(uint32_t ui32DevAddress, uint32_t ui32Pipe,
                   uint32_t ui32Feature)
{
    tUSBRequest sSetupPacket;
    uint32_t ui32Index;

    //
    // Get the index number from the allocated pipe.
    //
    ui32Index = (ui32Pipe & EP_PIPE_IDX_M);

    //
    // This is a Standard Device OUT request.
    //
    sSetupPacket.bmRequestType =
        USB_RTYPE_DIR_OUT | USB_RTYPE_STANDARD | USB_RTYPE_ENDPOINT;

    //
    // Request a Device Descriptor.
    //
    sSetupPacket.bRequest = USBREQ_CLEAR_FEATURE;
    sSetupPacket.wValue = ui32Feature;

    //
    // Set the endpoint to access.
    //
    if(ui32Pipe & EP_PIPE_TYPE_IN)
    {
        sSetupPacket.wIndex = g_sUSBHCD.psUSBINPipes[ui32Index].ui8EPNumber |
                              0x80;
    }
    else
    {
        sSetupPacket.wIndex = g_sUSBHCD.psUSBOUTPipes[ui32Index].ui8EPNumber;
    }

    //
    // This is always 0.
    //
    sSetupPacket.wLength = 0;

    //
    // Put the setup packet in the buffer.
    //
    USBHCDControlTransfer(0, &sSetupPacket,
                          &g_sUSBHCD.psUSBDevice[ui32DevAddress - 1], 0, 0,
                          MAX_PACKET_SIZE_EP0);

    //
    // Set the endpoint to access.
    //
    if(ui32Pipe & EP_PIPE_TYPE_IN)
    {
        MAP_USBEndpointDataToggleClear(USB0_BASE,
                                       IndexToUSBEP(ui32Index + 1),
                                       USB_EP_HOST_IN);
    }
    else
    {
        MAP_USBEndpointDataToggleClear(USB0_BASE,
                                       IndexToUSBEP(ui32Index + 1),
                                       USB_EP_HOST_OUT);
    }

    //
    // Must delay 2ms after clearing the feature.
    //
    OS_DELAY(g_ui32Tickms * 2);
}

//*****************************************************************************
//
//! This function is used to set the current configuration for a device.
//!
//! \param ui32Index specifies which USB controller to use.
//! \param ui32Device is the USB device for this function.
//! \param ui32Configuration is one of the devices valid configurations.
//!
//! This function is used to set the current device configuration for a USB
//! device.  The \e ui32Configuration value must be one of the configuration
//! indexes that was returned in the configuration descriptor from the device,
//! or a value of 0.  If 0 is passed in, the device will return to it's
//! addressed state and no longer be in a configured state.  If the value is
//! non-zero then the device will change to the requested configuration.
//!
//! \return None.
//
//*****************************************************************************
void
USBHCDSetConfig(uint32_t ui32Index, uint32_t ui32Device,
                uint32_t ui32Configuration)
{
    tUSBRequest sSetupPacket;
    tUSBHostDevice *psDevice;

    ASSERT(ui32Index == 0);

    psDevice = (tUSBHostDevice *)ui32Device;

    //
    // This is a Standard Device OUT request.
    //
    sSetupPacket.bmRequestType =
        USB_RTYPE_DIR_OUT | USB_RTYPE_STANDARD | USB_RTYPE_DEVICE;

    //
    // Request a Device Descriptor.
    //
    sSetupPacket.bRequest = USBREQ_SET_CONFIG;
    sSetupPacket.wValue = ui32Configuration;

    //
    // Index is always 0 for device requests.
    //
    sSetupPacket.wIndex = 0;

    //
    // Only request the space available.
    //
    sSetupPacket.wLength = 0;

    //
    // Put the setup packet in the buffer.
    //
    USBHCDControlTransfer(0, &sSetupPacket, psDevice, 0, 0,
                          MAX_PACKET_SIZE_EP0);
}

//*****************************************************************************
//
//! This function is used to set the current interface and alternate setting
//! for an interface on a device.
//!
//! \param ui32Index specifies which USB controller to use.
//! \param ui32Device is the USB device for this function.
//! \param ui32Interface is one of the valid interface numbers for a device.
//! \param ui32AltSetting is one of the valid alternate interfaces for the
//! \e ui32Interface number.
//!
//! This function is used to change the alternate setting for one of the valid
//! interfaces on a USB device.  The \e ui32Device specifies the device
//! instance that was returned when the device was connected.  This call will
//! set the USB device's interface based on the \e ui32Interface and
//! \e ui32AltSetting.
//!
//! \b Example: Set the USB device interface 2 to alternate setting 1.
//!
//! \verbatim
//! USBHCDSetInterface(0, ui32Device, 2, 1);
//! \endverbatim
//!
//! \return None.
//
//*****************************************************************************
void
USBHCDSetInterface(uint32_t ui32Index, uint32_t ui32Device,
                   uint32_t ui32Interface, uint32_t ui32AltSetting)
{
    tUSBRequest sSetupPacket;
    tUSBHostDevice *psDevice;

    ASSERT(ui32Index == 0);

    psDevice = (tUSBHostDevice *)ui32Device;

    //
    // This is a Standard Device OUT request.
    //
    sSetupPacket.bmRequestType =
        USB_RTYPE_DIR_OUT | USB_RTYPE_STANDARD | USB_RTYPE_INTERFACE;

    //
    // Request a Device Descriptor.
    //
    sSetupPacket.bRequest = USBREQ_SET_INTERFACE;

    //
    // Index is the interface to access.
    //
    sSetupPacket.wIndex = ui32Interface;

    //
    // wValue is the alternate setting.
    //
    sSetupPacket.wValue = ui32AltSetting;


    //
    // Only request the space available.
    //
    sSetupPacket.wLength = 0;

    //
    // Put the setup packet in the buffer.
    //
    USBHCDControlTransfer(0, &sSetupPacket, psDevice, 0, 0,
                          MAX_PACKET_SIZE_EP0);
}
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
