CynaraKrewe/Cynara/(commit log)

2016-05-11 Added pin and interconnect descriptions.
2016-05-18 Added Cynara carrier schematic and layout.
    [Cynara Viride.brd, Cynara Viride.sch]
2016-05-24 [WIP] Moved FPGA and MCU to make space for Ethernet and USB.
    [Cynara Viride.brd, Cynara Viride.sch]
2016-05-25 Layout for Ethernet and USB 2.0. Fixed problem with VREFA+ being too close to EPI clock signal.
    [Cynara Viride.brd, Cynara Viride.sch]
2016-05-27 Updated documentation. Added information about trace lengths of the EPI bus. Minor fixes in pictures.
    [lengthEPI.ods]
2016-05-28 FPGA and C's around the FPGA are snapped to grid again. Small reroute of USB differential pair.
    [Cynara Viride.brd]
2016-05-28 Fixed trace width and spacing issue after reroute of USB differential pair.
    [Cynara Viride.brd]
2016-05-28 All Petals are connected in the layout.
    [Cynara Viride.brd]
2016-05-29 Added proposal for power routing to the Petals.
    [Cynara Viride.brd, Cynara Viride.sch]
2016-06-01 updated imperial values of pcb build-up
2016-06-01 Completed routing for the power rails.
    [Cynara Viride.brd]
2016-06-08 Added VBUS detect circuitry. Drill size of mounting holes is 3.5 mm to fit M3 bolts.
    [Cynara Viride.brd, Cynara Viride.sch]
2016-06-11 Proper mounting holes. Small change in layout of +1.2V plane. Enhanced USB connector symbol. Added shield conenctions.
    [Cynara Viride.brd, Cynara Viride.sch]
2016-06-29 Changed microcontroller symbol to one a functional and power part. Renamed Petal signals. Shield for Ethernet and USB is a polygon now.
    [Cynara Viride.brd, Cynara Viride.sch]
2016-06-29 Added jumpers to disconnect the different power rails.
    [Cynara Viride.brd, Cynara Viride.sch]
2016-07-12 Added more test points.
    [Cynara Viride.brd, Cynara Viride.sch]
2016-07-12 Renamed pin mux configuration.
2016-07-26 Blinky supports controlling GPIO by means of JSON over the UART. Cleaned up startup and linker script.
2016-07-27 Added missing change in TivaWare debug header.
    [debug.h]
2016-07-27 Removed warning in Release build. Added appropriate C bindings to TivaWare debug header.
    [debug.h, main.cpp, startup_gcc.c]
2016-07-28 Moved flow and tm4c specific features to their respective directories.
    [configuration.h]
2016-07-28 Added tests for flow using CppUTest library.
2016-07-29 Added tests for connections and ports.
    [configuration.h]
2016-07-29 Added tests for Invert and Toggle components.
    [component_invert_tests.cpp, component_toggle_tests.cpp]
2016-09-02 Added more tests for Flow.
2016-09-22 Blinky includes a USB CDC connection with registered VID/PID codes. Timer component now runs in systick interrupt context.
2016-09-23 Use the Pin Mux Tool to generate the pin mux configuration.
    [summary.csv]
2016-10-04 Switches control the timer period in the blinky application.
2016-10-19 Cleaned up slikscreen in board layout. Moved tm4c components to their own header/source. Added basic PWM component.
    [Cynara Viride.brd, summary.csv]
2016-10-27 Added PWM on one of the LEDs of the EK-TM4C129EXL.
2016-10-27 Blinky is just blinky.
    [summary.csv]
2016-10-27 Moved flow and tm4c source code so it can be shared between projects.
2016-10-27 Fixed unit test project for flow.
    [summary.csv]
2016-10-27 Added sandbox project.
    [summary.csv]
2016-10-28 Added inter-project dependencies for correct build order. Added debug functionality to Flow. TM4C UART component is configurable.
    [debug.h, main.cpp, startup_gcc.c, uart.cpp]
2016-11-29 Added documentation for Cynara Flow (Software).
2017-07-08 Initial add of the SuperDongle KiCad project.
    [SuperDongle.kicad_pcb, SuperDongle.sch]
2017-07-08 Added IC lib + start of micro dongle
    [MicroDongle.kicad_pcb, MicroDongle.sch]
2017-07-09 added USB connector
2017-07-09 added usb footprint
