CynaraKrewe/Cynara/(notices)

Notices in the files:
Hardware/Cynara Viride.sch:
CDS: © 2015 Sioux Embedded Systems bv, Eindhoven, The Netherlands
